keyestudio/KS0523-4WD-Mechanical-Robot-Arm-Smart-Car/index.rst

.. toctree::
   :maxdepth: 5
   :caption: KS0523 4WD Mechanical Robot Arm Smart Car

   KS0523.md
