keyestudio/KS0523-4WD-Mechanical-Robot-Arm-Smart-Car/KS0523.md

# **KS0523 4WD Mechanical Robot Arm Smart Car**

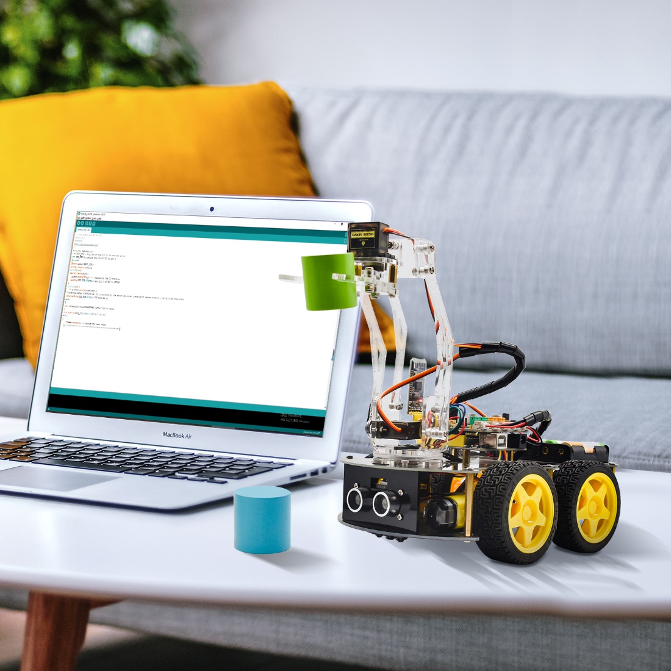
[picture p1: media/93024eaf6fdfefaf04d334aa68db944c.jpeg]


## Description

As science and technology develops by leaps and bounces, human society moves
towards an era of intelligence and automation as well.

Our hands are weak and unresistant to ultra-cold and high temperature
environment. In this regard, mechanical arms can totally supplant our hands and
work for people.

At present, KEYES group has designed this kind of smart mechanical arm car to
tackle the shortcomings of most robot arms, clumsy and fixed. This mechanical
smart car reacts and performs its functions by following commands sent by the
cellphone connected.

## Features

Multi-purpose Function: Anti-fall, obstacle avoidance, following, IR remote
control, line tracking, automatically convey and so on.

Easy to Build: soldering circuit is not required.

High Tenacity: high performance car baseplate and metal mechanical arm

High Extension: expand other sensors and modules through motor driver shield.

Multiple Controls: IR remote control, fully automatic and App control(iOS and
Android system)

Basic Programming：C language code learning.

## Specification

-   Working voltage: 5v

-   Input voltage: 7-12V

-   Maximum output current: 3A

-   Maximum power dissipation: 25W (T=75℃)

-   Motor speed: 5V 63 rpm / min

-   Motor drive form: TB6612 drive

-   Ultrasonic sensing angle: \<15 degrees

-   Ultrasonic detection distance: 2cm-400cm

-   Bluetooth remote control distance: 20-50 meters (measured)

-   Bluetooth APP control: support Android and iOS system

## Product Kit

| \##| Name | QTY | Picture |
|----|---|-----|---|
| 1  | Car Wheels 68\*26mm | 4 |  |
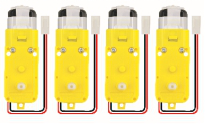
[picture p2: media/48959ebc4cbb2bbcdde2ef744a59845e.png]
| 2  | 4.5V 200rpm Motor | 4 |  |
| 3  | KEYESTUDIO PCB Baseplate for 4WD Smart Car V2.0 | 1 |  |
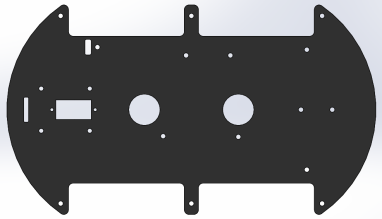
[picture p3: media/f55527de360c626bddf1b96a414f4ddc.png]
| 4  | KEYESTUDIO 4WD Top Board | 1 |  |
| 5  | Fixing Parts | 4 |  |
| 6  | KEYESTUDIO Quick Connectors Line Tracking Sensor | 1 |  |
| 7  | KEYESTUDIO Quick Connectors Ultrasonic Sensor | 1 |  |
| | | | |
| | | | |
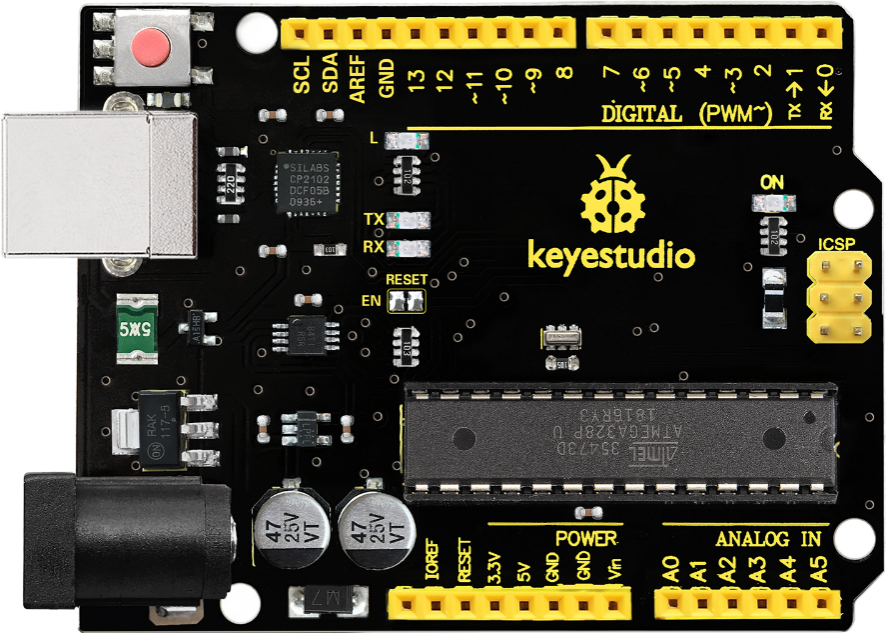
[picture p4: media/bd09f33acf28418b442de2a6e6a12eee.png]
| 8  | KEYESTUDIO V4.0 Development Board (Compatible Arduino Uno) | 1 |  |
| | | | |
| | | | |
| | | | |
| | | | |
| 9  | KEYESTUDIO TB6612 Motor Driver Shield | 1 |  |
| | | | |
| | | | |
| | | | |
| | | | |
| 10 | KEYESTUDIOHM-10 Bluetooth-4.0 V3 Module | 1 |  |
| | | | |
| 11 | KEYESTUDIO Quick Connectors IR Receiver | 1 |  |
| | | | |
| | | | |
| | | | |
| | | | |
| | | | |
| | | | |
| 12 | M2+M3 Wrench | 1 |  |
| 13 | KEYESTUDIO IR Remote Control | 1 |  |
| | | | |
| 14 | 18650 Battery Holder | 1 |  |
| | | | |
| | | | |
| | | | |
| | | | |
| 15 | 6-Slot AA Battery Holder | 1 |  |
| | | | |
| | | | |
| | | | |
| | | | |
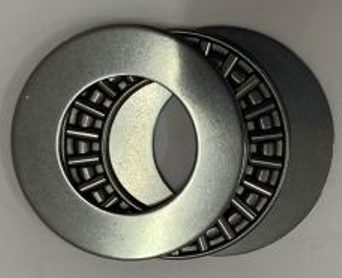
[picture p5: media/988bae05b3f6d02676c532adedece7c2.png]
| 16 | AXK Plain Bearing | 1 |  |
| | | | |
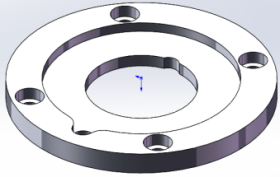
[picture p6: media/f3dc2b51d3d1f087ee034fb55b9fb7df.png]
| 17 | Bearing Cap （attached a yellow protective film） | 1 |  |
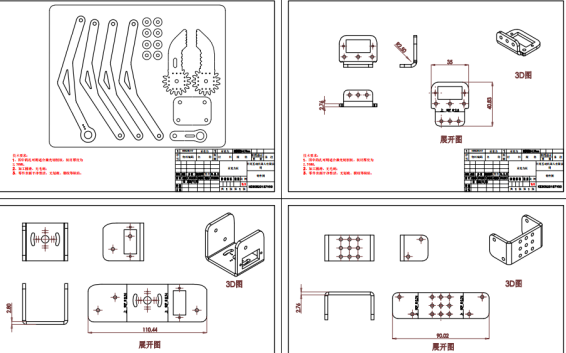
[picture p7: media/892303c46b050c0fb7cb775305685271.png]
| 18 | 19Pcs Acrylic Robot Arm Parts T=3mm | 1 |  |
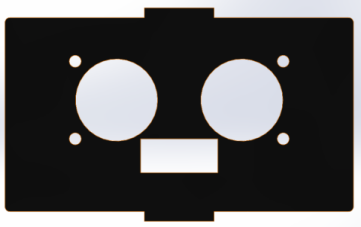
[picture p8: media/012500cac601bc526e0f18ce12cb2f6d.png]
| 19 | 73\*44MM Black Acrylic Board | 1 |  |
| 20 | Dual-head JST-PH2.0MM-5P 24AWG Dupont Wire 15CM Lead | 1 |  |
| | | | |
| | | | |
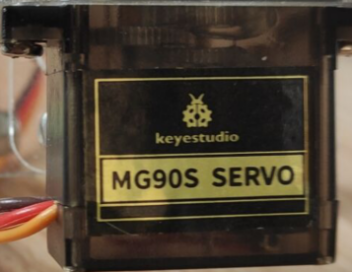
[picture p9: media/1dd13302041098798ba6626e98272e12.png]
| 21 | KEYESTUDIO MG90S 14G Servo | 3 |  |
| | | | |
| | | | |
| | | | |
| 22 | Dual-head JST-PH2.0MM-3P 24AWG 8CM Dupont Wire | 1 |  |
| 23 | 2.0\*40MM Purple and Black Screwdriver | 1 |  |
| 24 | 8MM Winding Pipe | 1 |  |
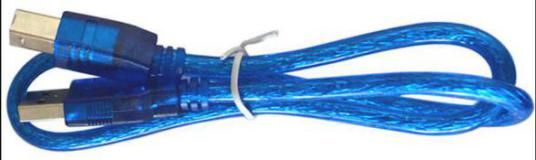
[picture p10: media/900d9583a767f7ddc92cc1082caa03f5.jpeg]
| 25 | USB Cable AM/BM OD:5.0 L=50cm | 1 |  |
| 26 | M3 Nickel Plated Nuts | 21  |  |
| 27 | M3\*30MM Round Head Screws | 8 | |
| 28 | M3\*6MM Round Head Screws | 38  |  |
| 29 | Dual-pass M3\*40MM Hex Copper Bush | 6 | |
| 30 | M3\*8MM Round Head Screws | 6 |  |
| 31 | Dual-pass M3\*10MM Hex Copper Bush | 4 | |
| 32 | M3\*10MM Flat Screws | 4 | |
| 33 | M1.4X6 Self-tapping Round Head Screws | 6 | |
| 34 | M2\*10MM Round Head Screws | 8 | |
| 35 | M2 Nickel Plated Nuts | 6 |  |
| 36 | M3\*10MM Round Head Screws | 8 | |
| 37 | M3\*12MM Round Head Screws | 6 | |
| 38 | M3\*16MM Round Head Screws | 2 | |
| 39 | M3 Nickel Plated Self-locking Nuts | 14  | |
| 40 | Dual-pass M3\*15MM Hex Copper Bush | 2 | |
| 41 | M2\*5MM Self-tapping Round Head Screws | 4 | |
| 42 | M1.2\*5MM Self-tapping Round Head Screws | 4 | |
| 43 | 20cm 3pin F-F Dupont Wire | 2 |  |
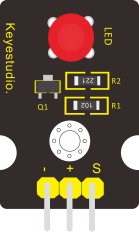
[picture p11: media/c302ce2fda045f9b0e2fbf05f4a6e7ee.png]
| 44 | KEYESTUDIO Red LED Module | 1 |  |
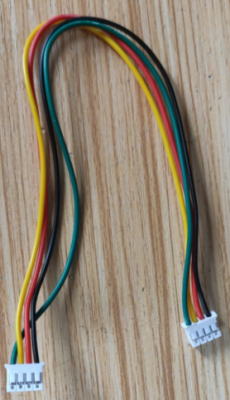
[picture p12: media/9d31ddba2c6df11d32870b55de5ce249.png]
| 45 | PH2.0mm-4P 24AWG 200MM Dupont Wire Eco-friendly | 1 |  |
| 46 | 3\*40MM Red and Black Screwdriver | 1 |  |
| 47 | Black Ties 3\*100MM | 6 | |
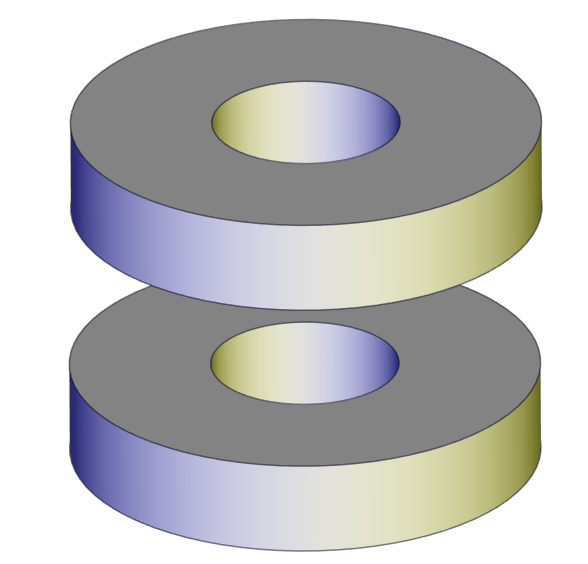
[picture p13: media/9f09c826368dc2cf7fc0449516f61399.png]
| 48 | Insulation Gasket | 4 |  |
| 49 | M2.5\*12MM Round Head Screws | 6 | |
| 50 | M2.5 Nickel Plated Nuts | 6 | |

## Getting Started with Arduino

1.  **Installing Arduino IDE**

When we get control board, we need to download Arduino IDE and driver in the
first place.

You can download Arduino IDE from the official website:

<https://www.arduino.cc/>, and click the **SOFTWARE \> DOWNLOADS**, as shown
below:

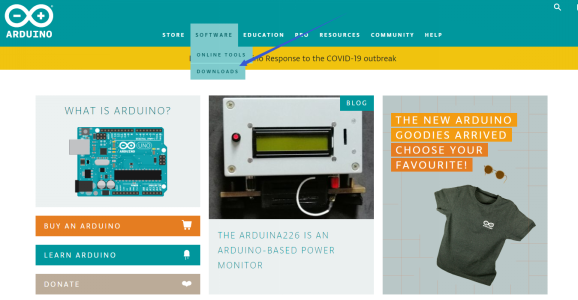
[picture p14: media/4636aac9aca9b3aa9d86580caac51b81.png]


There are many versions for Arduino software, and you only need to download the
version suitable for system. Here, we will take WINDOWS system as an example to
introduce how to download and install Arduino IDE.

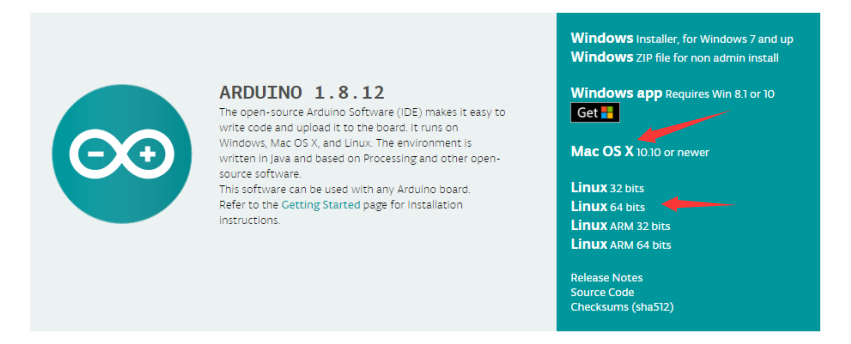
[picture p15: media/a964bfdcfb4a1ae25e5698623c5fc6bf.png]


There are two versions you can choose from, one is an installer which can be
directly downloaded in computer; the other is a zip file which requires you to
unzip and install it.

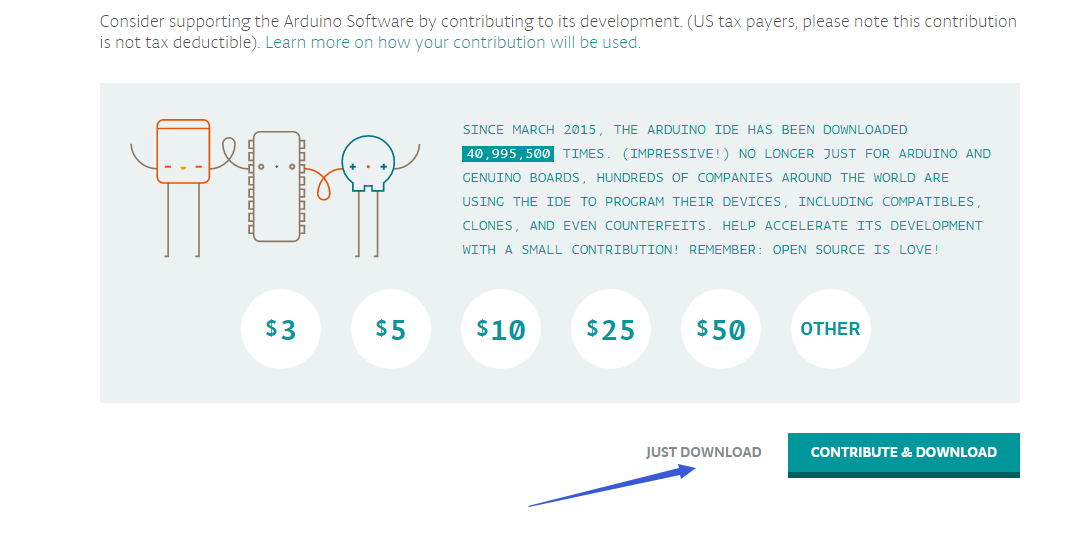
[picture p16: media/745910f7138b08d5cbcb557f194b0679.png]


Just click“JUST DOWNLOAD”.

1.  **KEYESTUDIO V4.0 Development Board**

You need to know that Keyestudio V4.0 development board is the core of this
smart car.



Keyestudio V4.0 development board is an Arduino uno -compatible board, which is
based on ATmega328P MCU, and with a cp2102 Chip as a UART-to-USB converter.

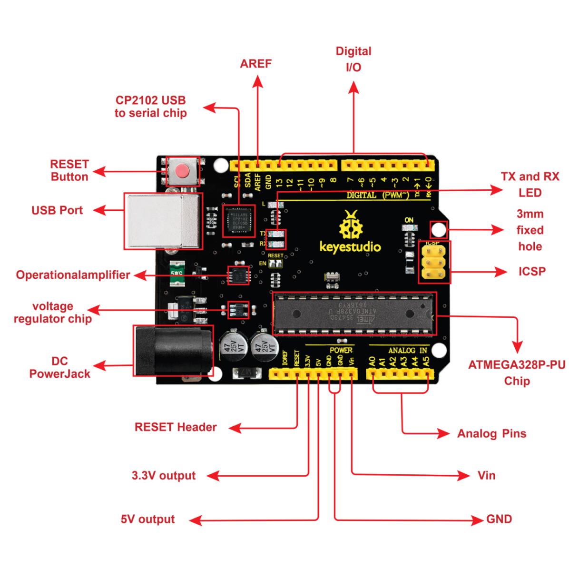
[picture p17: media/90e3efbcae2f75e4c40a6bb9c616365e.jpeg]
  
It has 14 digital input/output pins (of which 6 can be used as PWM outputs), 6
analog inputs, a 16 MHz quartz crystal, a USB connection, a power jack, 2 ICSP
headers and a reset button.

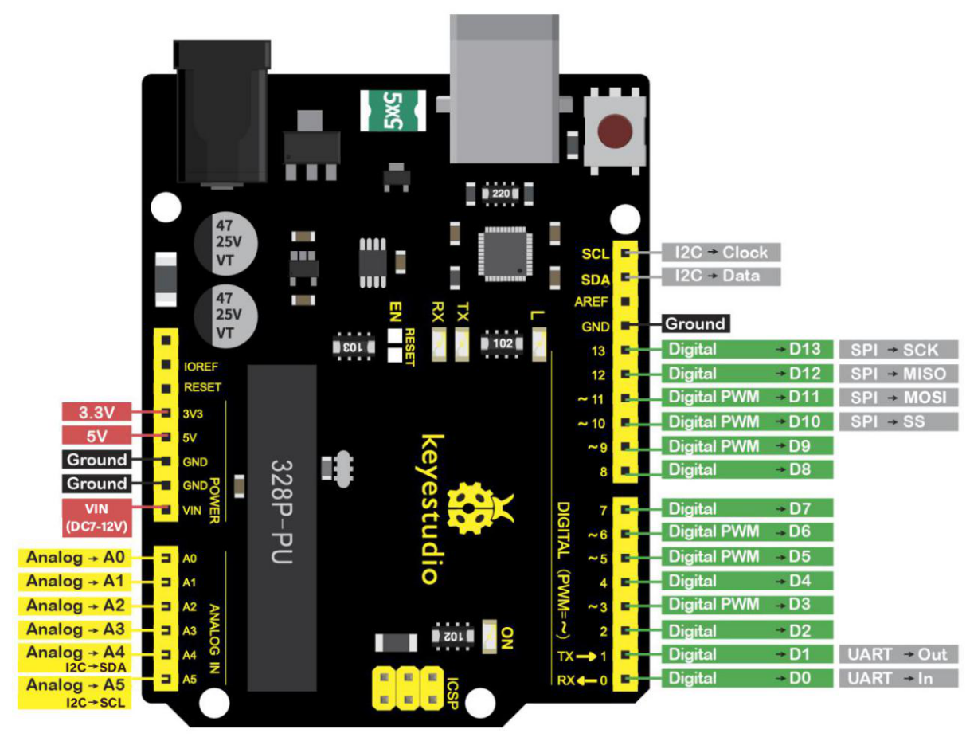
[picture p18: media/2321b7892f3e38262c2f32e324108b2f.png]


It contains everything needed to support the microcontroller. Simply connect it
to a computer with a USB cable or power it via an external DC power jack (DC
7-12V) or via female headers Vin/ GND(DC 7-12V) to get started.

| Microcontroller | ATmega328P-PU |
|---|---|
| Operating Voltage | 5V |
| Input Voltage (recommended) | DC7-12V |
| Digital I/O Pins | 14 (D0-D13) (of which 6 provide PWM output) |
| PWM Digital I/O Pins | 6 (D3, D5, D6, D9, D10, D11) |
| Analog Input Pins | 6 (A0-A5) |
| DC Current per I/O Pin | 20 mA |
| DC Current for 3.3V Pin | 50 mA |
| Flash Memory | 32 KB (ATmega328P-PU) of which 0.5 KB used by bootloader |
| SRAM | 2 KB (ATmega328P-PU) |
| EEPROM | 1 KB (ATmega328P-PU) |
| Clock Speed | 16 MHz |
| LED_BUILTIN | D13 |

1.  **Installing Driver of V4.0 Board**

Let’s install the driver of V4.0 board. The USB-TTL chip on PLUS board adopts
CP2102 serial chip. The driver program of this chip is included in Arduino 1.8
version and above, which is convenient.

if the version is not above 1.8, you need to download driver of CP2102 in the
link:

<https://www.silabs.com/products/development-tools/software/usb-to-uart-bridge-vcp-drivers>)

When you attach USB port to computer, the driver of CP2102 can be installed.

If you install unsuccessfully, or intend to install manually, please open the
device manager of computer. Right click Computer----- Properties----- Device
Manager.

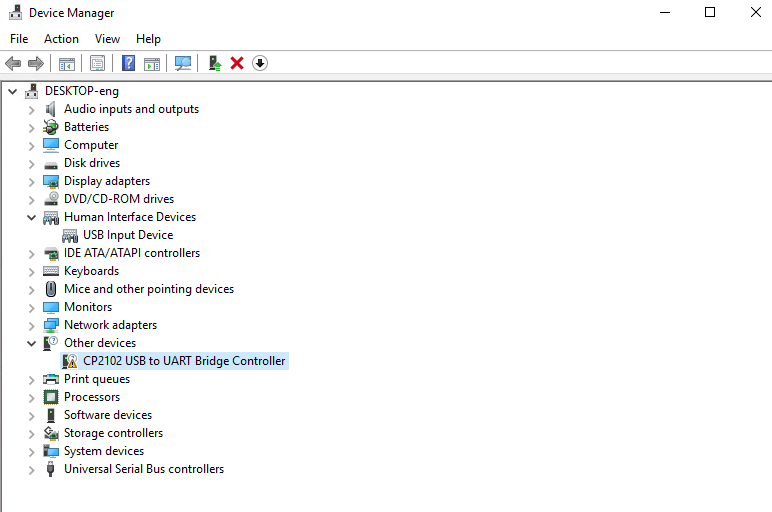
[picture p19: media/afa5b0dde9342bd7ad9f385333cb6f55.png]


There is a yellow exclamation mark on the page, which implies the failure
installation of the driver of CP2102.

Operate as follows；

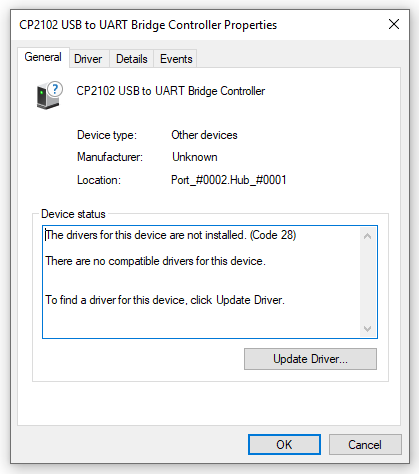
[picture p20: media/c26ca0ef1bf1506c815b6e3e239cf525.png]


Click “OK” to enter the following page and click “browse my computer for updated
driver software”.

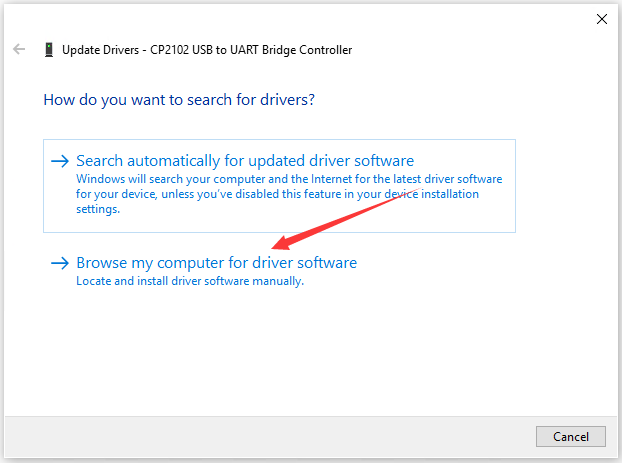
[picture p21: media/4ec7a5ea3c8a1fd9663eef4768b687c5.png]


Click “Browse”, then search the driver of CP2102 and click “Next”,

There is a DRIVERS folder in Arduino software installed
package（）, open driver folder
and check the driver of CP210X series chips.

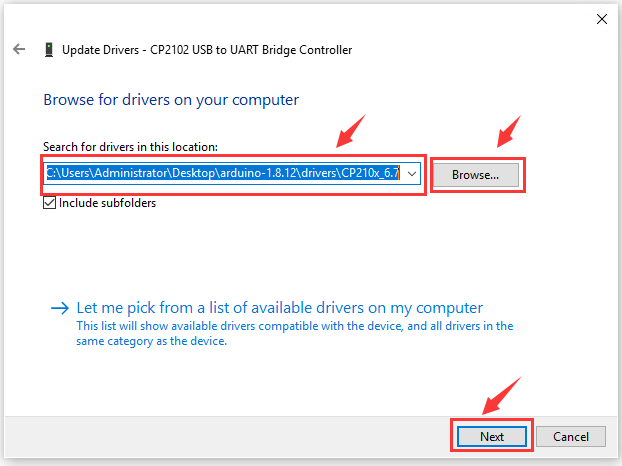
[picture p22: media/417de936fa9720c7a7427c4d07718292.png]


When opening the device manager, we will find the yellow exclamation mark
disappear. The driver of CP2102 is installed successfully.

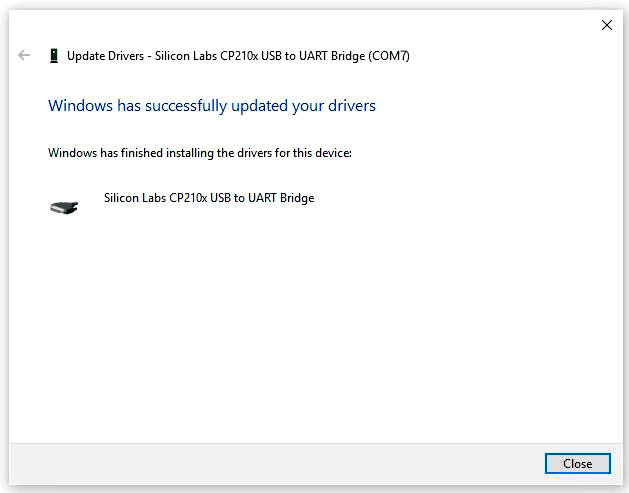
[picture p23: media/efce0ba96c48d853f302730b4d481ee9.jpeg]


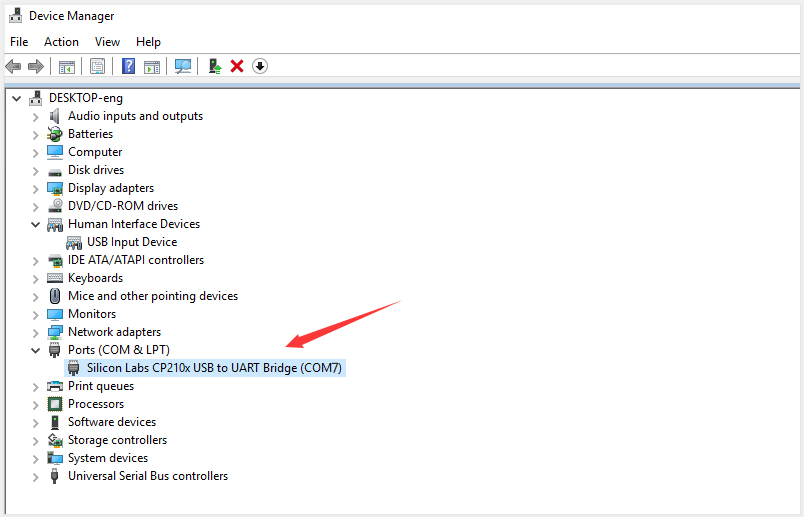
[picture p24: media/2f751d5f4e4c0c18fa862c589eaaf0da.jpeg]


1.  **Arduino IDE Setting**

Clickicon, and open Arduino IDE.

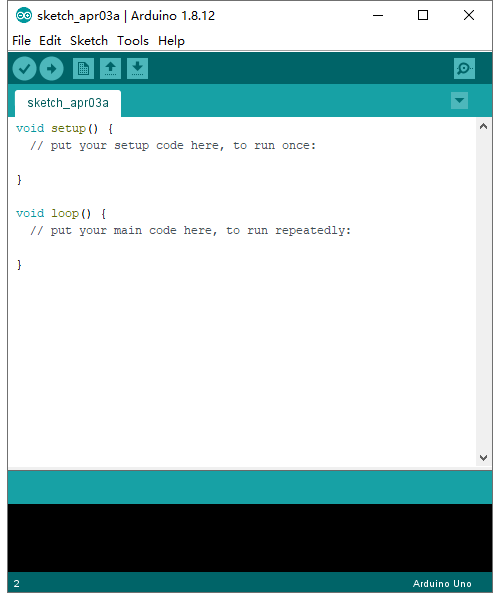
[picture p25: media/e9a2d59afcff8121d18d8767326baa42.png]


When downloading the sketch to the board, you must select the correct name of
Arduino board that matches the board connected to your computer. As shown below;

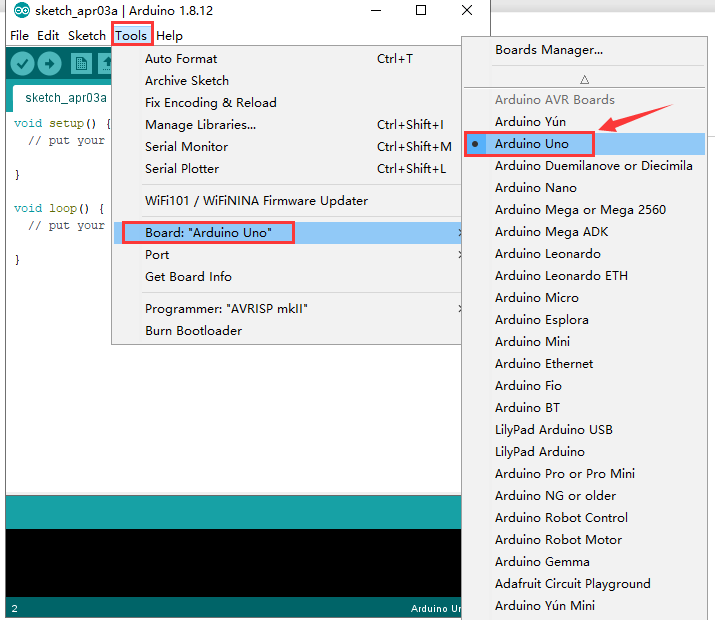
[picture p26: media/84317a7babddff172520b99756dc1f85.png]


Then select the correct COM port (you can see the corresponding COM port after
the driver is successfully installed)

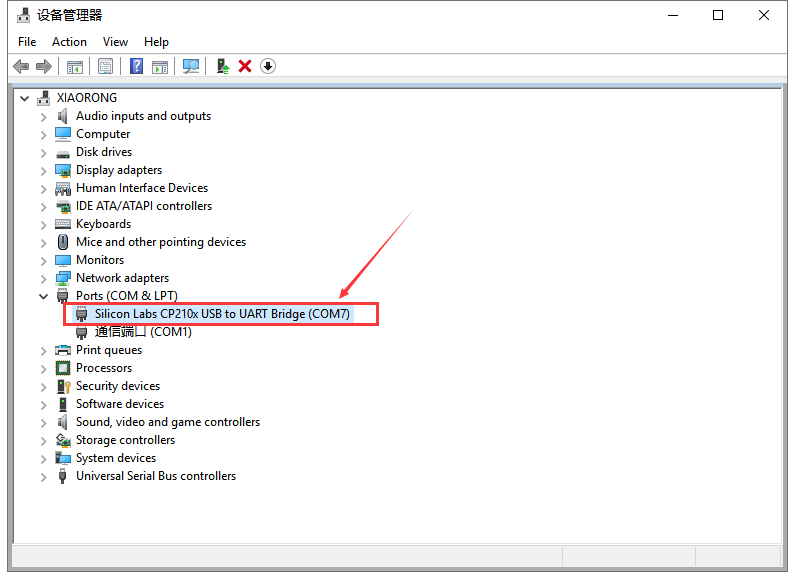
[picture p27: media/6ec68bee80c913c6ad392c6e7898ed36.png]


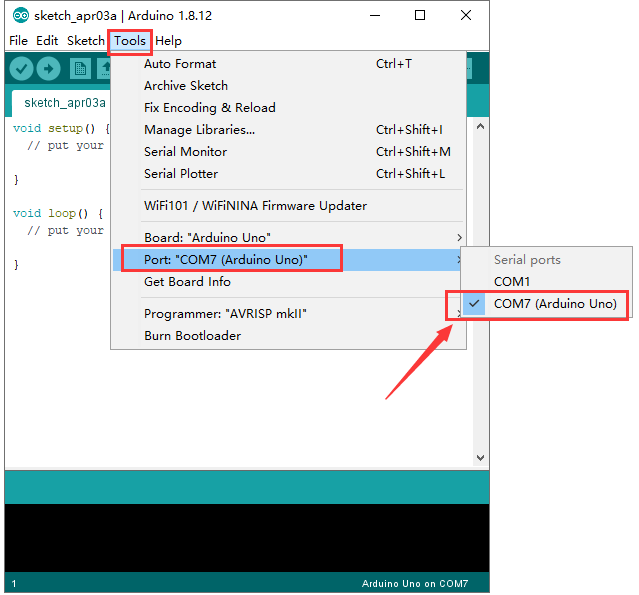
[picture p28: media/bcd36a3d3e1209c16866e554089832d5.png]


Before uploading the program to the board, let’s demonstrate the function of
each symbol in the Arduino IDE toolbar.

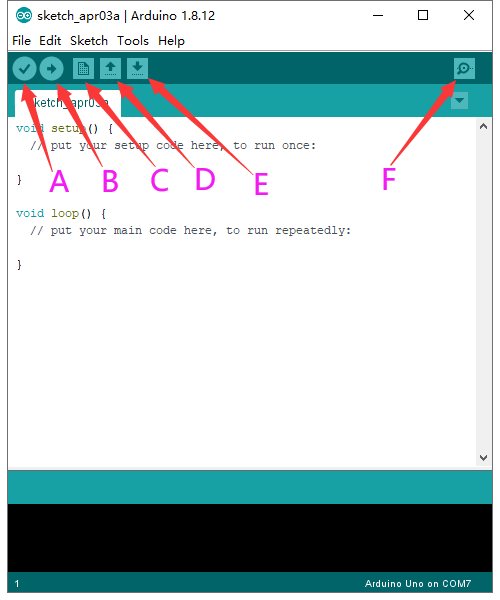
[picture p29: media/2598b31529ac4bff88630522b97b6c41.png]


A- Used to verify whether there is any compiling mistakes or not.  
B- Used to upload the sketch to your Arduino board.  
C- Used to create shortcut window of a new sketch.  
D- Used to directly open an example sketch.  
E- Used to save the sketch.  
F- Used to send the serial data received from board to the serial monitor.

**(5) Start Your First Program**

Open the file to select **Example**, and click **BASIC**\>**BLINK**, as shown
below:

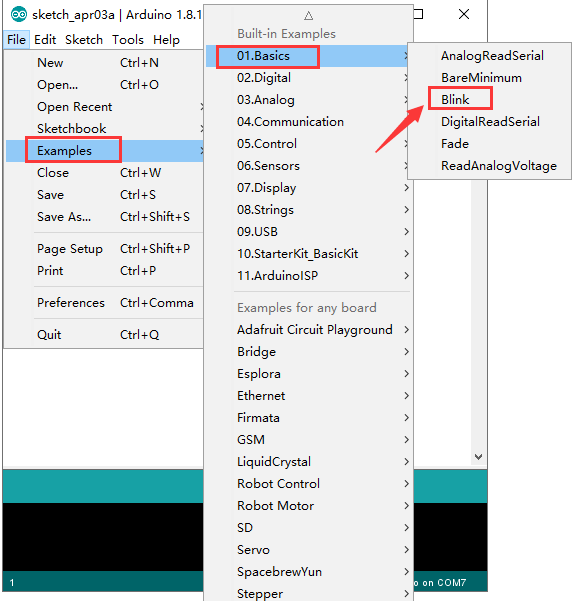
[picture p30: media/2a6a0b8b8e2585776e01873caf10a1b0.png]


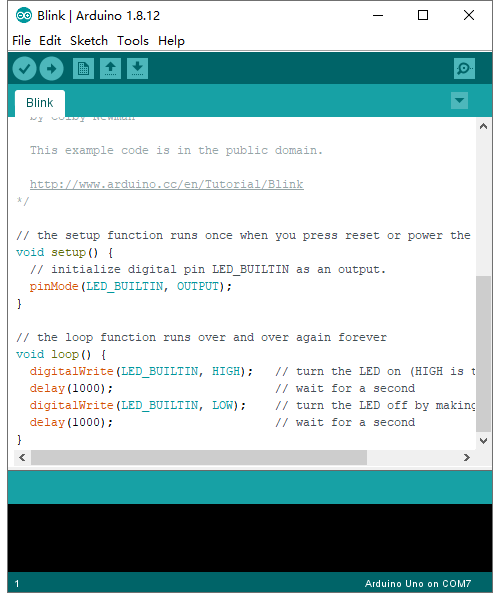
[picture p31: media/6030cde1341c3432f0f4b1fb6c92e49e.png]


Set board and COM port, the corresponding board and COM port are shown on the
lower right of IDE.

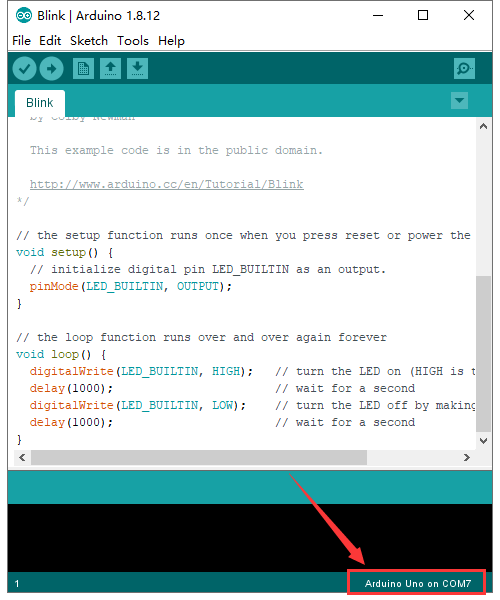
[picture p32: media/5c4521f3fa5c4f4c0a5c9d1581ab1580.png]


Clickto start compiling the
program, and check errors.

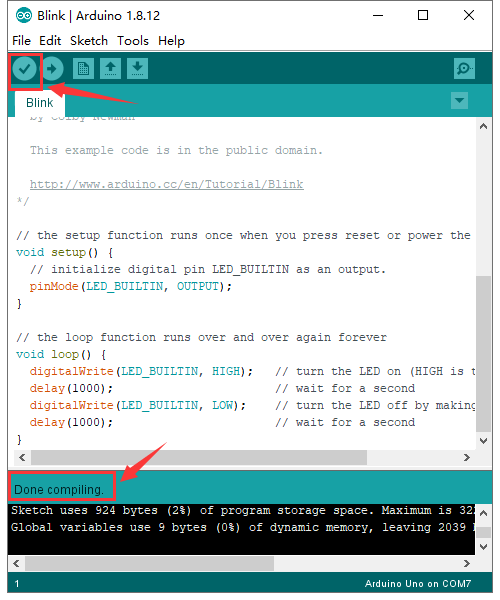
[picture p33: media/9948cd36a3b39cb57fd2bea79540c4b7.png]


Clickto upload the program,
upload successfully.

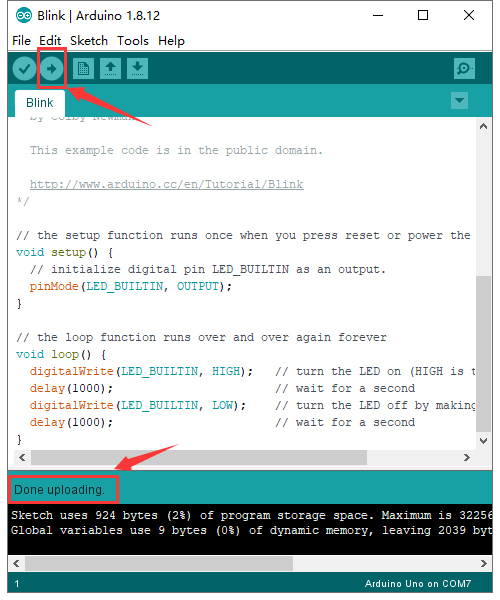
[picture p34: media/60e002aacf662c1ecf88ad3ecd85e6ca.png]


After the program is uploaded successfully, the onboard LED blinks.
Congratulation, you finish the first program.

**6.Add project Libraries**

**(1) What are Libraries ?**

[Libraries](https://www.arduino.cc/en/Reference/Libraries) are a collection of
code that makes it easy for you to connect to a sensor,display, module, etc.

For example, the built-in LiquidCrystal library helps talk to LCD displays.
There are hundreds of additional libraries available on the Internet for
downloading.

The built-in libraries and some of these additional libraries are listed in the
reference.

**(2) How to Install a Library ?**

Here we will introduce the most simple way for you to add libraries.  
\*\*Step 1：\*\*After downloading well the Arduino IDE, you can right-click the
icon of Arduino IDE.  
Find the option "Open file location" shown as below:

[

**Step 2:** Enter it to find out libraries folder, this folder is the library
file of Arduino.

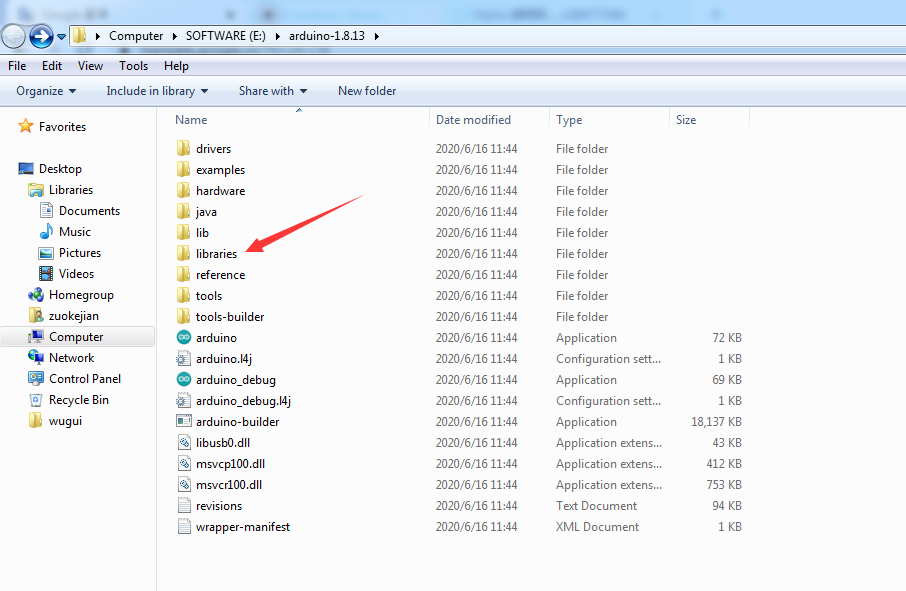
[picture p35: media/a67a5b5921be4dbc1b0ce92627111d15.png]


**Step 3：** Next to find out the“libraries”folder of robot arm car(seen in the
link:https://fs.keyestudio.com/KS0523), you just need to replicate and paste it
into the libraries folder of Arduino IDE.

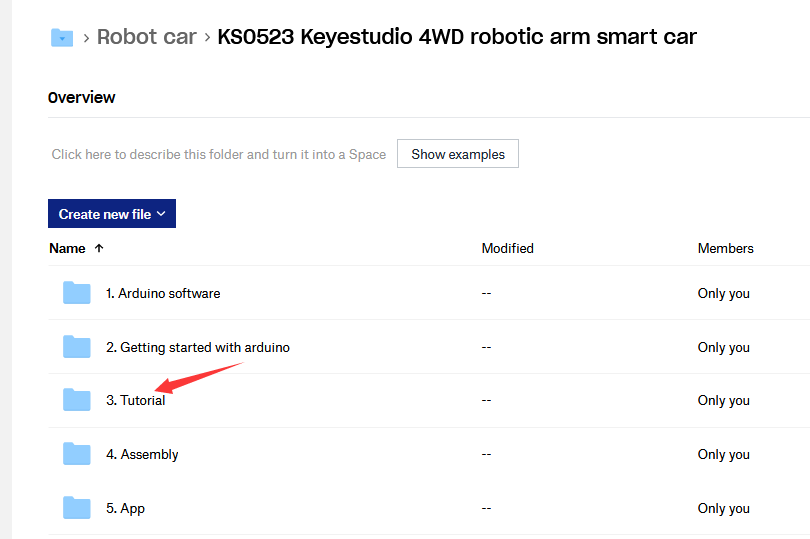
[picture p36: media/60a4210e42d3dc65af1157d37223203d.png]


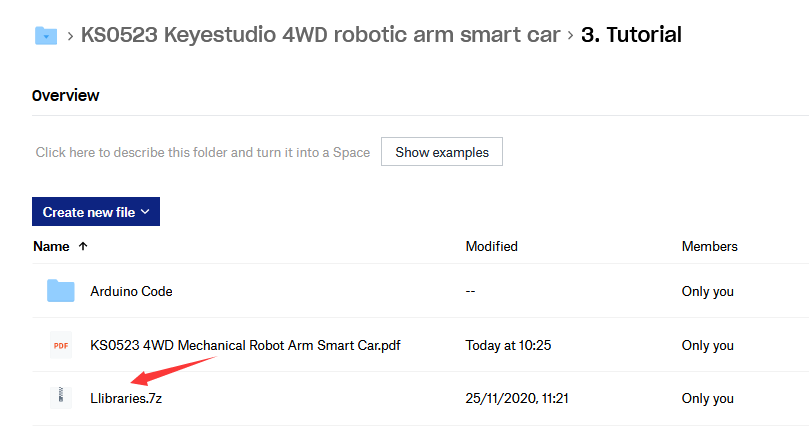
[picture p37: media/8630eea9defbecaf64c5fe32a0f0a2a5.png]


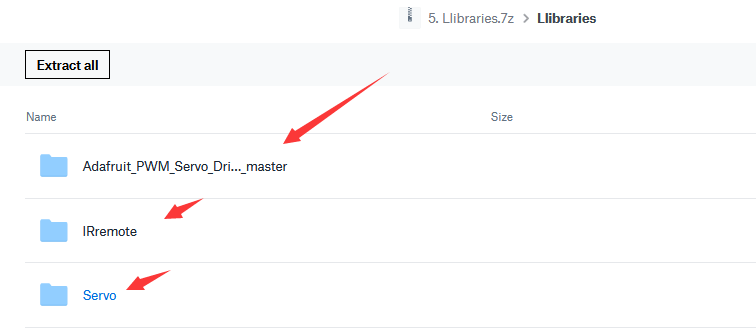
[picture p38: media/b96a3a692e4cc6014b4928c64a189ade.png]


Download the above libraries and copy them in the libraries of Arduino.

Then the libraries of robot arm car are installed successfully, as shown below:

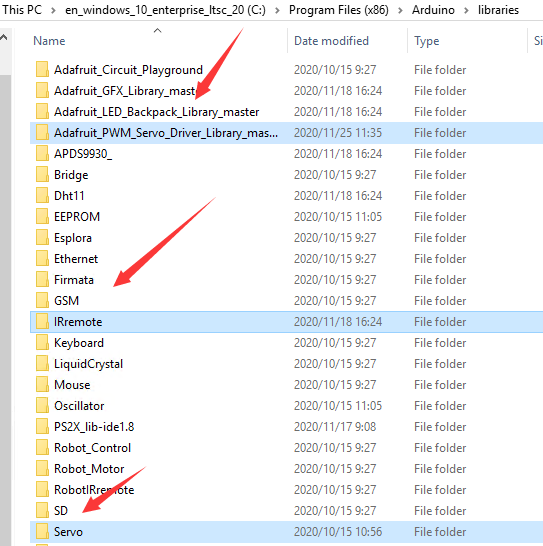
[picture p39: media/6900d5cd6168f00a89a282485eea1879.png]


## Install Robot Arm Smart Car

Note: Peel the plastic film off the board first when installing the smart car.

| | |
|---|---|
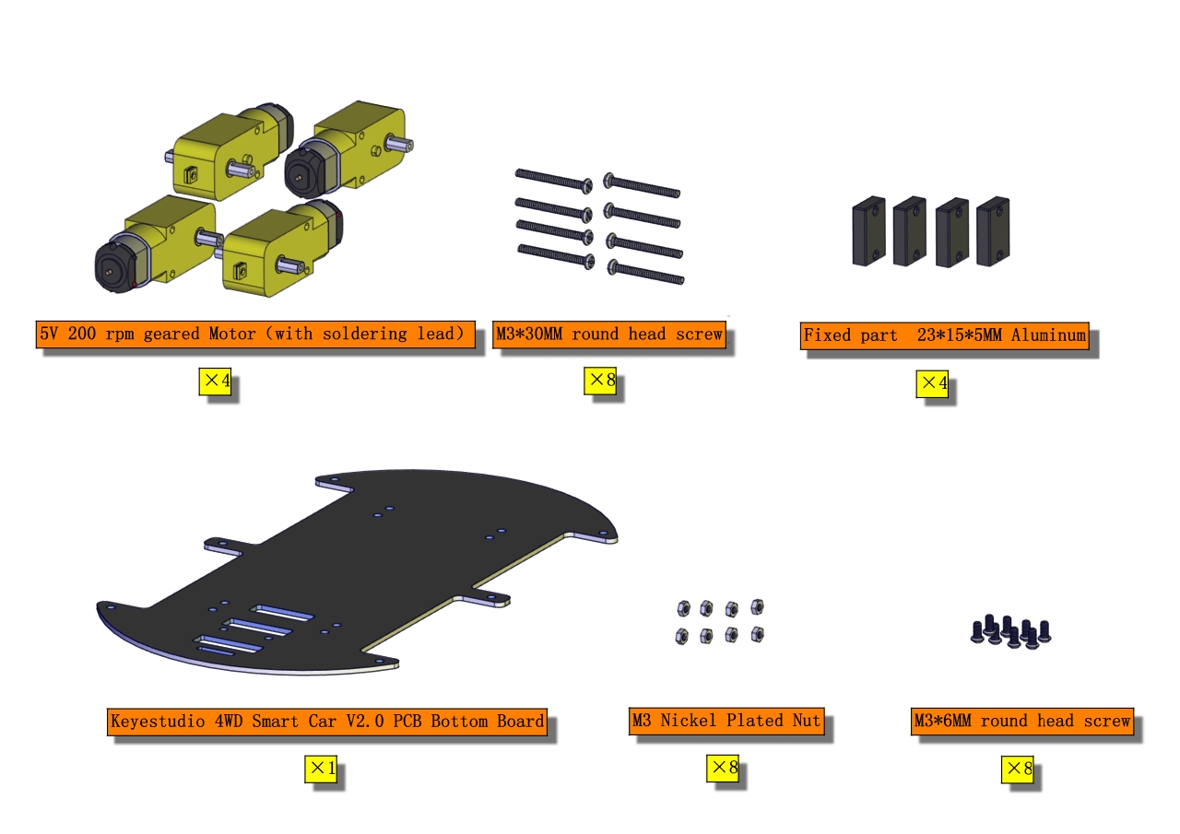
[picture p40: media/04228fa1b44016c5791f4582b0382988.jpeg]
|  | |
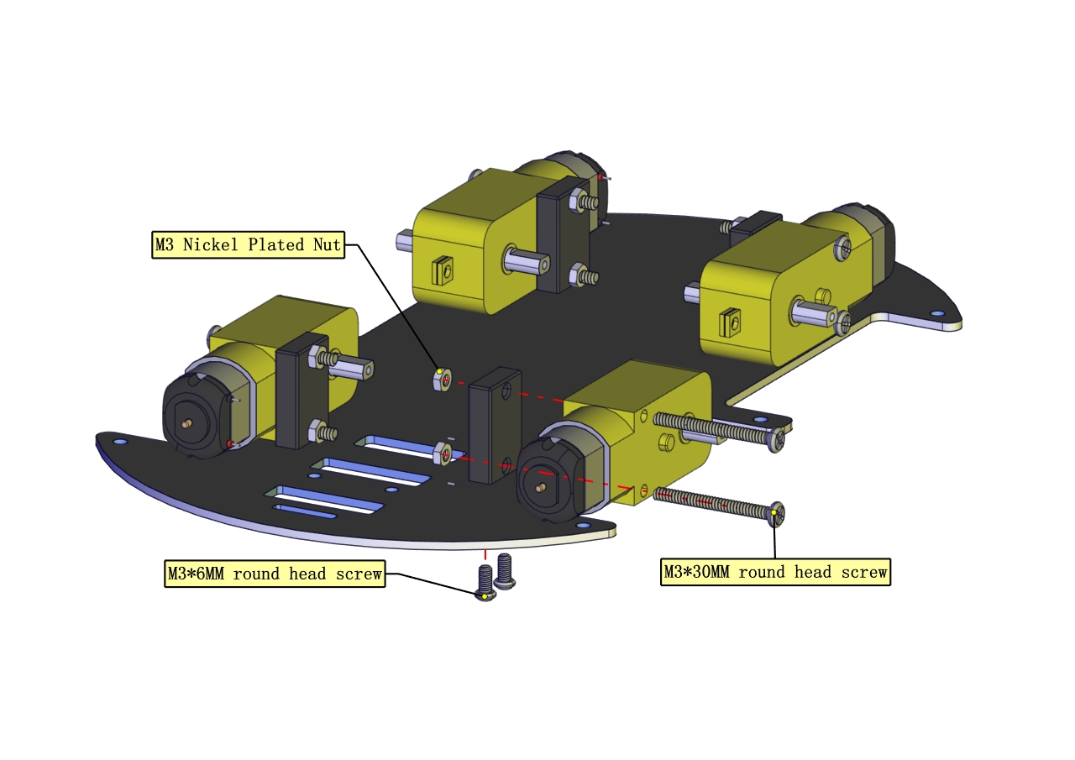
[picture p41: media/b1c4f0b202f8287268e8a97d3e3fb0a4.jpeg]
|  | |
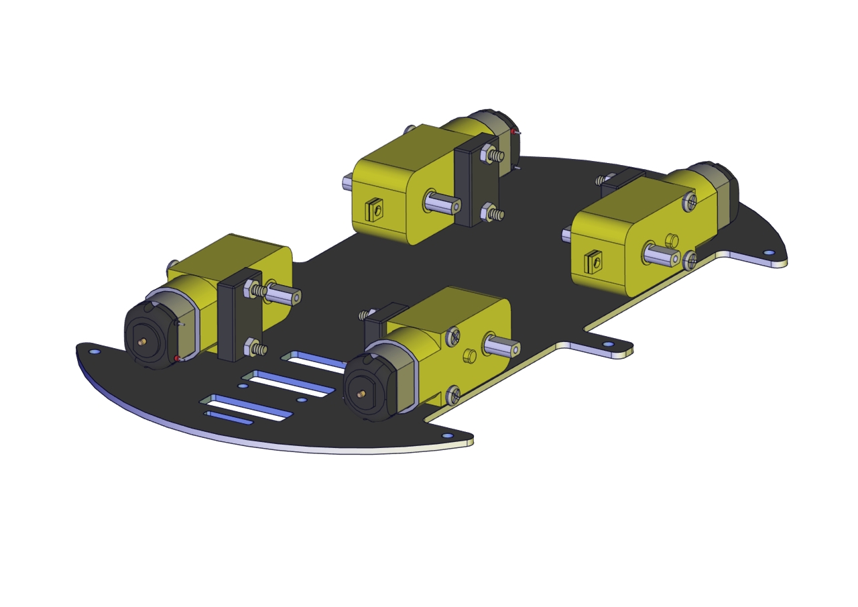
[picture p42: media/c263b9082c9447c8f7707f7199327132.jpeg]
|  | |
| | |
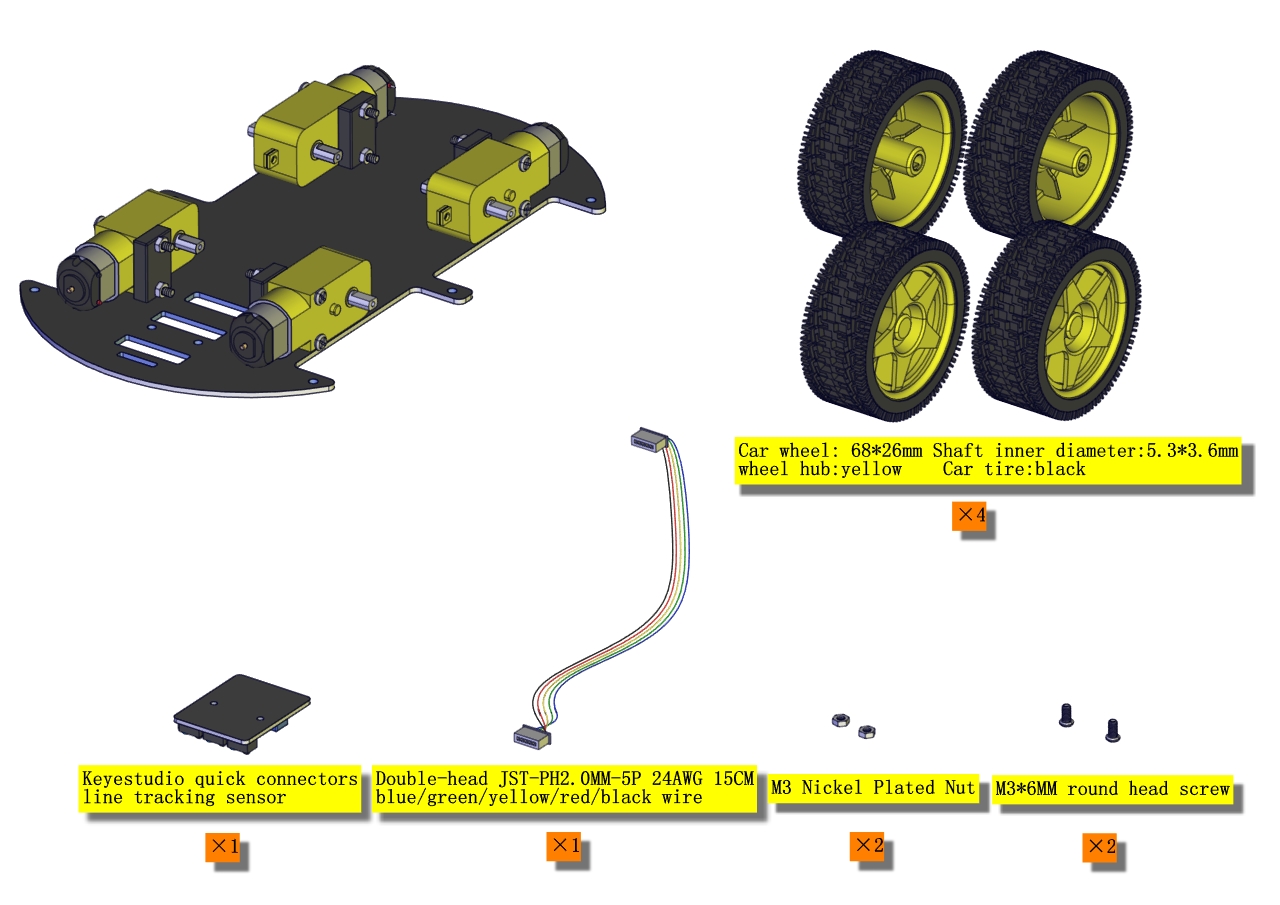
[picture p43: media/6cfe833aa78a7e776a8ab48183e1f633.jpeg]
|  | |
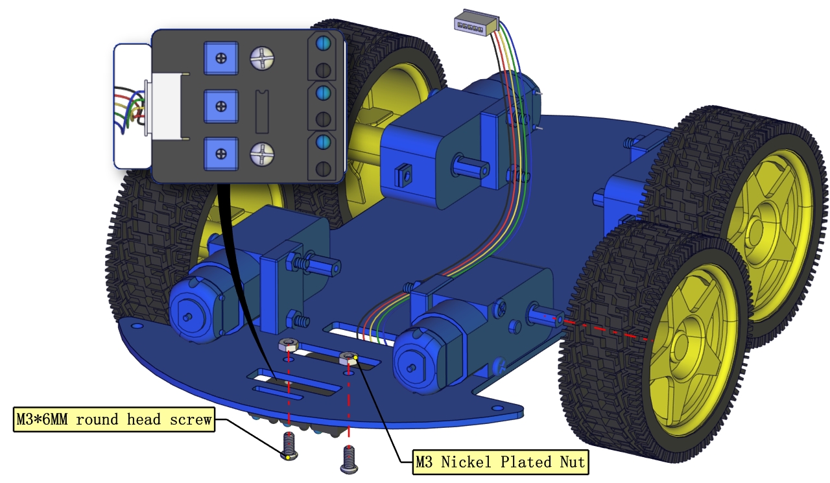
[picture p44: media/9959ae39832b42274bef49d9778197a6.jpeg]
|  | |
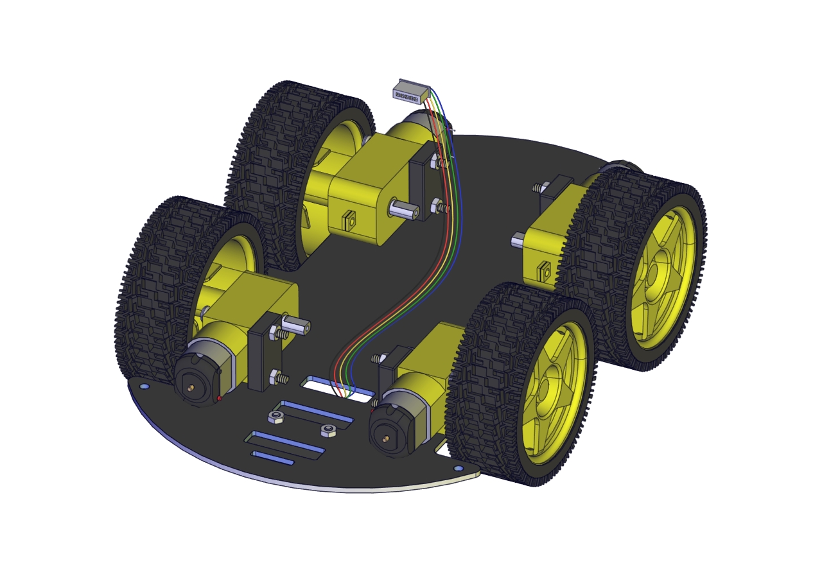
[picture p45: media/d6d31c652b8fafaf5c1c5ba9153d9075.jpeg]
|  | |
| | |
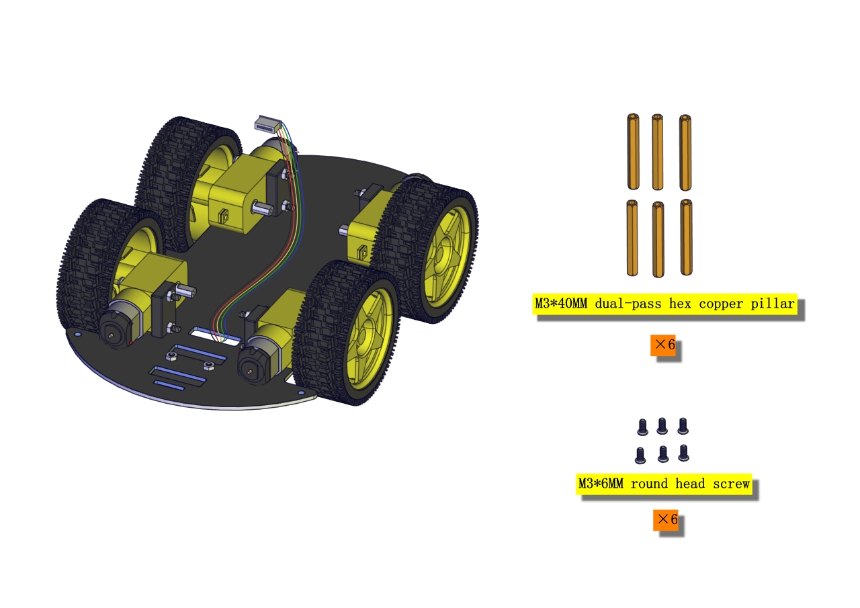
[picture p46: media/d432011907b2e322d57c9aebfbf8e48b.jpeg]
|  | |
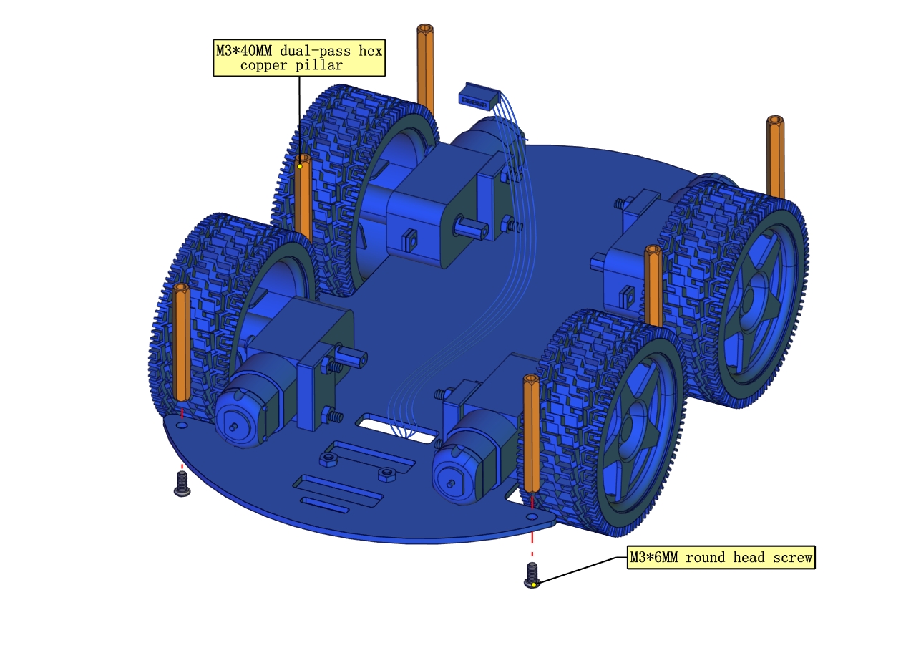
[picture p47: media/7c501be2c7d9e5129a4ddc23d70bad67.jpeg]
|  | |
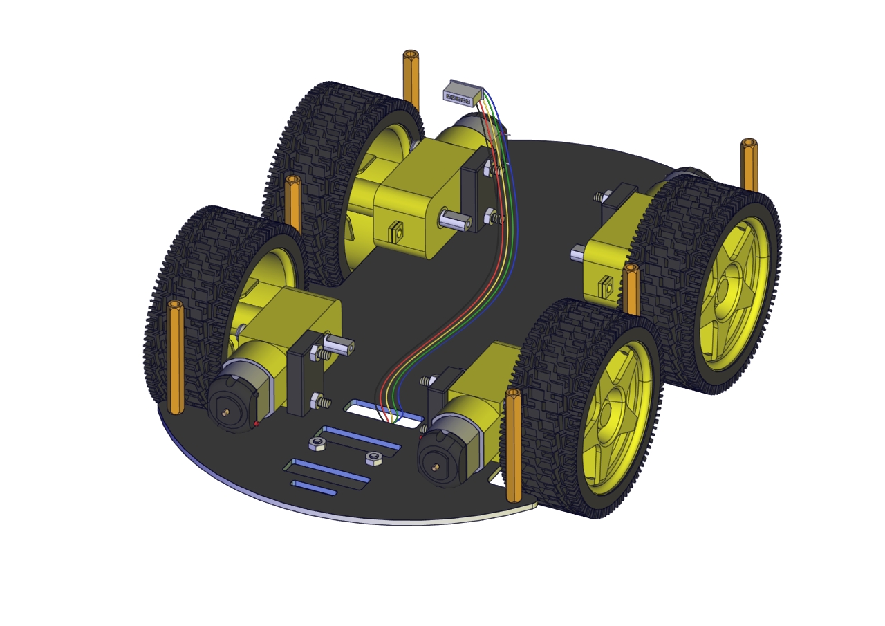
[picture p48: media/023af133ecb16c239d321f06770fbf5d.jpeg]
|  | |
| | |
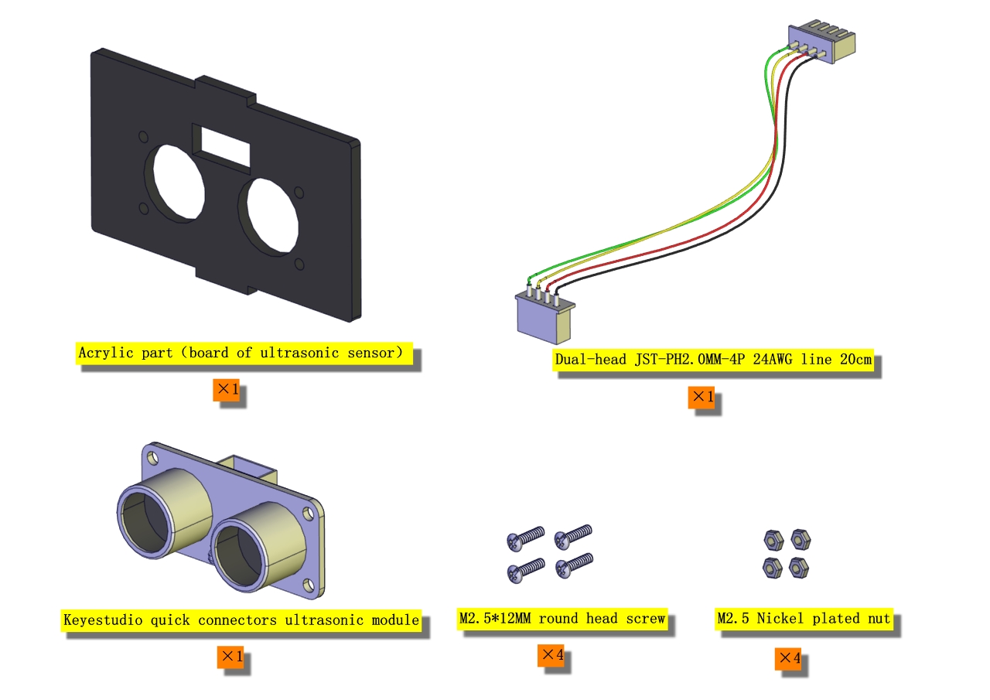
[picture p49: media/52c536ca6a4b2233f996e4939b09bfa5.jpeg]
|  | |
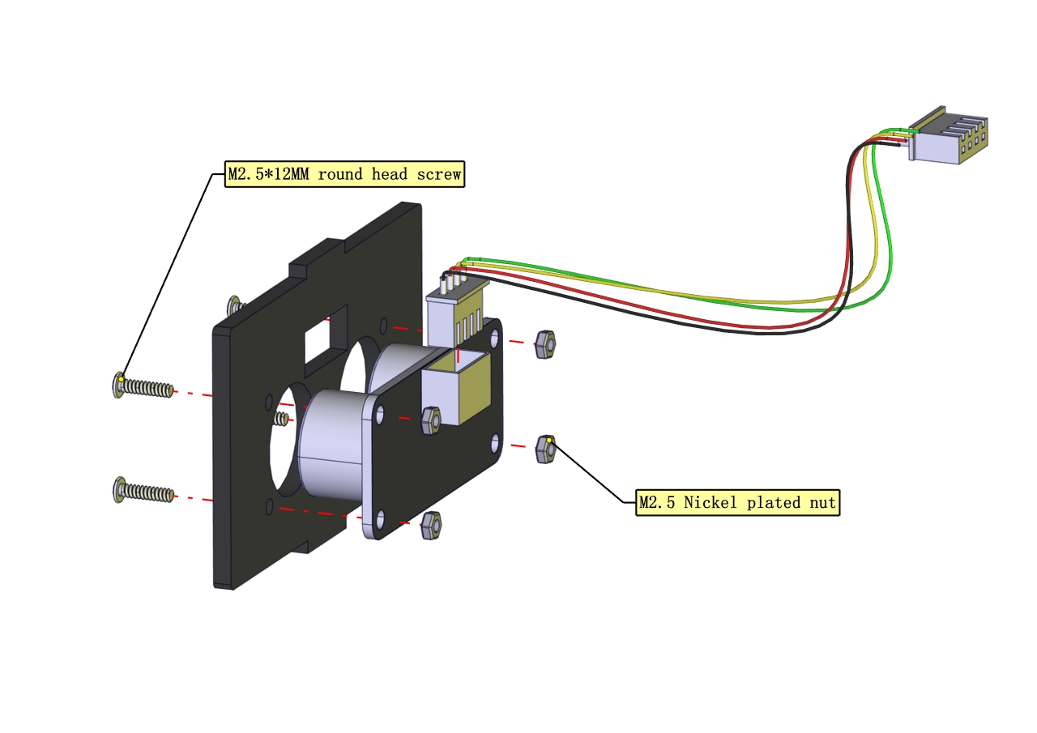
[picture p50: media/751083fb98bd906b638309970fe5cbe7.jpeg]
|  | |
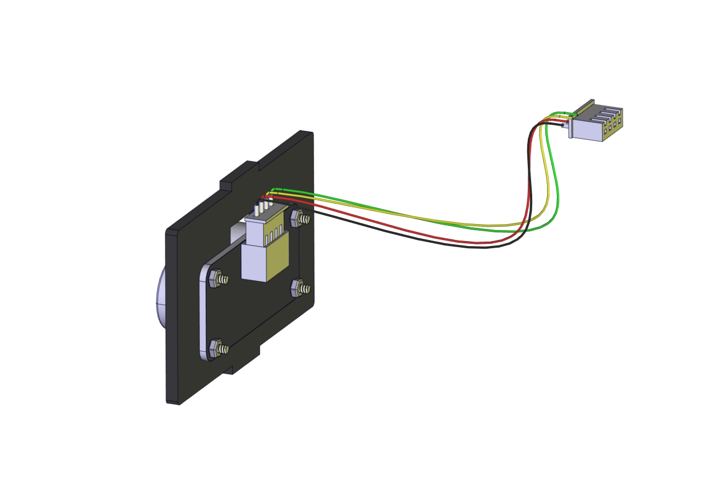
[picture p51: media/46d8e898e0c71cb305f5f08785a065ac.jpeg]
|  | |
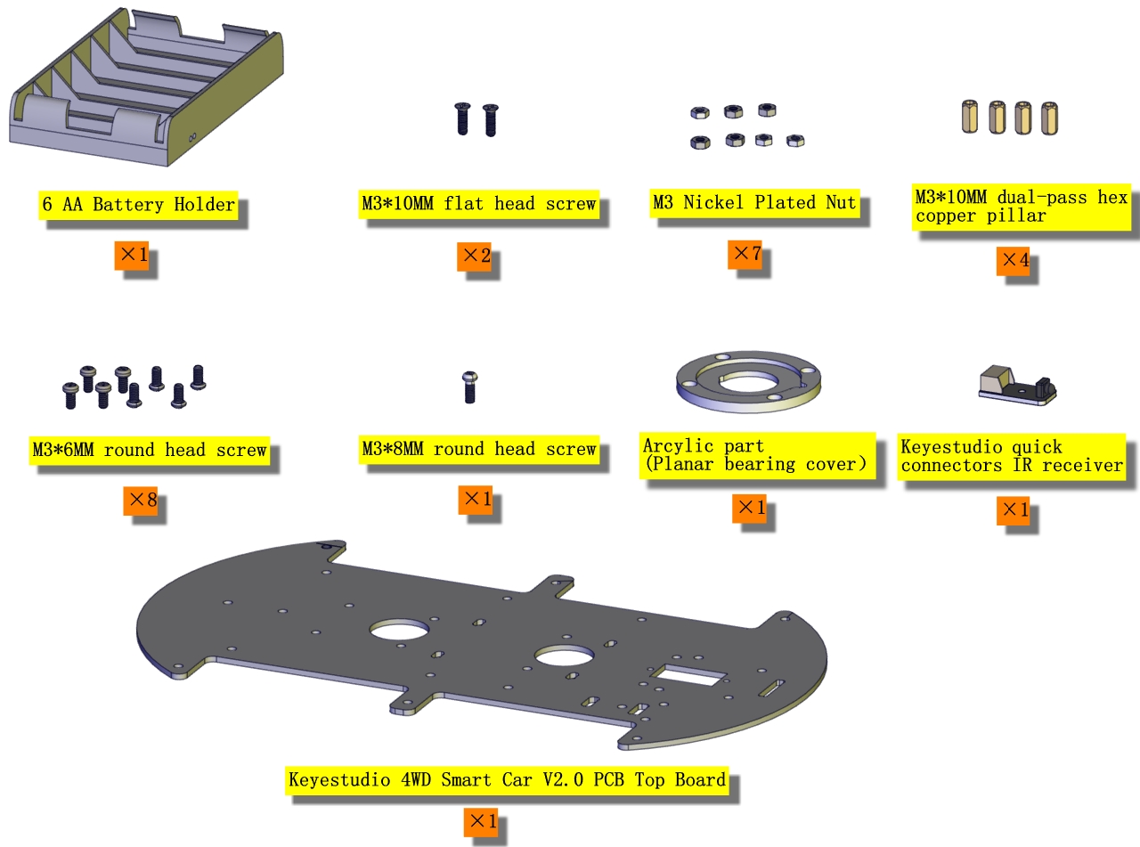
[picture p52: media/5774550fb0474c73d662ff3311caef68.jpeg]
|  | |
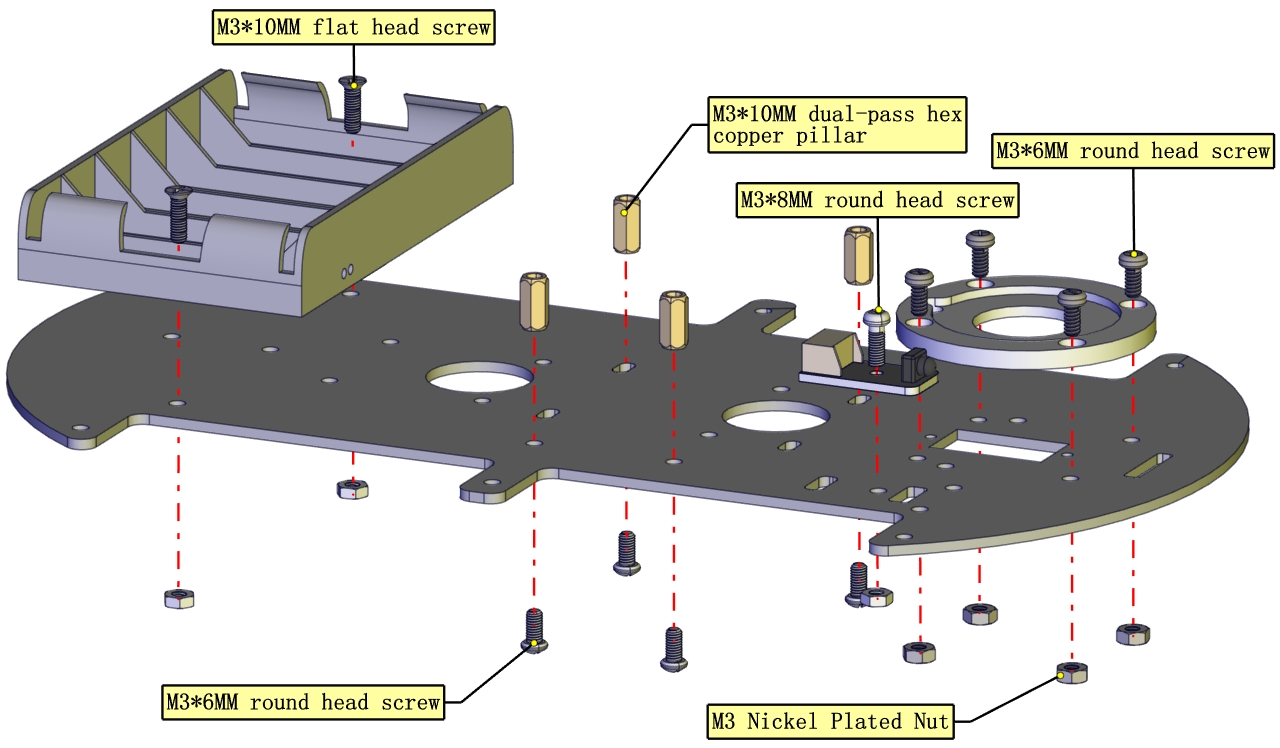
[picture p53: media/149b30c9b14e028660d1c12bf8a414fd.jpeg]
|  | |
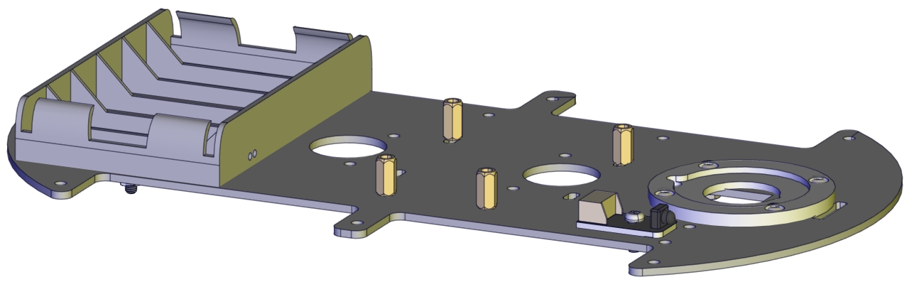
[picture p54: media/9bce3e52c87378e936a4dc1465d6dde8.jpeg]
| **** | |
| | |
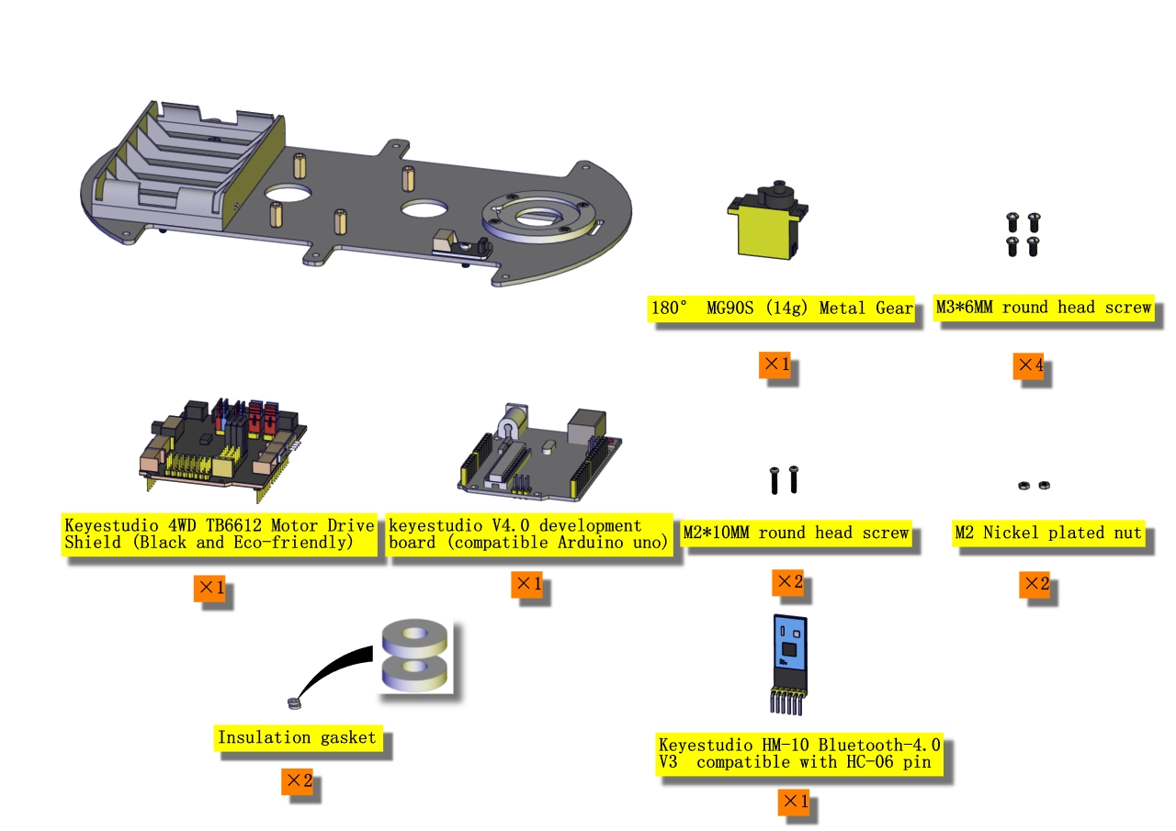
[picture p55: media/0489db19dcff7c7f85153fb3f756f1c6.jpeg]
| This is servo 3 |  |
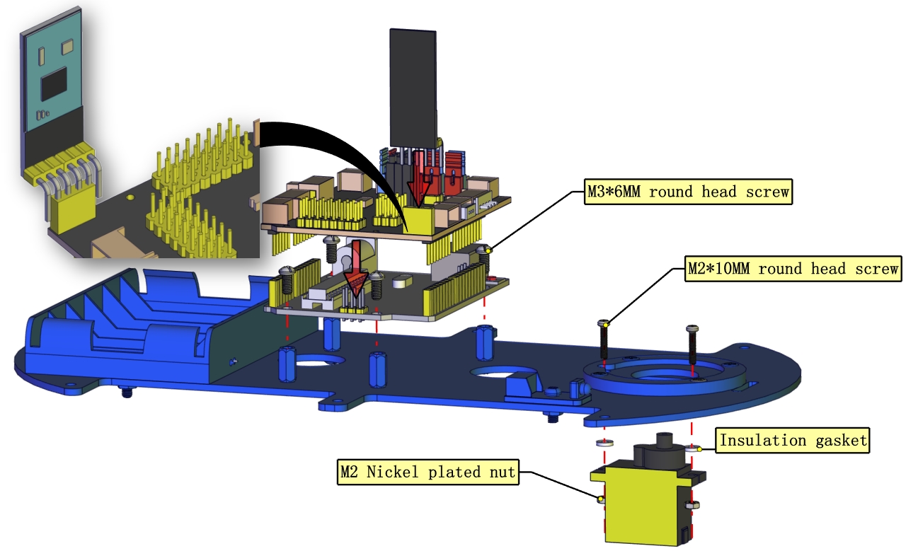
[picture p56: media/f373b4005527644e5661eb58f55892cf.jpeg]
|  | |
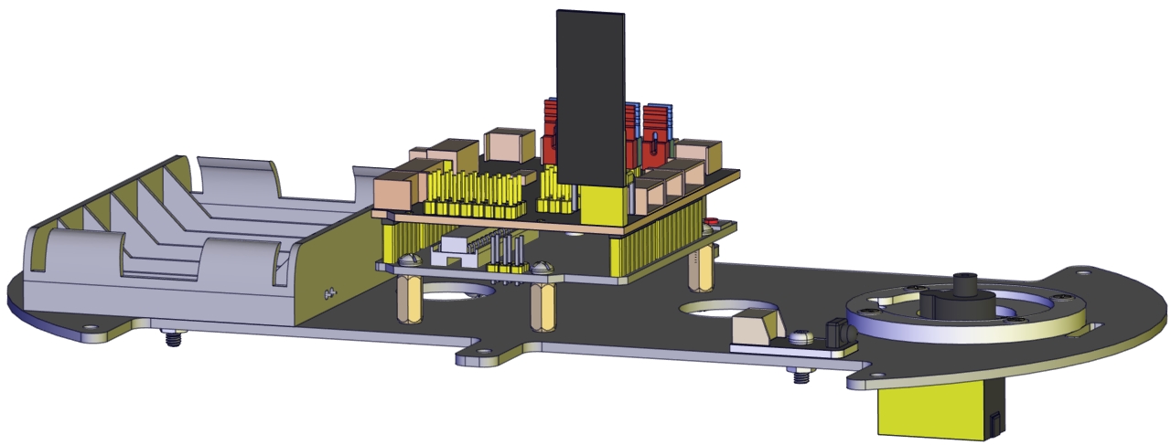
[picture p57: media/78f1c5447e3cfe0f460b25347b4fecf5.jpeg]
|  | |
| | |
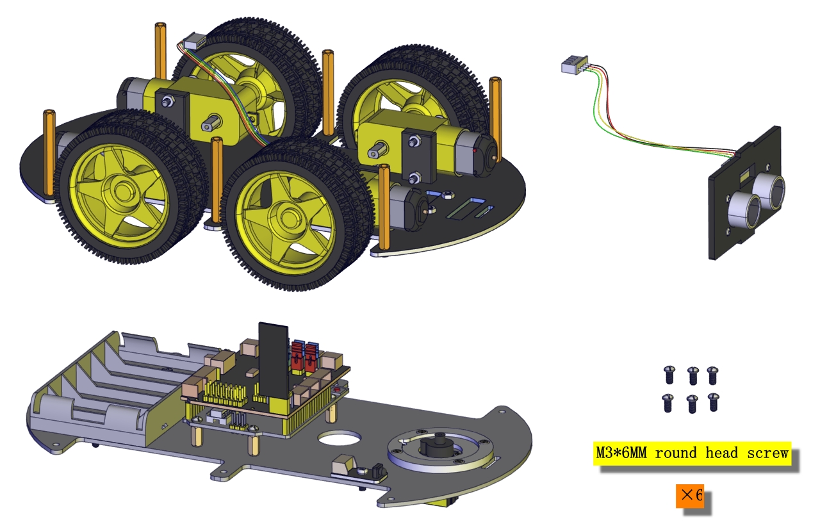
[picture p58: media/4b03a5a18212d6db70e1eb4f4b74a443.jpeg]
|  | |
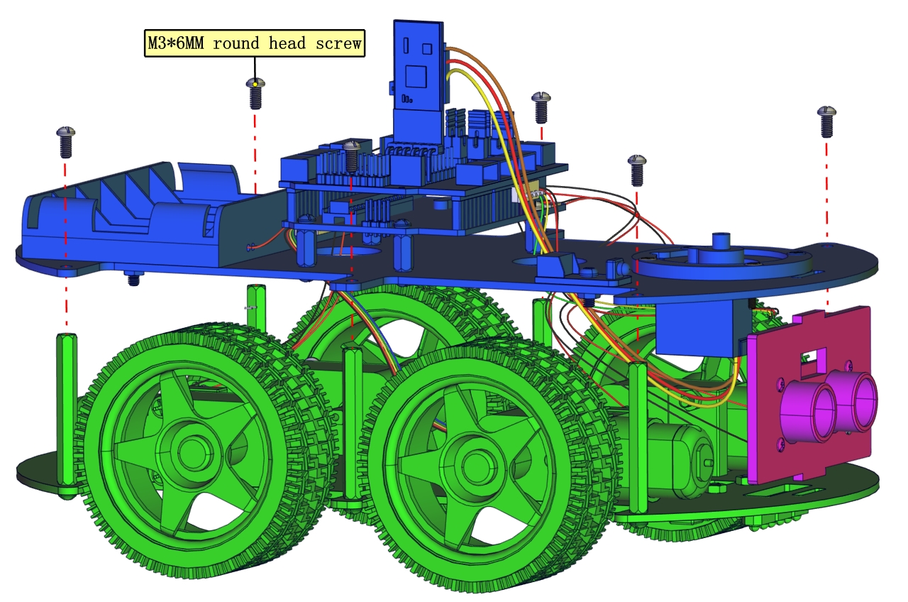
[picture p59: media/cd4479e95a3ba310b83e4972ed11106a.jpeg]
|  | |
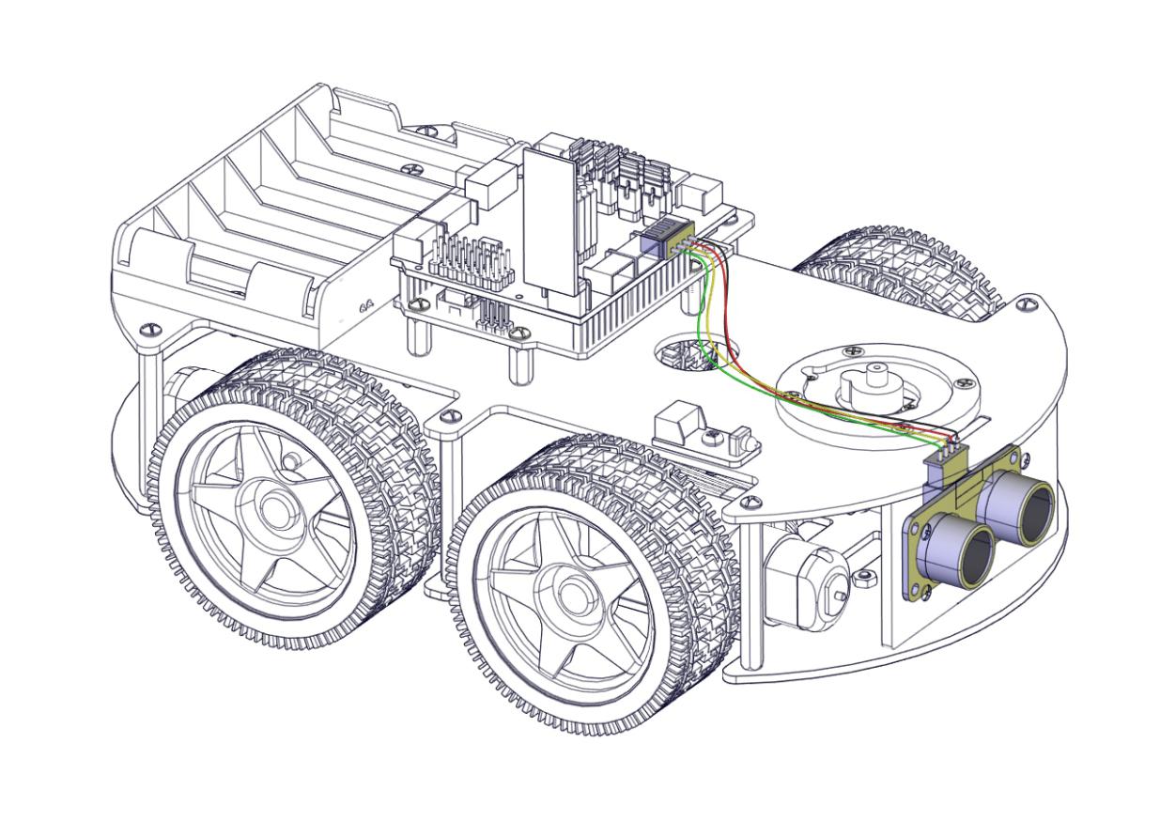
[picture p60: media/423a85741521940732403e18eb4ef388.jpeg]
| Connect Ultrasonic Sensor |  |
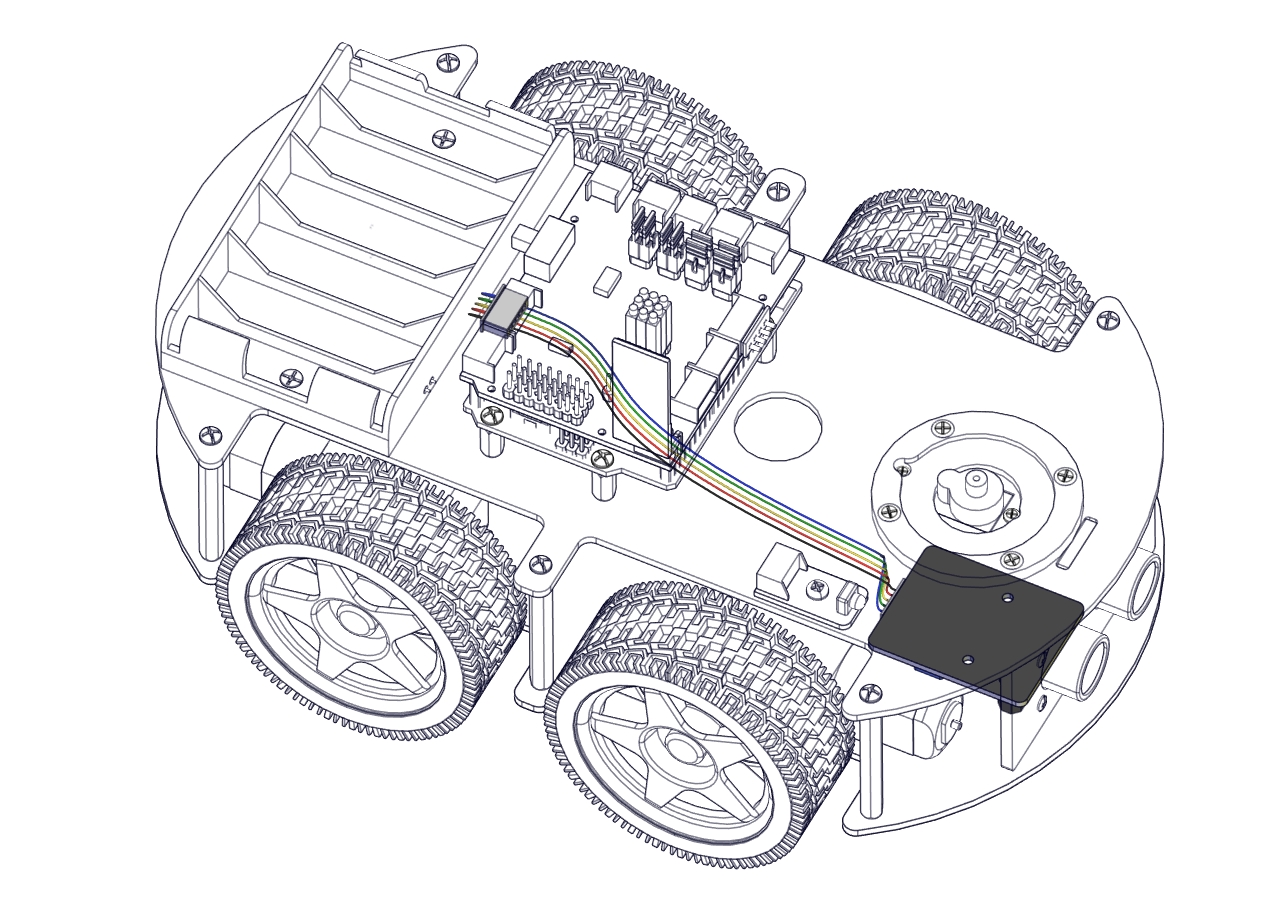
[picture p61: media/9b1bb75e2cd3553c20ff24e152096457.jpeg]
| Wire up Line Tracking Sensor |  |
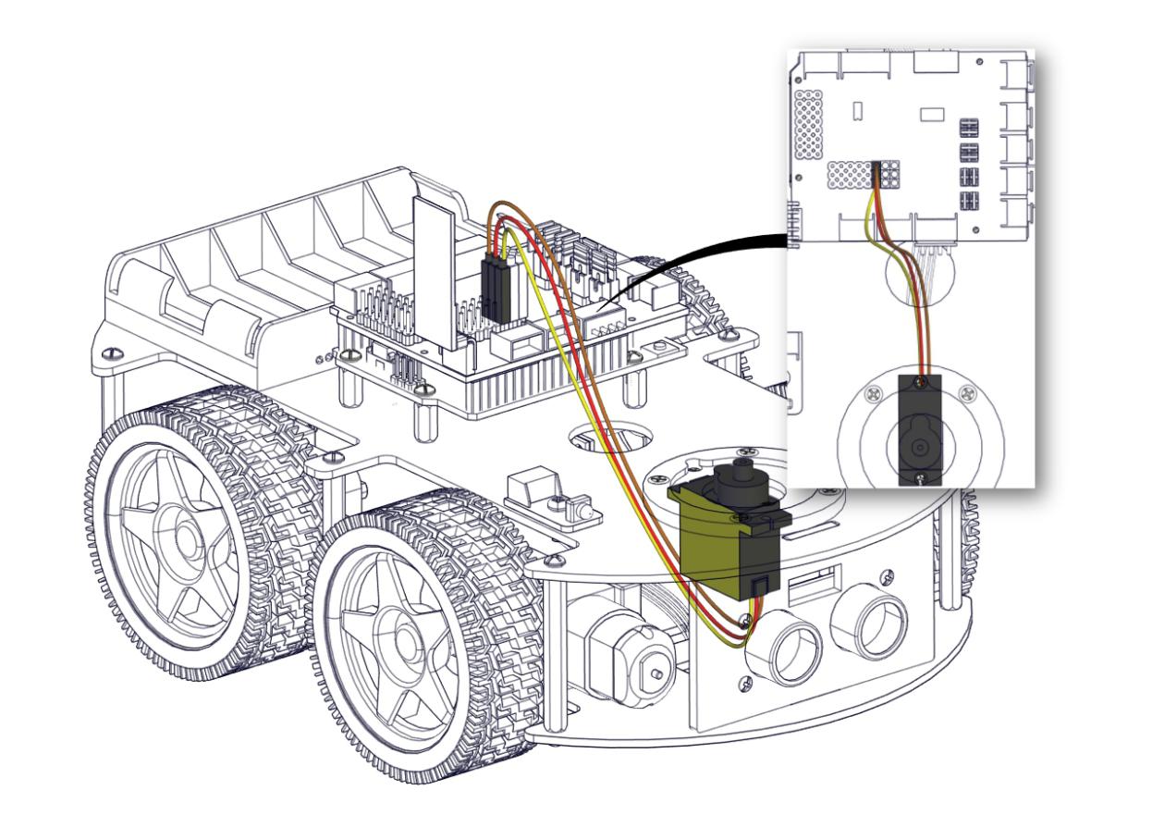
[picture p62: media/eedec7e676a8be536db9221979b22ab2.jpeg]
| Connect Servo |  |
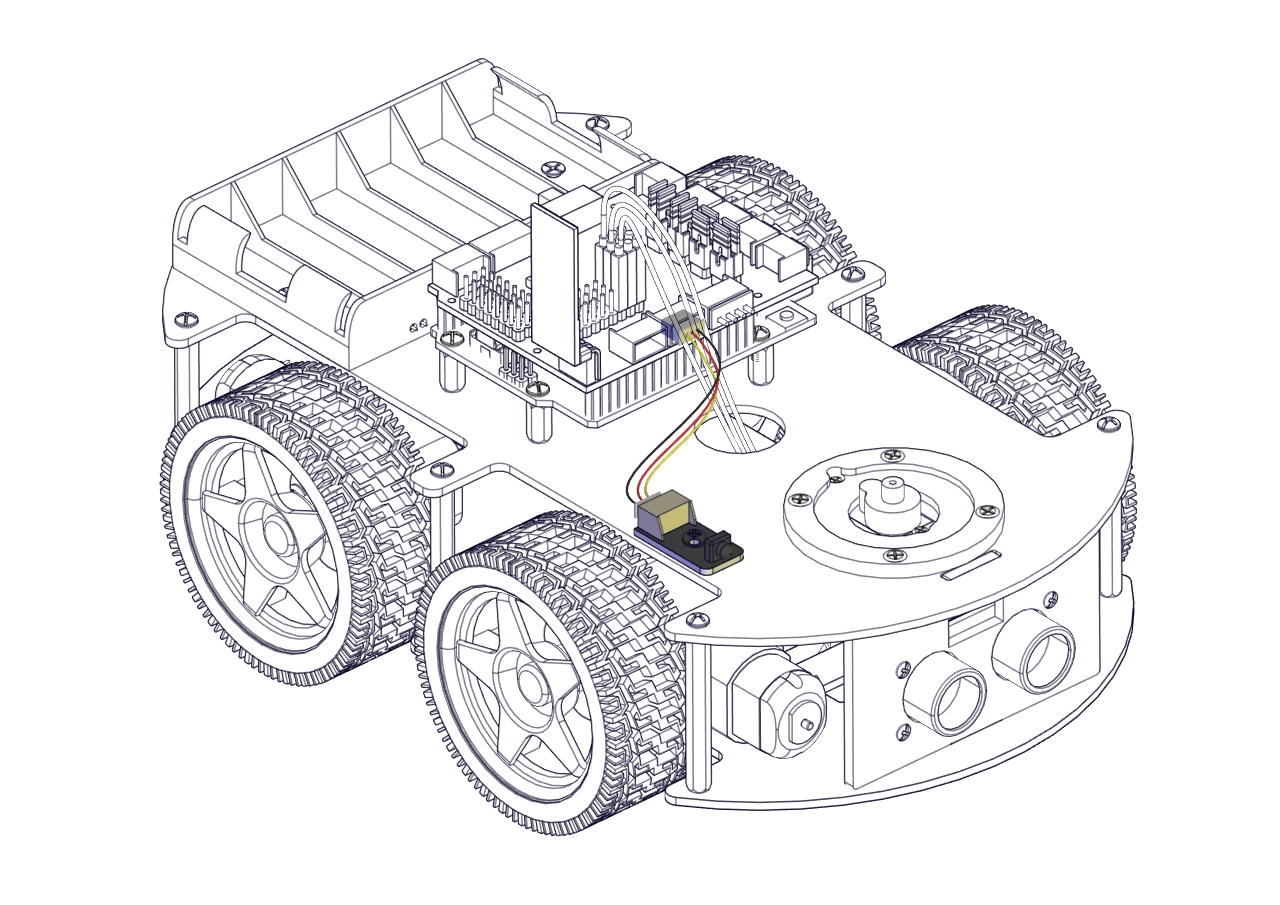
[picture p63: media/af007a0645f9e06557192068b1d1d09c.jpeg]
| Wire up IR Receiver |  |
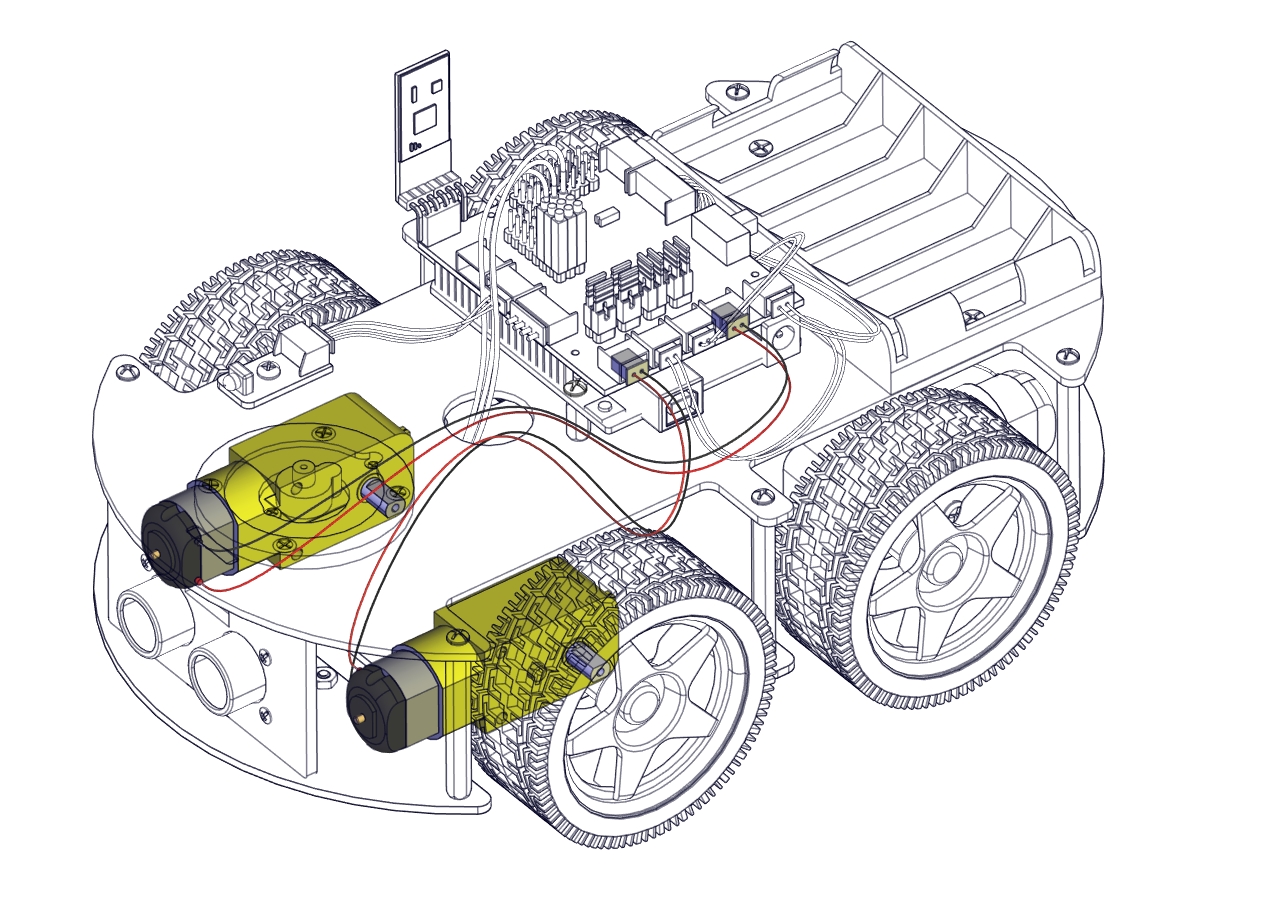
[picture p64: media/738fc724bfa895cbba13bbd12f5ffbe0.jpeg]
| Install Front Motors |  |
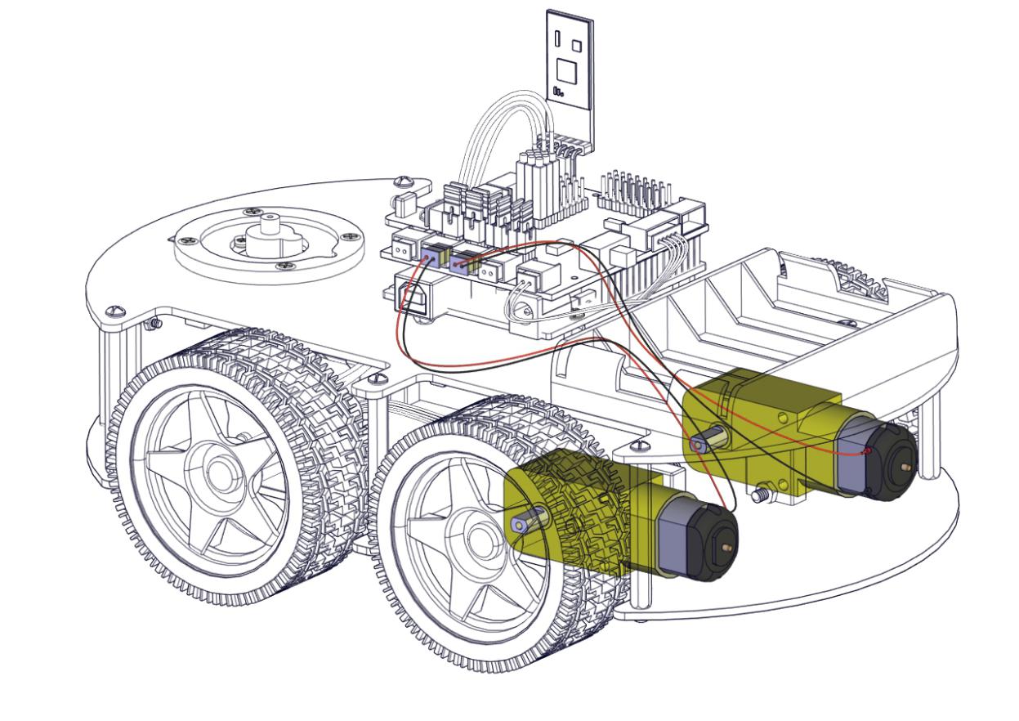
[picture p65: media/17061fd8b54562f1301fc41bcafcf3b7.jpeg]
| Install Rear Motors |  |
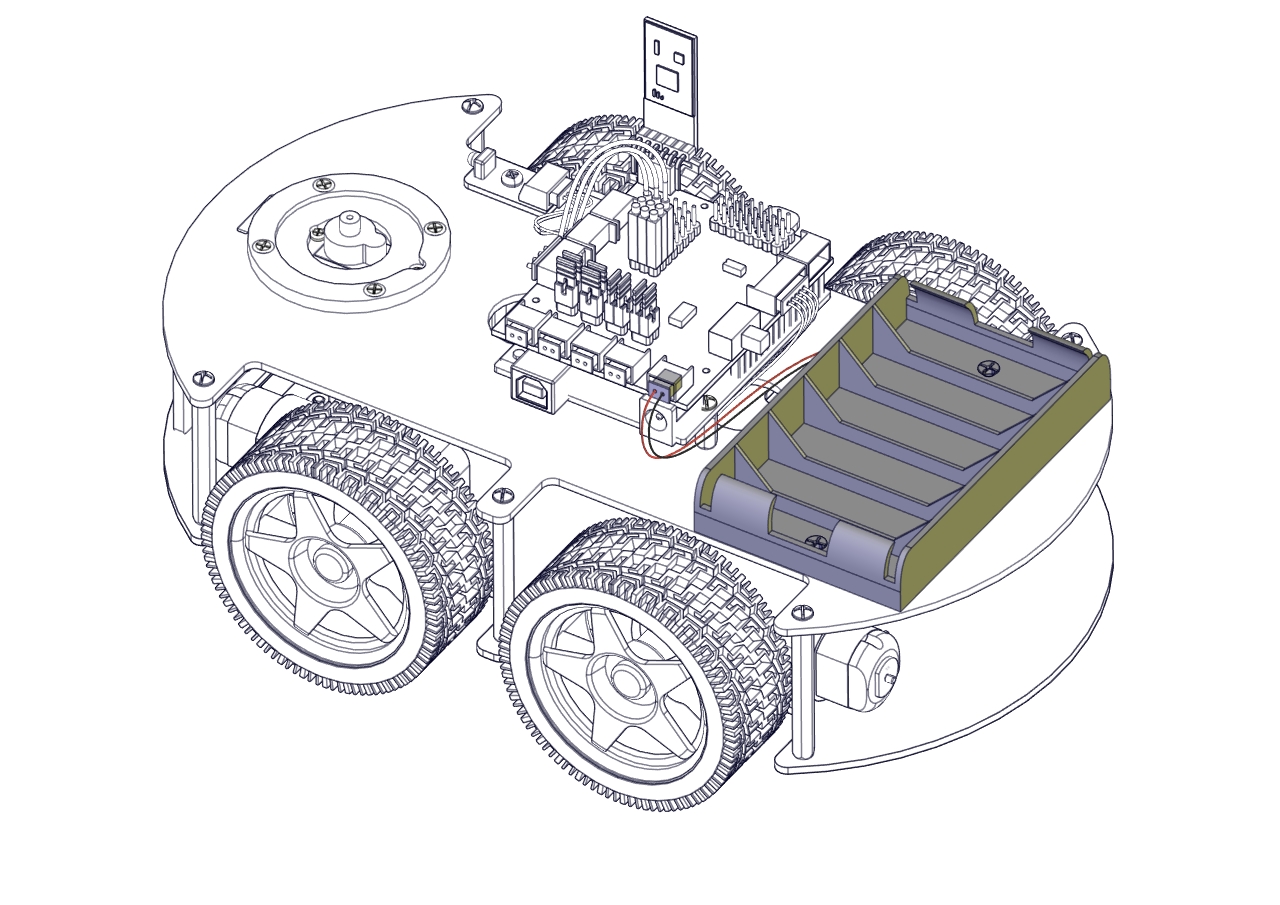
[picture p66: media/cb91da0169dbdf7aa6d2df93c12ef4fe.jpeg]
| Mount Battery Holder |  |
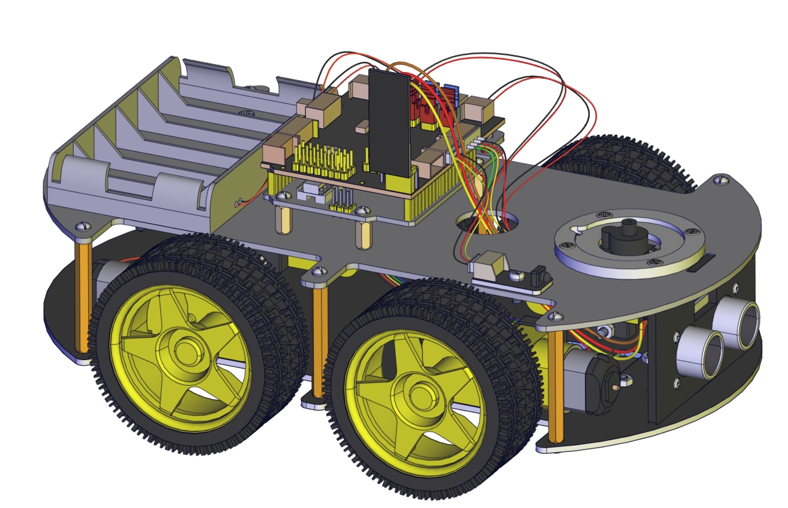
[picture p67: media/68571a1d1a0fa24195e2ff992dcaec94.jpeg]
|  | |
| Assemble Robot Arm | |
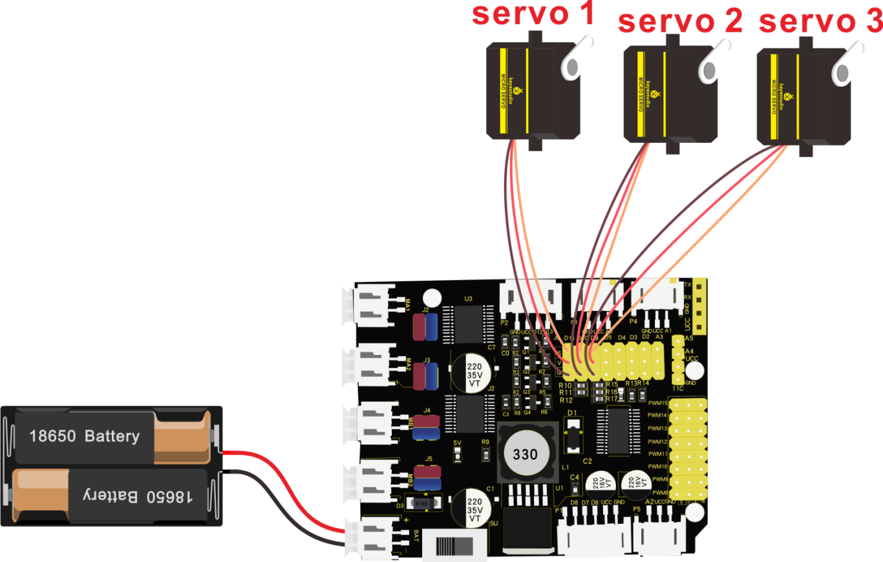
[picture p68: media/0dbfc8872e46d5966647069e128bcb80.png]
| The following code is used to initialize the angle value of servo. Copy the code in the Arduino IDE and plug in power, then three servos will rotate to an initial angle **Wiring Diagram：**  **Note: servo 3 sits on the base** **Test Code：** \##include \<Servo.h\> Servo myservo1; //servo of claw Servo myservo2; //servo of arm Servo myservo3; //servo of base int k1=90,k2=120,k3=90; // initialize the angle value of three servos void setup(){ Serial.begin(9600); //set baud rate to 9600 myservo1.attach(11);//Servo1 is connected to D11 myservo2.attach(10);//Servo2 is linked with D10 myservo3.attach(9);//Servo3 is linked with D9 myservo1.write(k1);//make servo 1 rotate to 90° delay(1000); myservo2.write(k2);//make servo 1 rotate to 1200° delay(1000); myservo3.write(k3);//make servo 3 rotate to 90° delay(1000); } void loop(){ } | |
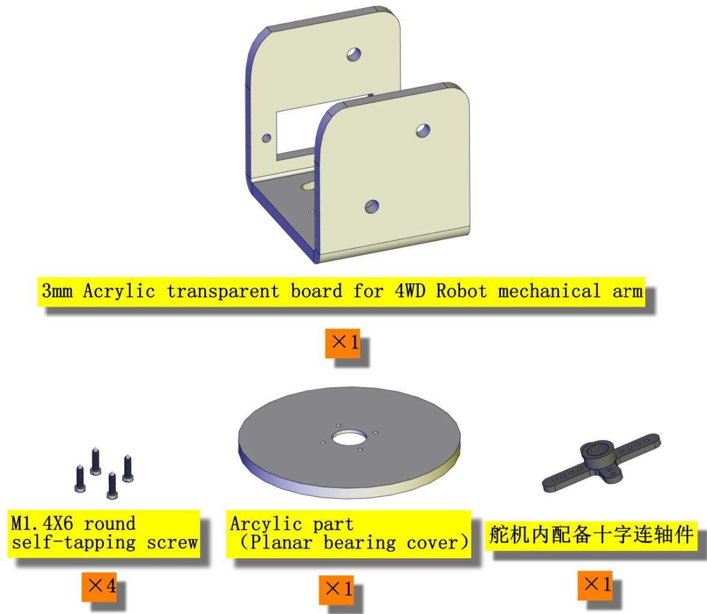
[picture p69: media/8d44f76270da140448317ec93df70b60.jpeg]
|  | |
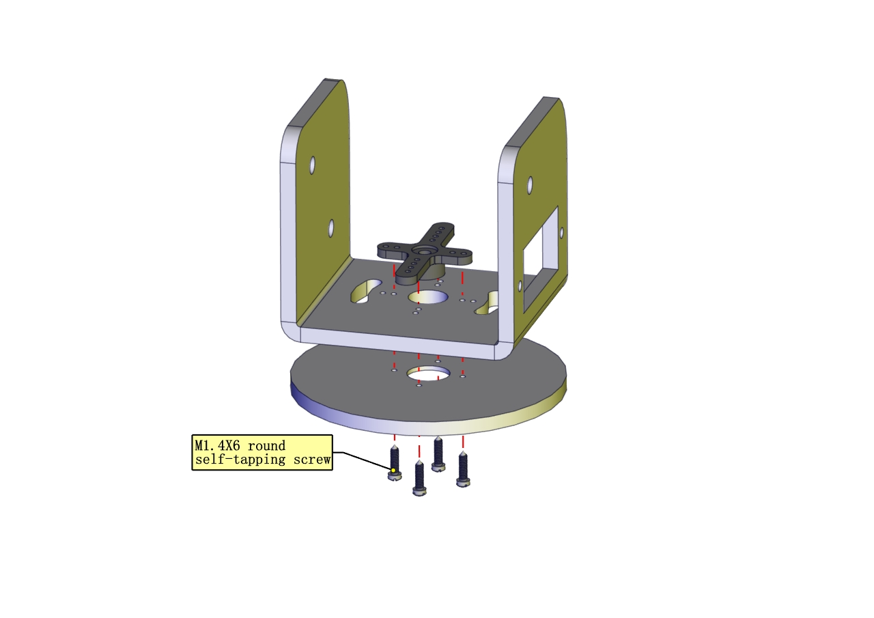
[picture p70: media/5a4cb27d0486551b2c4e5229d58a0f04.jpeg]
|  | |
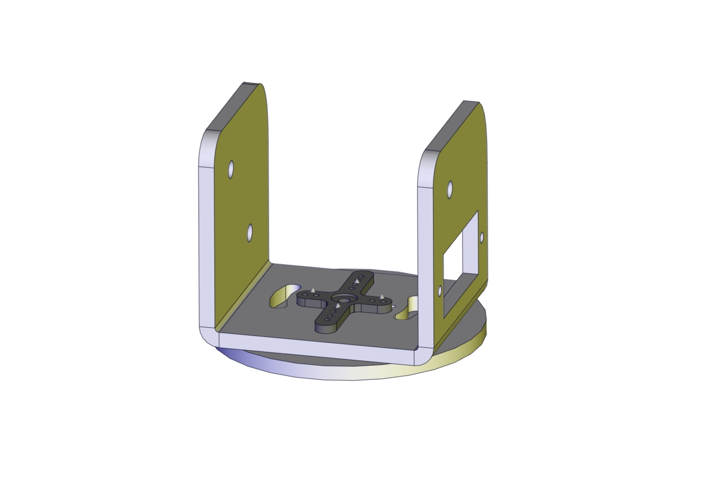
[picture p71: media/bbfb97b5156ac55d2a7f3724e099839b.jpeg]
|  | |
| | |
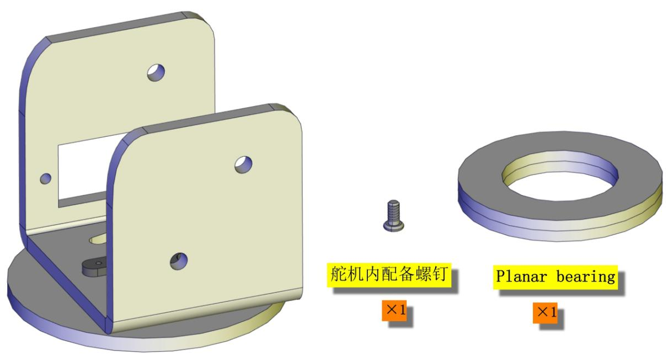
[picture p72: media/210fa4ea60b5bf7b565da987d25d7b9b.jpeg]
|  | |
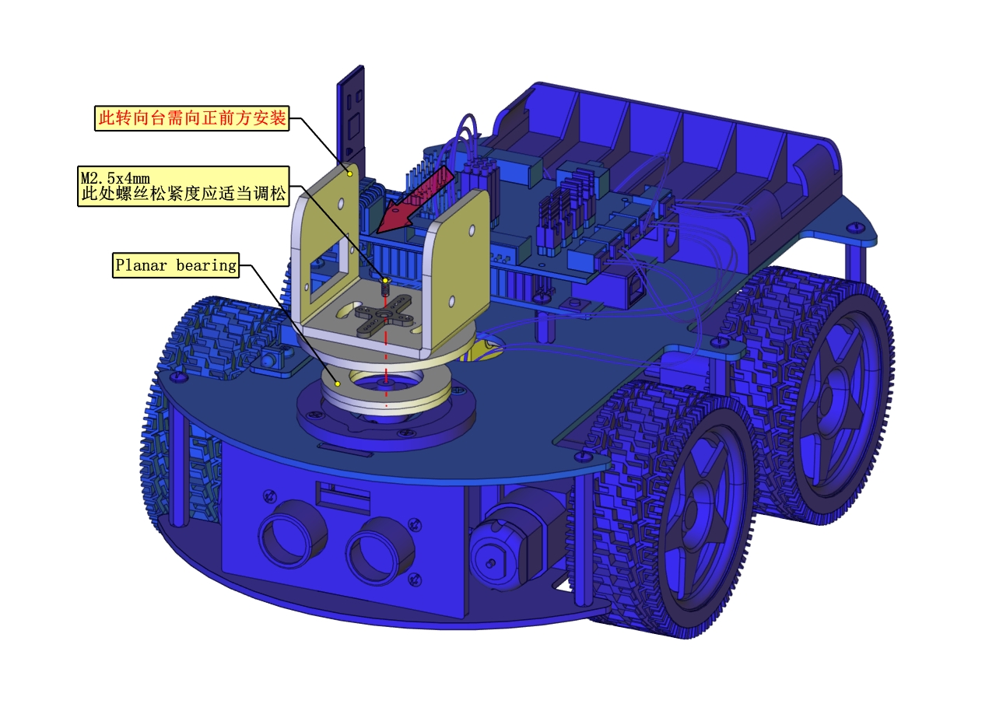
[picture p73: media/3baf6dd5a4e1115ce8843388da074cd1.jpeg]
| Installed on servo 3 |  |
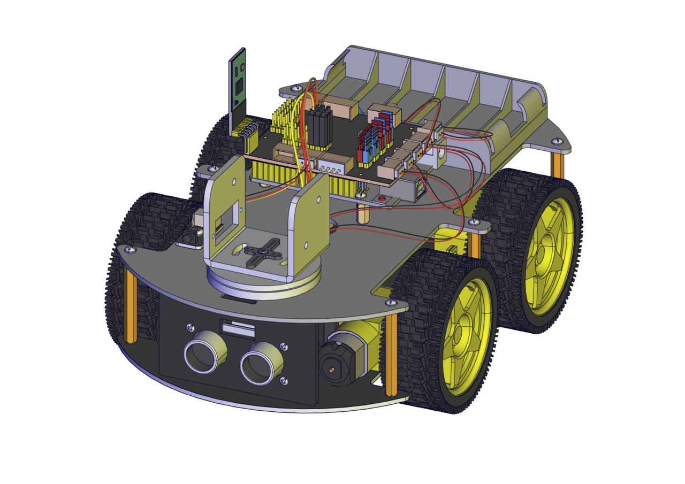
[picture p74: media/7e07d141e6ef59b597838ab982ae740d.jpeg]
|  | |
| | |
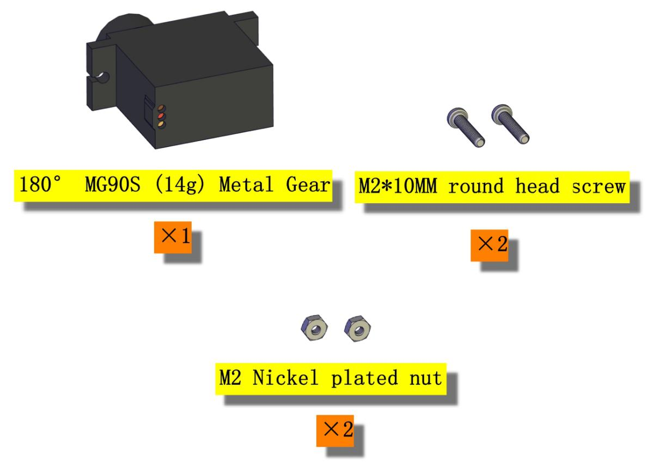
[picture p75: media/a6378df1c7689d3e3e985a74e5c68005.jpeg]
|  | |
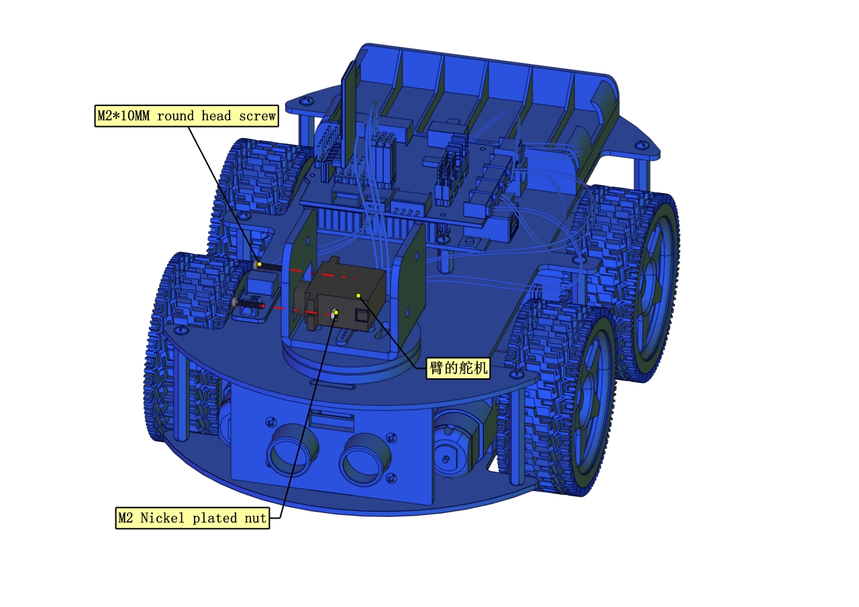
[picture p76: media/5de00df067d004edb51a614c84781630.jpeg]
| Mount with servo 2 |  |
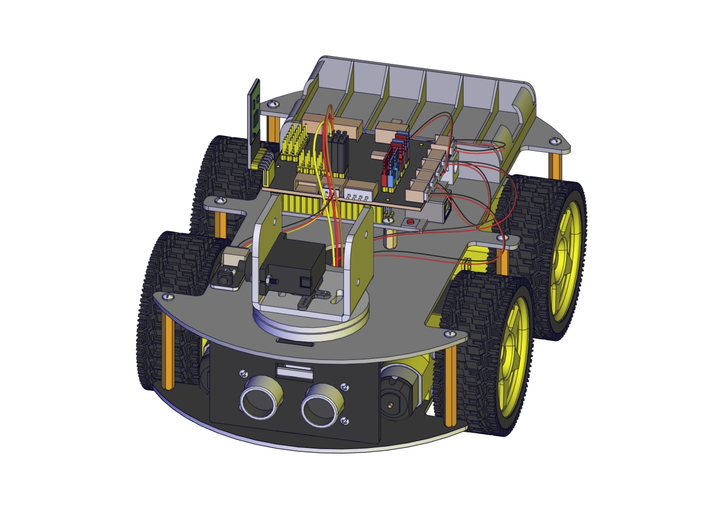
[picture p77: media/4a0e40d27a2a0c5add3eb8c1c14b5343.jpeg]
|  | |
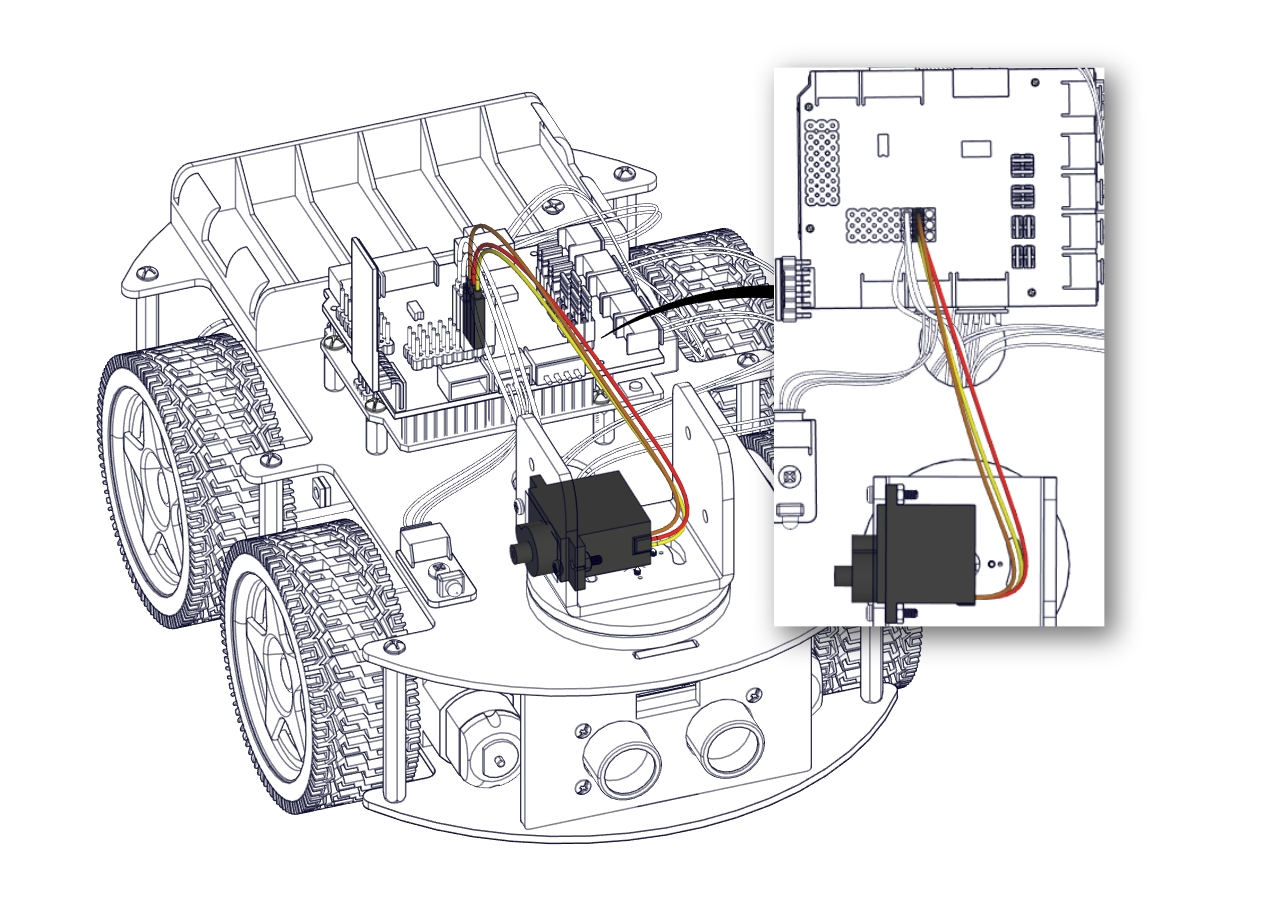
[picture p78: media/abf937c2f6122f8f658f61dead96e69a.jpeg]
|  | |
| | |
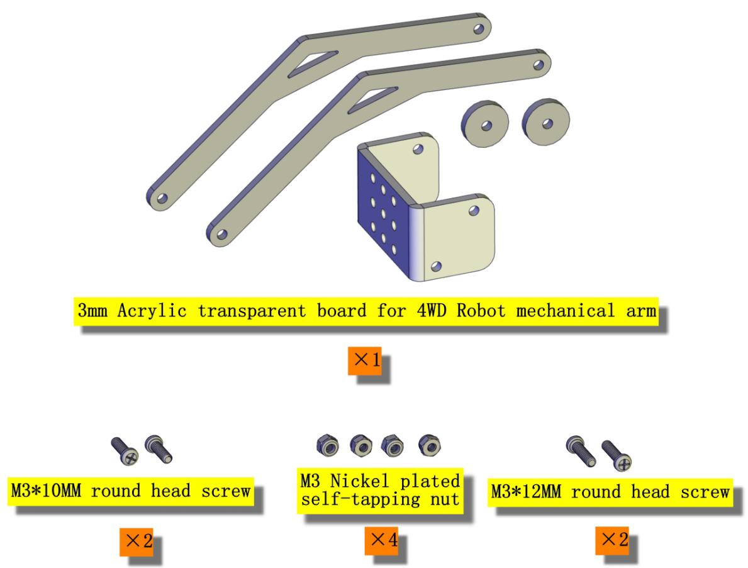
[picture p79: media/10e63beb6cb8ef375bf23752a8be9185.jpeg]
|  | |
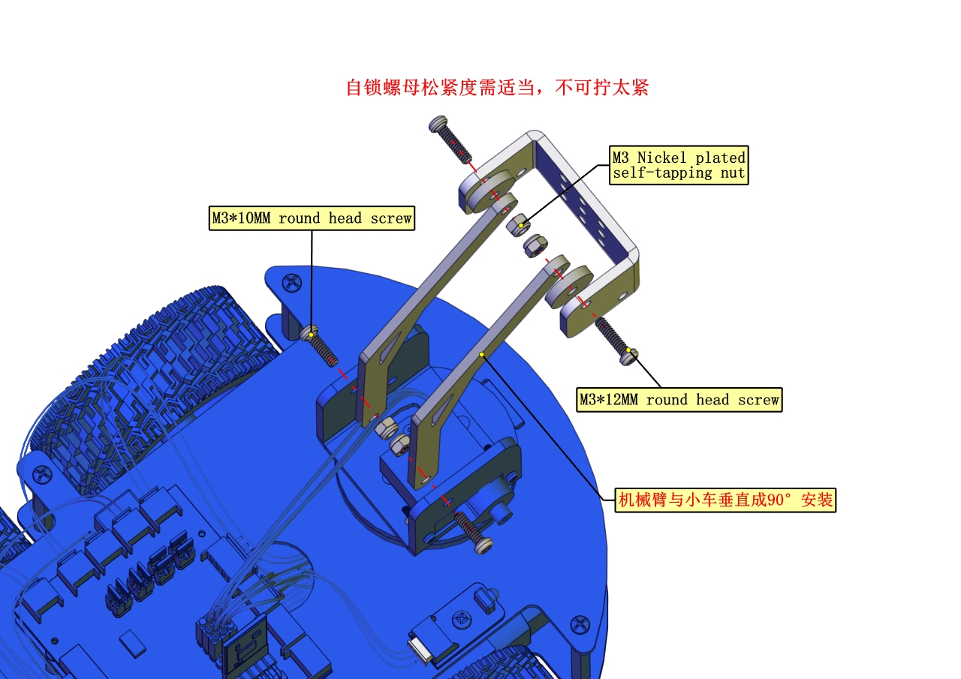
[picture p80: media/0409efdc9d27f104943a5f367f2354f8.jpeg]
|  | |
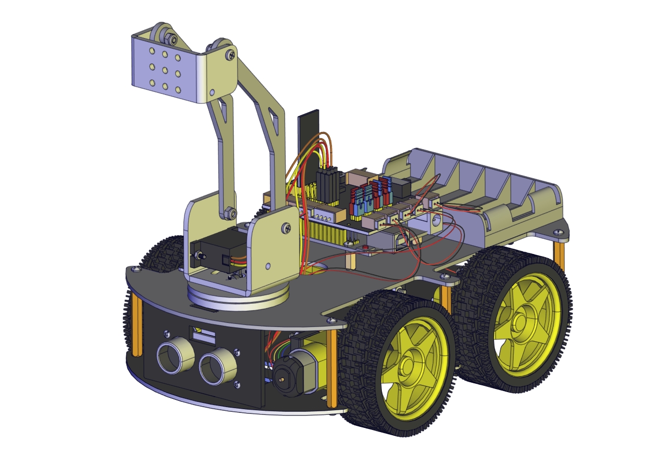
[picture p81: media/a551992991a5197a491a19529d1774c9.jpeg]
|  | |
| | |
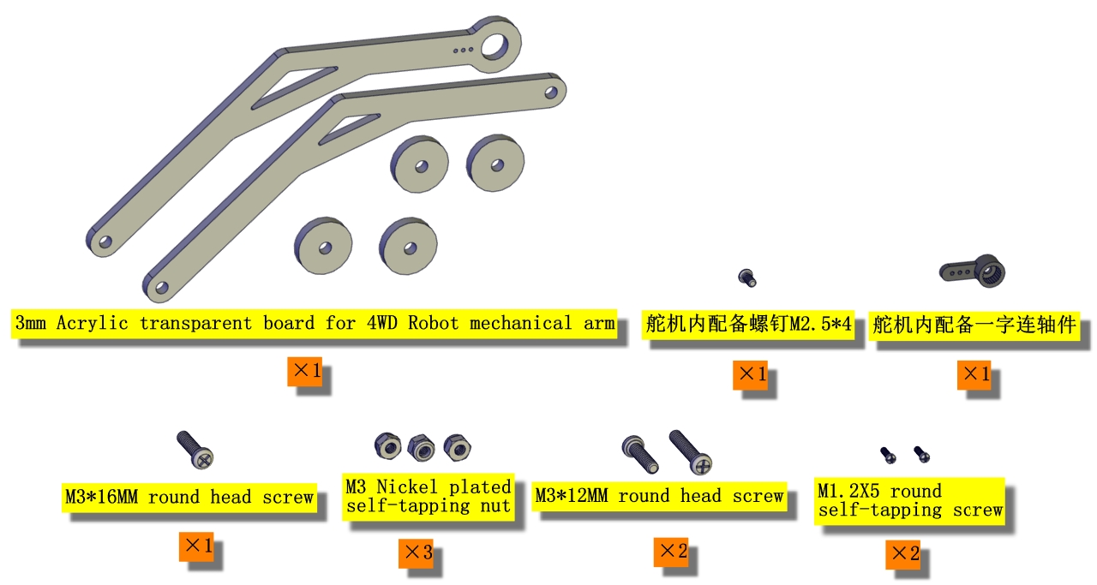
[picture p82: media/264e77c8c8932117e171a4e0e1c110b7.jpeg]
|  | |
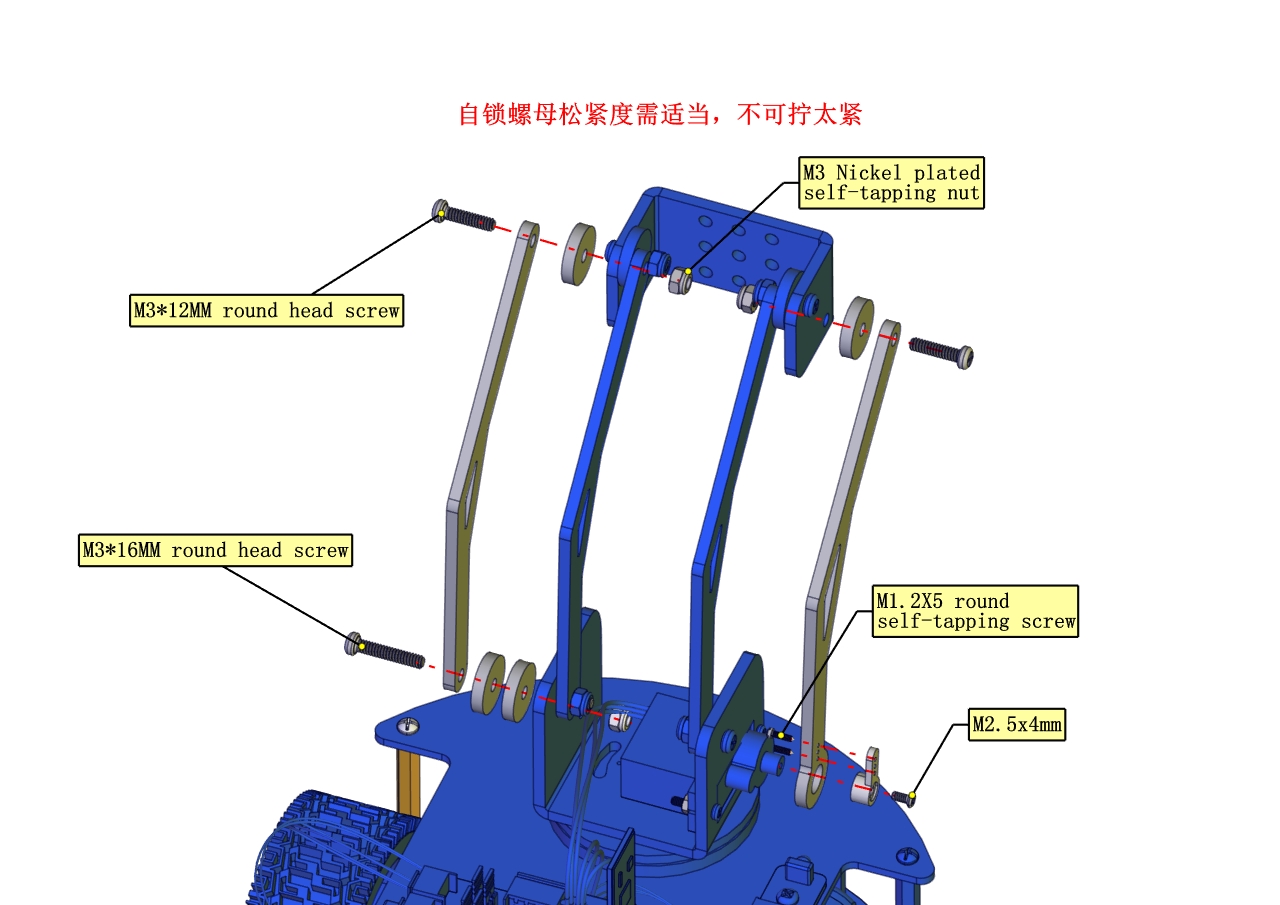
[picture p83: media/b7f4e3846ec757b9fd7dc991901c8052.jpeg]
|  | |
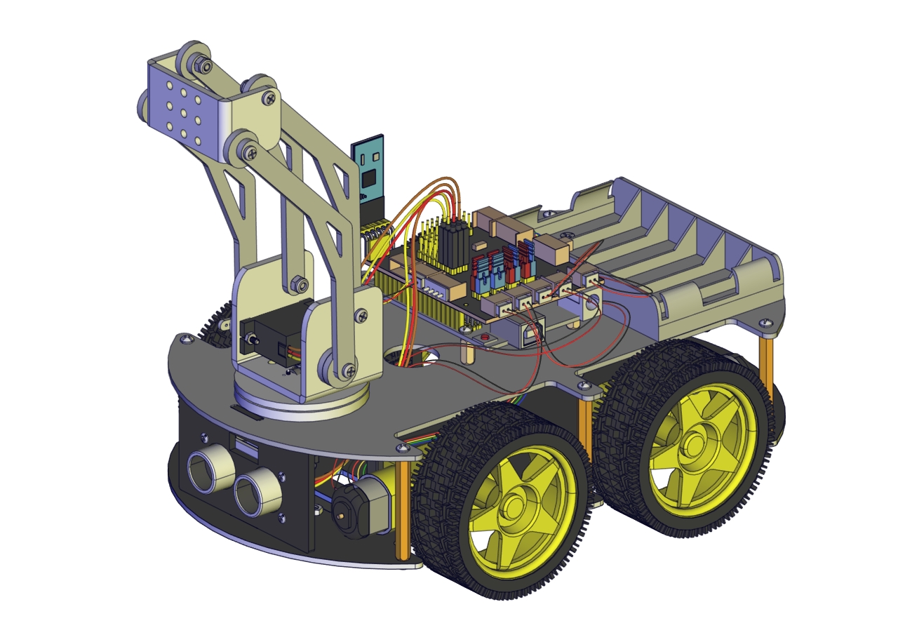
[picture p84: media/4c3121f3c7e3898058b95b9c02cc6487.jpeg]
|  | |
| | |
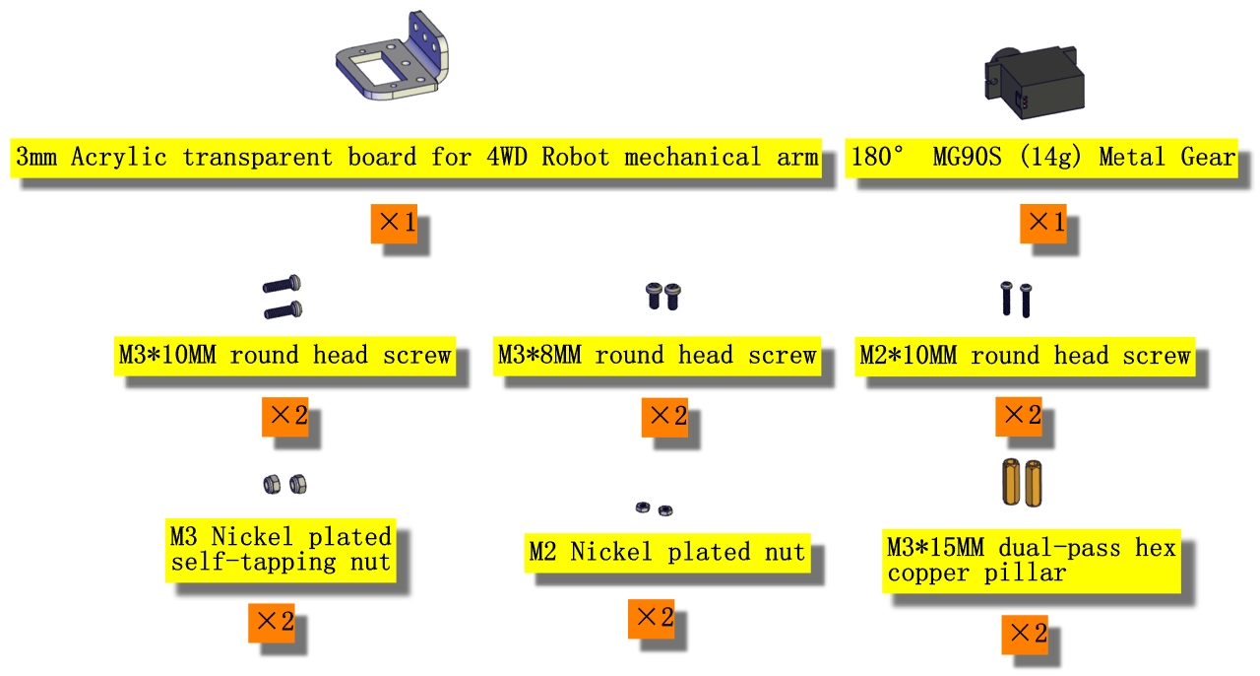
[picture p85: media/aed1a6f83ba3f9a4114037c9e255e09e.jpeg]
|  | |
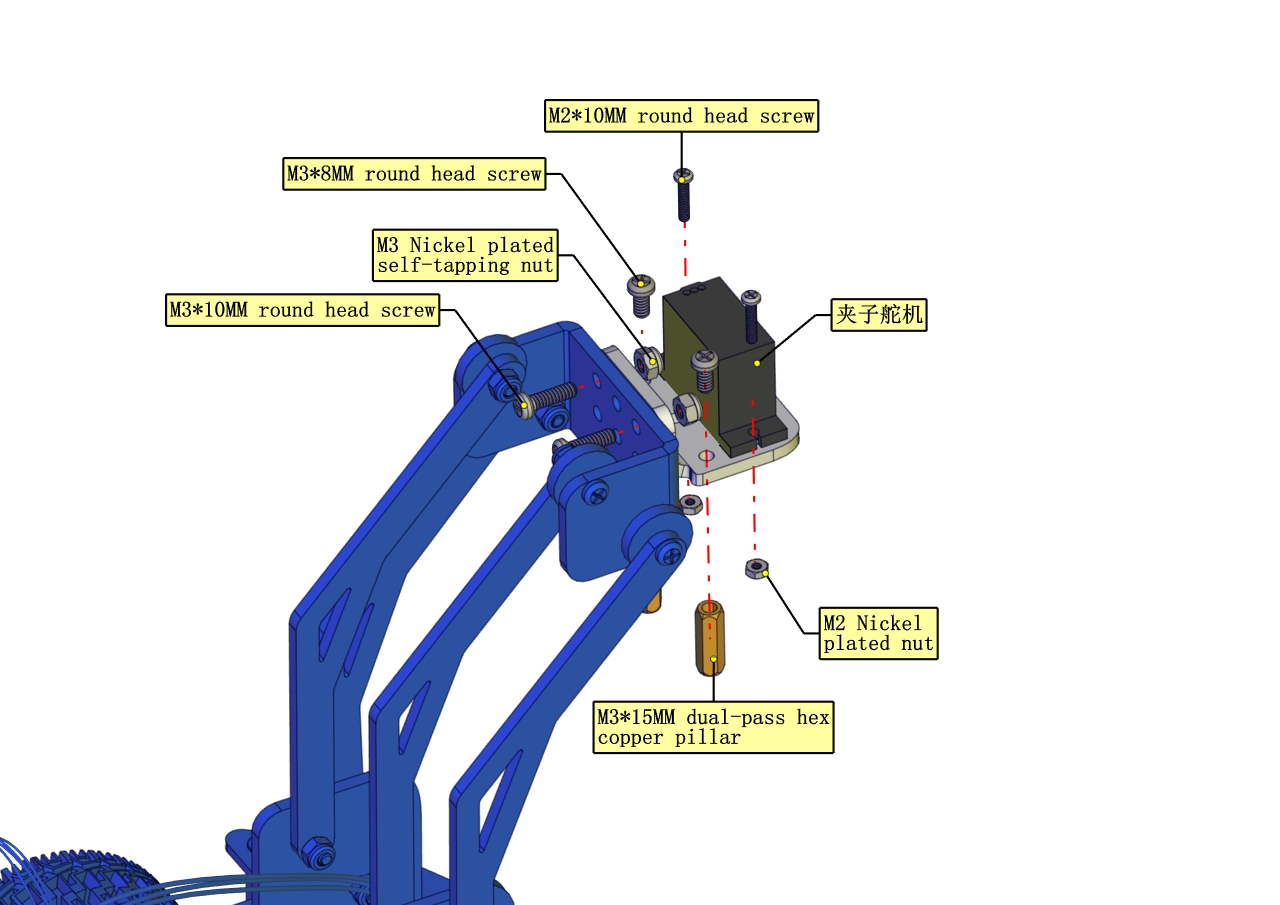
[picture p86: media/96c3674de4528b3f0829093cca4d17c7.jpeg]
| This is servo 1 |  |
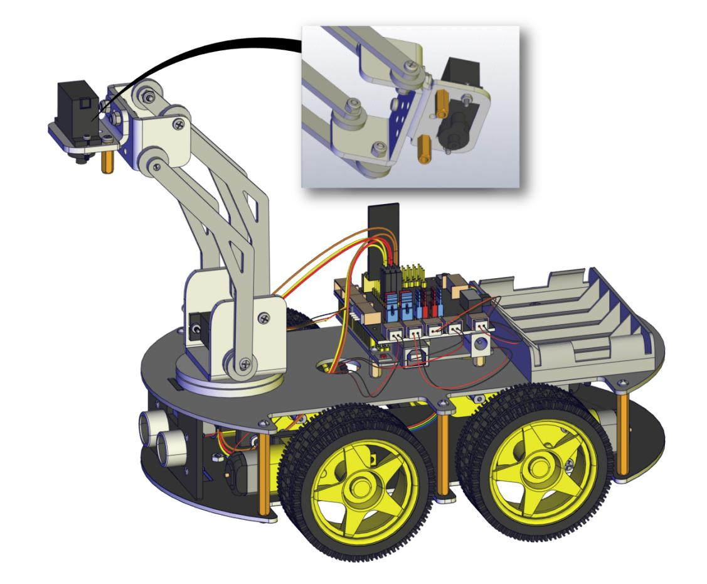
[picture p87: media/14bae0267b22f68cee2dec7ec34b71c4.jpeg]
|  | |
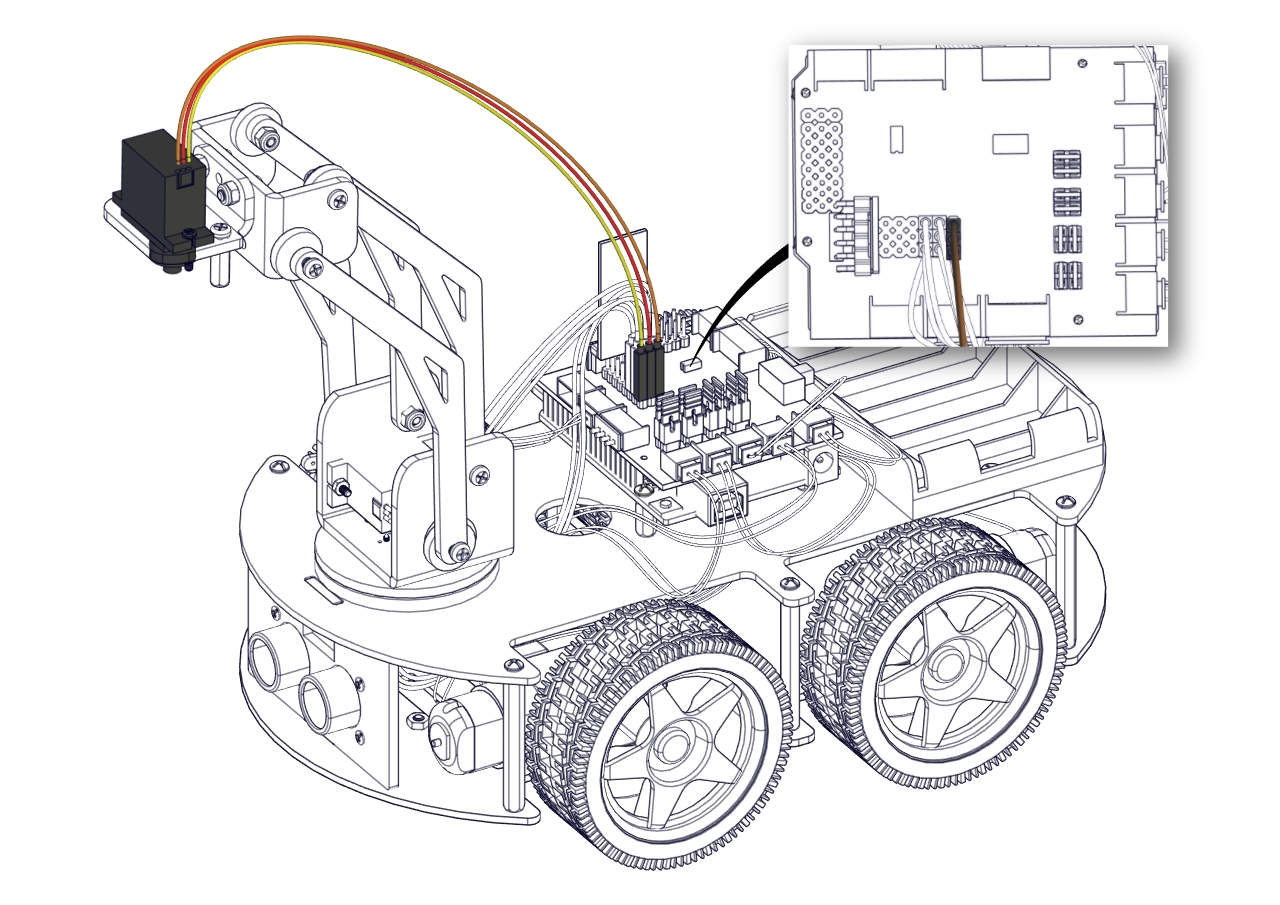
[picture p88: media/a29bf69f7cf3b1b703b6b8f772222339.jpeg]
|  | |
| | |
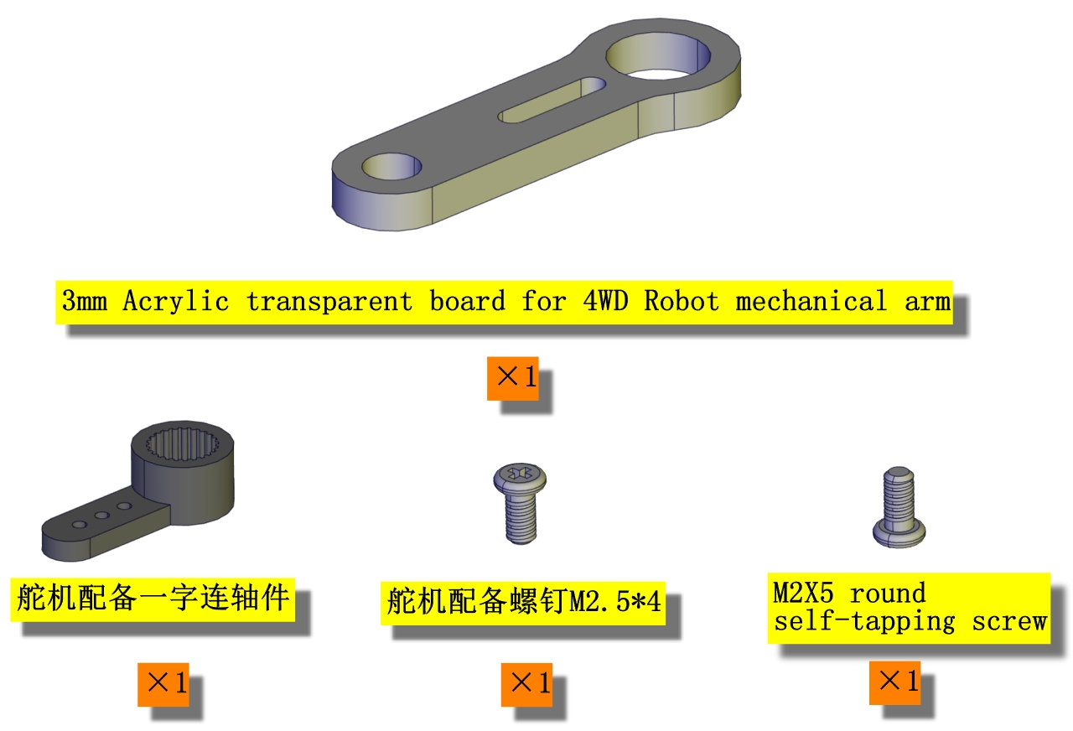
[picture p89: media/0c15d0766831ff485d01294a171fbbcc.jpeg]
|  | |
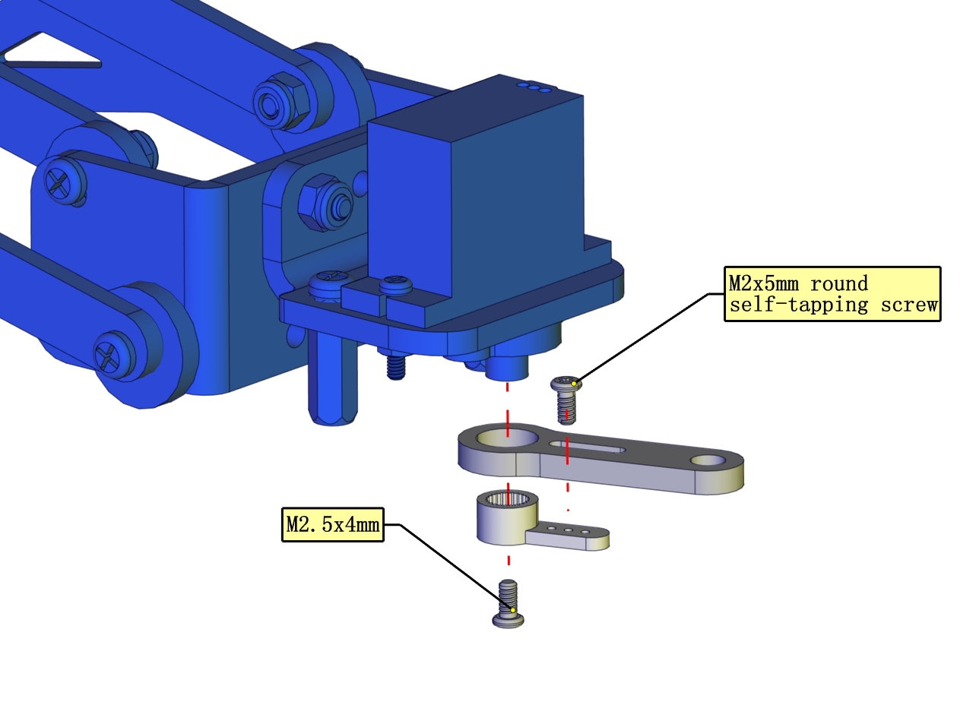
[picture p90: media/2842642f04b64448ebee7a5d2f95a4f8.jpeg]
|  | |
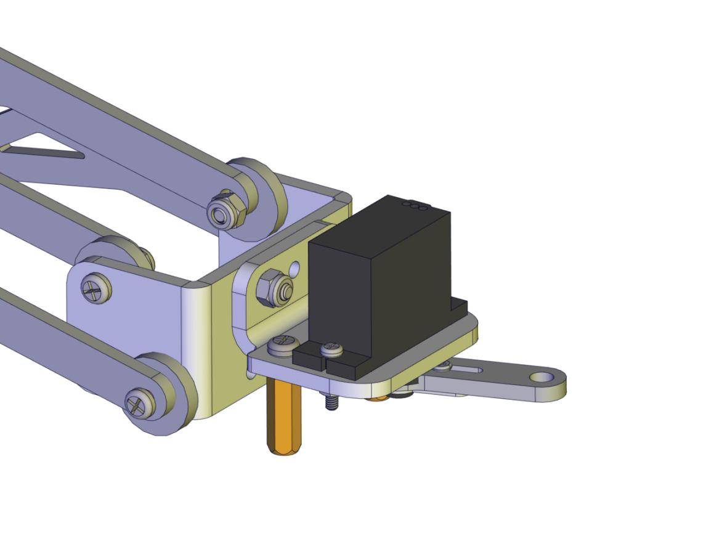
[picture p91: media/7162bb4451dd6cfc726db75bb71249a4.jpeg]
|  | |
| | |
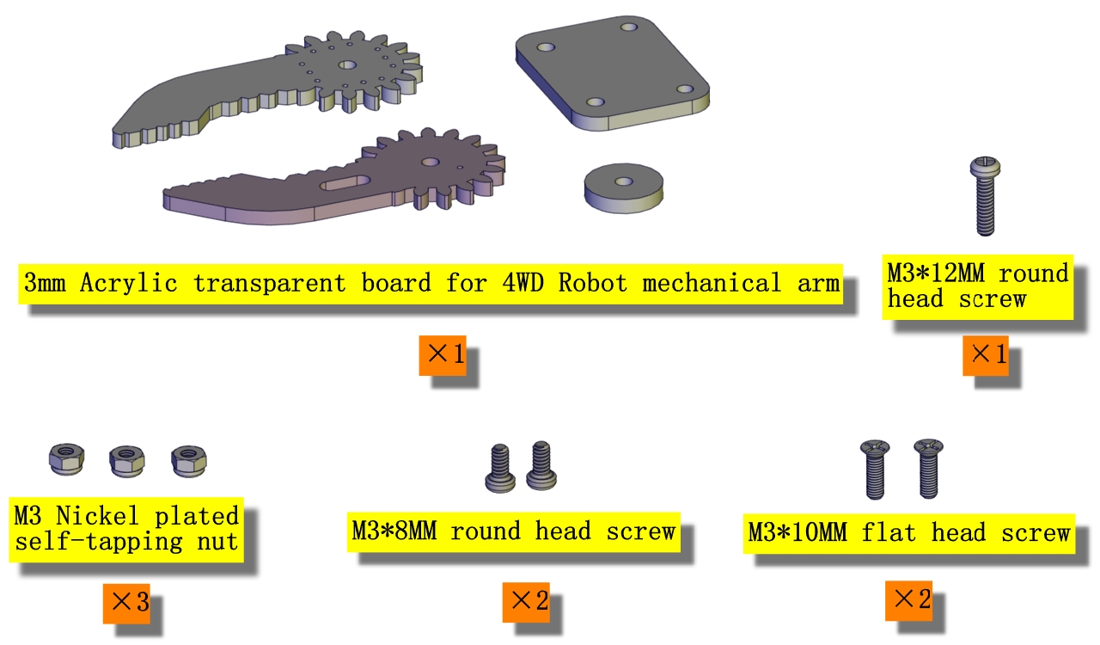
[picture p92: media/603d8d25edb8e8df5083796bc4fb0d53.jpeg]
|  | |
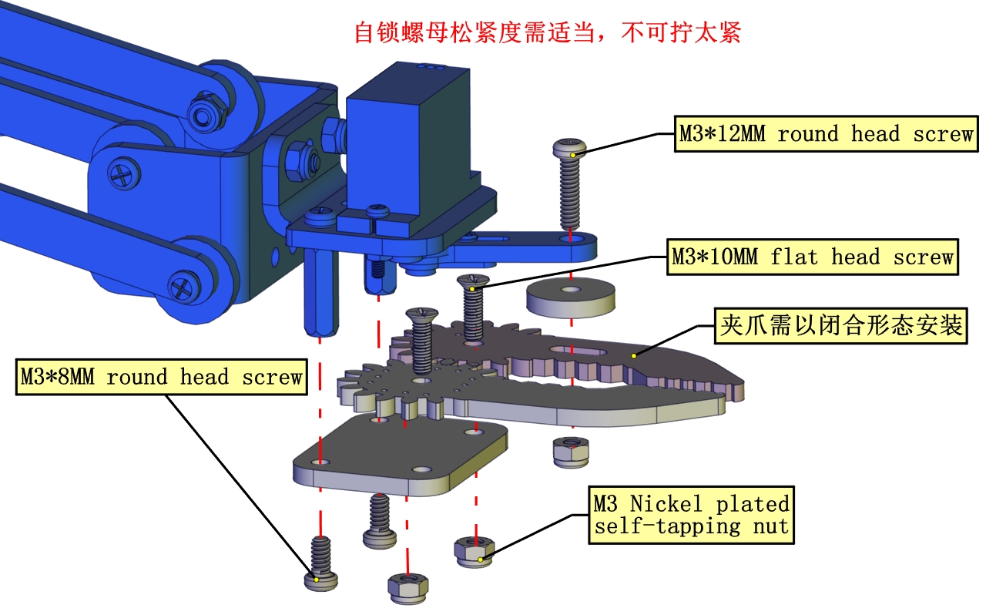
[picture p93: media/1b2a09e6821d0322205ee7fcb9deb71a.jpeg]
| |  |
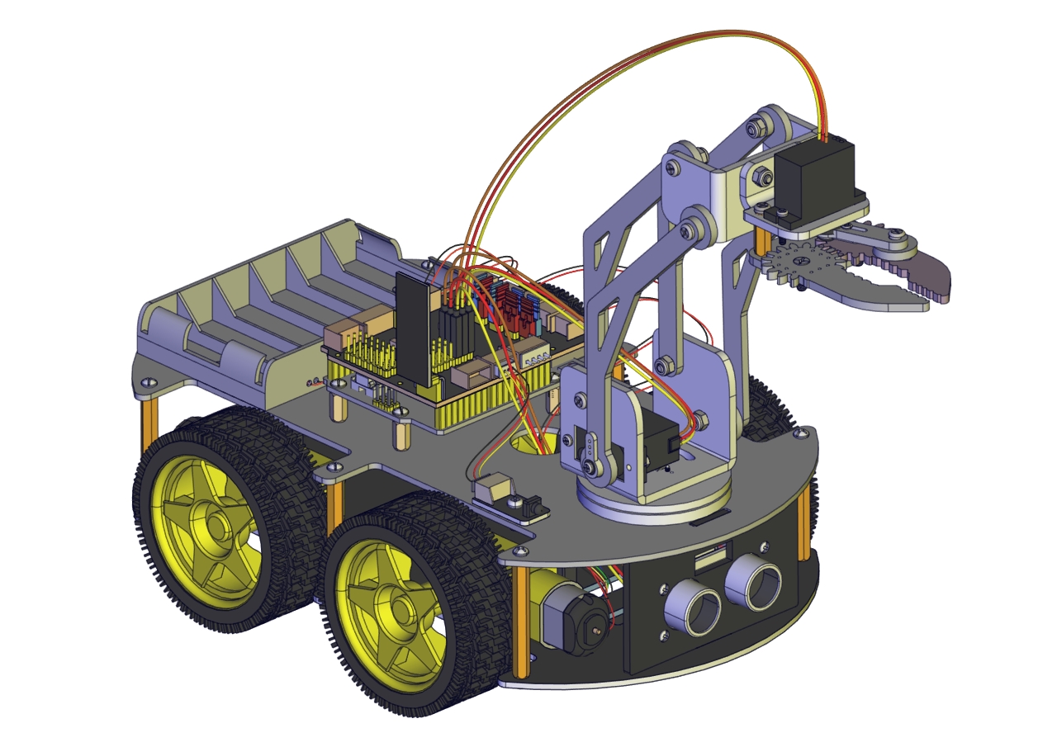
[picture p94: media/0d5a2871fa429588af9948fdb66ec005.jpeg]
|  | |

## Projects

### Project 1: LED Light

#### Description：

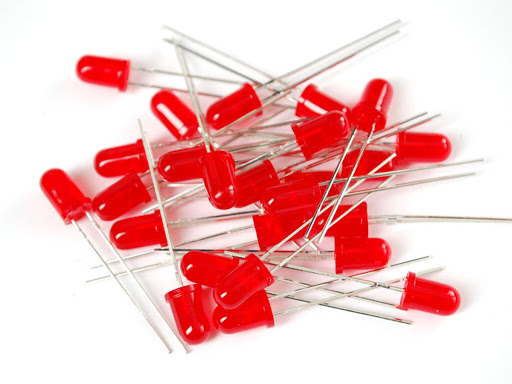
[picture p95: media/bbafde79f8909da728d42983e722b9e5.jpeg]


For starters and enthusiasts, LED Blink is a fundamental program. LED, the
abbreviation of light emitting diodes, consists of Ga, As, P, N chemical
compounds and so on. The LED can flash in diverse color by altering the delay
time in the test code. When in control, power on GND and VCC, the LED will be on
if S end is in high level; nevertheless, it will go off.

1.  **Specification：**

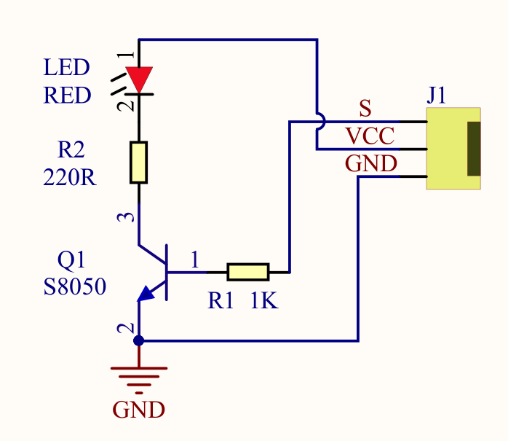
[picture p96: media/f36ae7e163e0381b0e4fc14af60d2cd2.png]


Control interface: digital port  
Working voltage: DC 3.3-5V  
Pin spacing: 2.54mm  
LED display color: red

1.  **What You Need：**

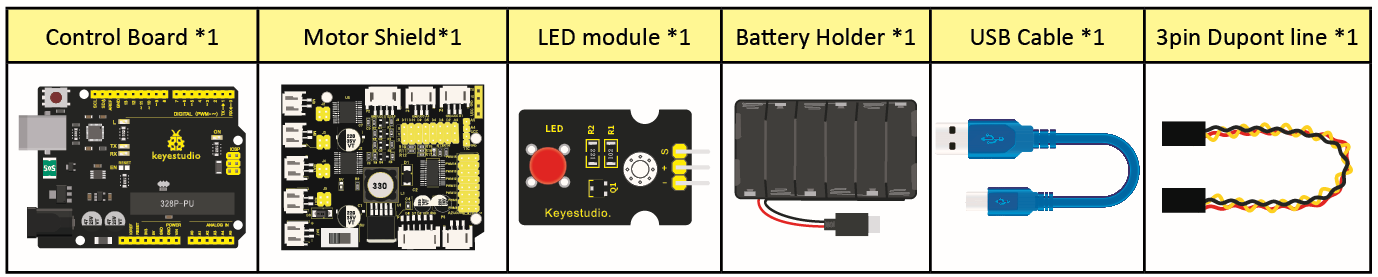
[picture p97: media/d4e893a92855c3470b1f459e7be3bb3f.png]


1.  **Wiring Diagram：**

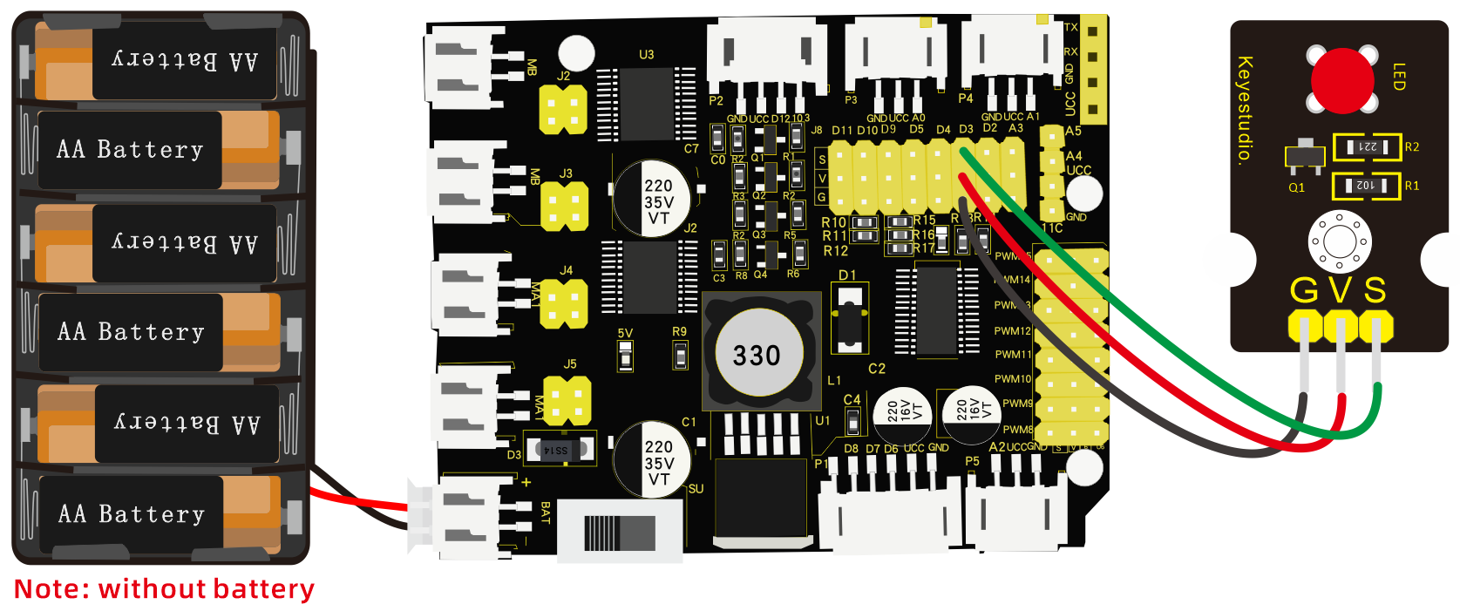
[picture p98: media/bbb30f0531fb61518bd418d016a7dad3.png]


The pin -, + and S of LED module are connected to G, V and D3 of shield.

1.  **Test Code：**

/\*

keyestudio 4wd Robot Arm Smart Car

lesson 1.1

Blink

http://www.keyestudio.com

\*/

void setup()

{

pinMode(3, OUTPUT);// initialize digital pin 3 as an output.

}

void loop() // the loop function runs over and over again forever

{

digitalWrite(3, HIGH); // turn the LED on (HIGH is the voltage level)

delay(1000); // wait for a second

digitalWrite(3, LOW); // turn the LED off by making the voltage LOW

delay(1000); // wait for a second

}

1.  **Test Result：**

Upload the program, LED flashes with an interval of 1s.

**(7) Code Explanation:**

**pinMode(ledPin，OUTPUT)** - This function denotes that the pin is INPUT or
OUTPUT.

**digitalWrite(ledPin，HIGH)** - When pin is OUTPUT, we can set it to
HIGH(output 5V) or LOW(output 0V)

#### (8) Extension Practice：

We succeed in blinking the LED. Next, let’s observe what LED will change if we
modify the delaying time.

/\*

keyestudio 4WD Robot Arm Smart Car

lesson 1.2

delay

http://www.keyestudio.com

\*/

void setup() { // initialize digital pin 11 as an output.

pinMode(3, OUTPUT);

}

// the loop function runs over and over again forever

void loop()

{ digitalWrite(3, HIGH); // turn the LED on (HIGH is the voltage level)

delay(100); // wait for 0.1 second

digitalWrite(3, LOW); // turn the LED off by making the voltage LOW

delay(100); // wait for 0.1 second

}//\*\*\*\*\*\*\*\*\*\*\*\*\*\*\*\*\*\*\*\*\*\*\*\*\*\*\*\*\*\*\*\*\*\*\*\*\*\*\*\*\*\*\*\*\*\*\*\*\*\*\*\*\*\*\*\*\*\*\*\*\*\*\*\*

The test result shows that the LED flashes faster. Therefore, we can draw a
conclusion that pins and time delaying affect flash frequency.

**Project 2: Adjust LED Brightness**

#### Description：

In previous lesson, we control LED on and off and make it blink.

In this project, we will control the brightness of LED through PWM to simulate
breathing effects. Similarly, you can change the step length and delay time in
the code so as to demonstrate different breathing effects.

PWM is a means of controlling the analog output via digital means. Digital
control is used to generate square waves with different duty cycles (a signal
that constantly switches between high and low levels) to control the analog
output. In general, the input voltages of ports are 0V and 5V. What if the 3V is
required? Or a switch among 1V, 3V and 3.5V? We cannot change resistors
constantly. For this reason, we resort to PWM.

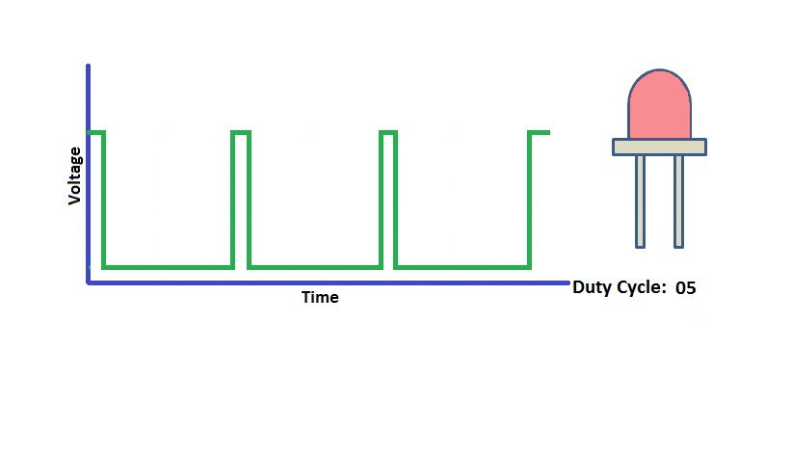
[picture p99: media/bbcfcb9ae56abb7e80ee587246fc4be9.GIF]


For the Arduino digital port voltage output, there are only LOW and HIGH, which
correspond to the voltage output of 0V and 5V. You can define LOW as 0 and HIGH
as 1, and let the Arduino output five hundred 0 or 1 signals within 1 second.

If output five hundred 1, that is 5V; if all of which is 1, that is 0V. If
output 010101010101 in this way then the output port is 2.5V, which is like
showing movie. The movie we watch are not completely continuous. It actually
outputs 25 pictures per second. In this case, the human can’t tell it, neither
does PWM. If want different voltage, need to control the ratio of 0 and 1. The
more 0,1 signals output per unit time, the more accurately control.

#### What You Need：



#### Wiring Diagram：



#### Test Code：

/\*

keyestudio 4wdRobot Arm Smart Car

lesson 2.1

pwm

http://www.keyestudio.com

\*/

int ledPin = 3; // Define the LED pin at D3

int value;

void setup () {

pinMode (ledPin, OUTPUT); // initialize ledpin as an output.

}

void loop () {

for (value = 0; value \<255; value = value + 1) {

analogWrite (ledPin, value); // LED lights gradually light up

delay (5); // delay 5MS

}

for (value = 255; value\> 0; value = value-1) {

analogWrite (ledPin, value); // LED gradually goes out

delay (5); // delay 5MS

}

}

#### Test Result：

After the program is uploaded successfully, the onboard LED blinks.
Congratulation, you finish the first program.

#### Code Explanation:

When we need to repeat some statements, we could use FOR statement.

FOR statement format is shown below:



FOR cyclic sequence:

Round 1：1 → 2 → 3 → 4

Round 2：2 → 3 → 4

…

Until number 2 is not established, “for”loop is over,

After knowing this order, go back to code:

**for (int value = 0; value \< 255; value=value+1){**

**...}**

**for (int value = 255; value \>0; value=value-1){**

**...}**

The two“for”statements make value increase from 0 to 255, then reduce from 255
to 0, then increase to 255,....infinitely loop

There is a new function in the following ----- analogWrite()

We know that digital port only has two state of 0 and 1. So how to send an
analog value to a digital value? Here,this function is needed. Let’s observe the
Arduino board and find 6 pins marked“\~”which can output PWM signals.

Function format as follows:

**analogWrite(pin,value)**

analogWrite() is used to write an analog value from 0\~255 for PWM port, so the
value is in the range of 0\~255. Attention that you only write the digital pins
with PWM function, such as pin 3, 5, 6, 9, 10, 11.

PWM is a technology to obtain analog quantity through digital method. Digital
control forms a square wave, and the square wave signal only has two states of
turning on and off (that is, high or low levels). By controlling the ratio of
the duration of turning on and off, a voltage varying from 0 to 5V can be
simulated. The time turning on(academically referred to as high level) is called
pulse width, so PWM is also called pulse width modulation.  
Through the following five square waves, let’s gain an insight to more about
PWM.

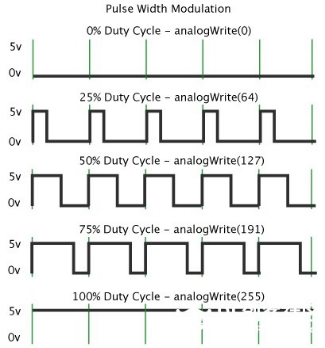
[picture p100: media/553f3d1b6ca04e1aa0479841dd075fa2.png]


In the above figure, the green line represents a period, and value of
analogWrite() corresponds to a percentage which is called Duty Cycle as well.
Duty cycle implies that high-level duration is divided by low-level duration in
a cycle. From top to bottom, the duty cycle of first square wave is 0% and its
corresponding value is 0. The LED brightness is lowest, that is, turn off. The
more time high level lasts, the brighter the LED. Therefore, the last duty cycle
is 100%, which correspond to 255, LED is brightest. And 25% means darker.

PWM mostly is used for adjusting the brightness of LED or rotation speed of
motor.

It plays a vital role in controlling smart robot car. I believe that you can’t
wait to enter the next project.

#### Extension Practice：

Let’s modify the value of the delaying time and remain the pin unchanged, then
observe how LED changes.

/\*

keyestudio 4wd Robot Arm Smart Car

lesson 2.2

pwm

http://www.keyestudio.com

\*/

int ledPin = 3; // Define the LED pin at D3

void setup(){

pinMode (ledPin, OUTPUT); // initialize ledpin as an output.

}

void loop(){

for (int value = 0; value \<255; value = value + 1){

analogWrite (ledPin, value); // LED lights gradually light up

delay (30); // delay 30MS

}

for(int value=255; value\>0;value=value-1){

analogWrite (ledPin, value); // LED gradually goes out

delay (30); // delay 30MS

}

}//\*\*\*\*\*\*\*\*\*\*\*\*\*\*\*\*\*\*\*\*\*\*\*\*\*\*\*\*\*\*\*\*\*\*\*\*\*\*\*\*\*\*\*\*\*\*\*\*\*\*\*\*\*\*\*\*\*\*

Upload the code to development board, then LED blinks more slowly.

**Project 3: Servo Control**

#### Description：

Servo motor is a position control rotary actuator. It mainly consists of a
housing, circuit board, core-less motor, gear and position sensor. Its working
principle is that the servo receives the signal sent by MCUs or receivers and
produces a reference signal with a period of 20ms and width of 1.5ms, then
compares the acquired DC bias voltage to the voltage of the potentiometer and
obtain the voltage difference output.

When the motor speed is constant, the potentiometer is driven to rotate through
the cascade reduction gear, which leads that the voltage difference is 0, and
the motor stops rotating. Generally, the angle range of servo rotation is 0°
\--180 °.

The rotation angle of servo motor is controlled by regulating the duty cycle of
PWM (Pulse-Width Modulation) signal. The standard cycle of PWM signal is 20ms
(50Hz). Theoretically, the width is distributed between 1ms-2ms, but in fact,
it's between 0.5ms-2.5ms. The width corresponds the rotation angle from 0° to
180°. But note that for motors of different brands, the same signal may have
different rotation angle.

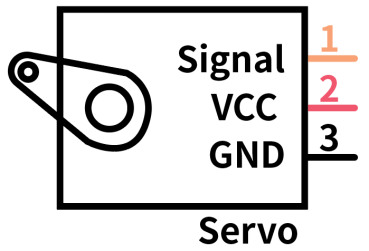
[picture p101: media/69be958142b773acdae33eeef12afed7.png]


In general, servo has three lines in brown, red and orange. The brown wire is
grounded, the red one is a positive pole line and the orange one is a signal
line.

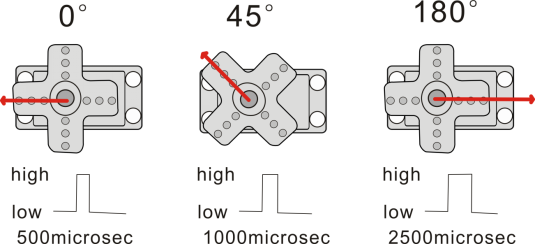
[picture p102: media/49467dfa70799401a5a5acc691014aee.png]


The corresponding servo angles are shown below:

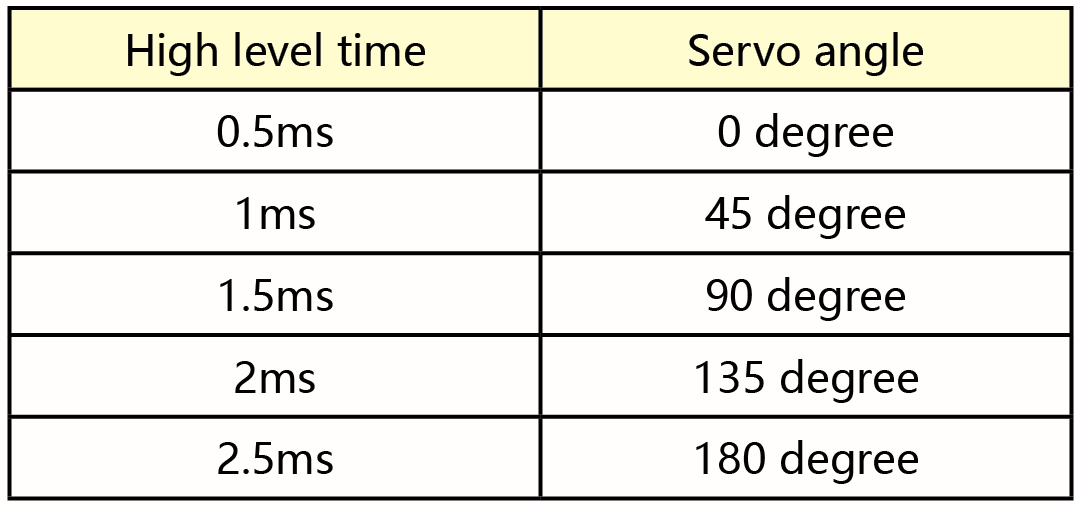
[picture p103: media/ddc74f62dc936c925d28d70a1a9c2214.png]


#### Specification：

Working voltage: DC 4.8V \~ 6V  
Operating angle range: about 180 ° (at 500 → 2500 μsec)  
Pulse width range: 500 → 2500 μsec  
No-load speed: 0.12 ± 0.01 sec / 60 (DC 4.8V) 0.1 ± 0.01 sec / 60 (DC 6V)  
No-load current: 200 ± 20mA (DC 4.8V) 220 ± 20mA (DC 6V)  
Stopping torque: 1.3 ± 0.01kg · cm (DC 4.8V) 1.5 ± 0.1kg · cm (DC 6V)  
Stop current: ≦ 850mA (DC 4.8V) ≦ 1000mA (DC 6V)

Standby current: 3 ± 1mA (DC 4.8V) 4 ± 1mA (DC 6V)

#### What You Need：

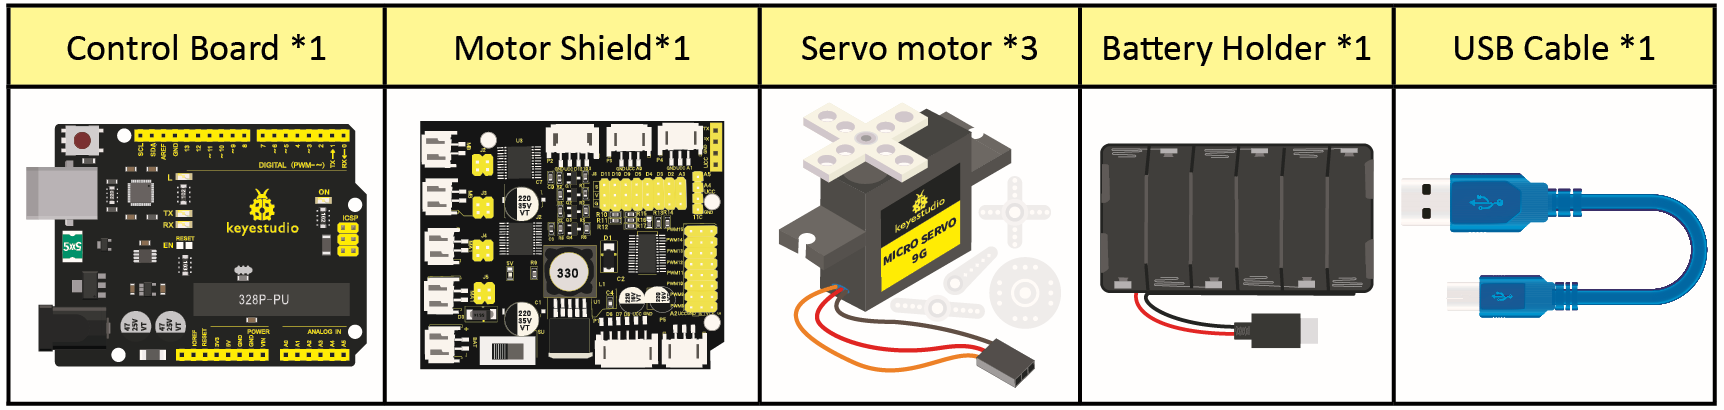
[picture p104: media/33f18c9ed298ff286ed539be3cee9586.png]


#### Wiring Diagram：

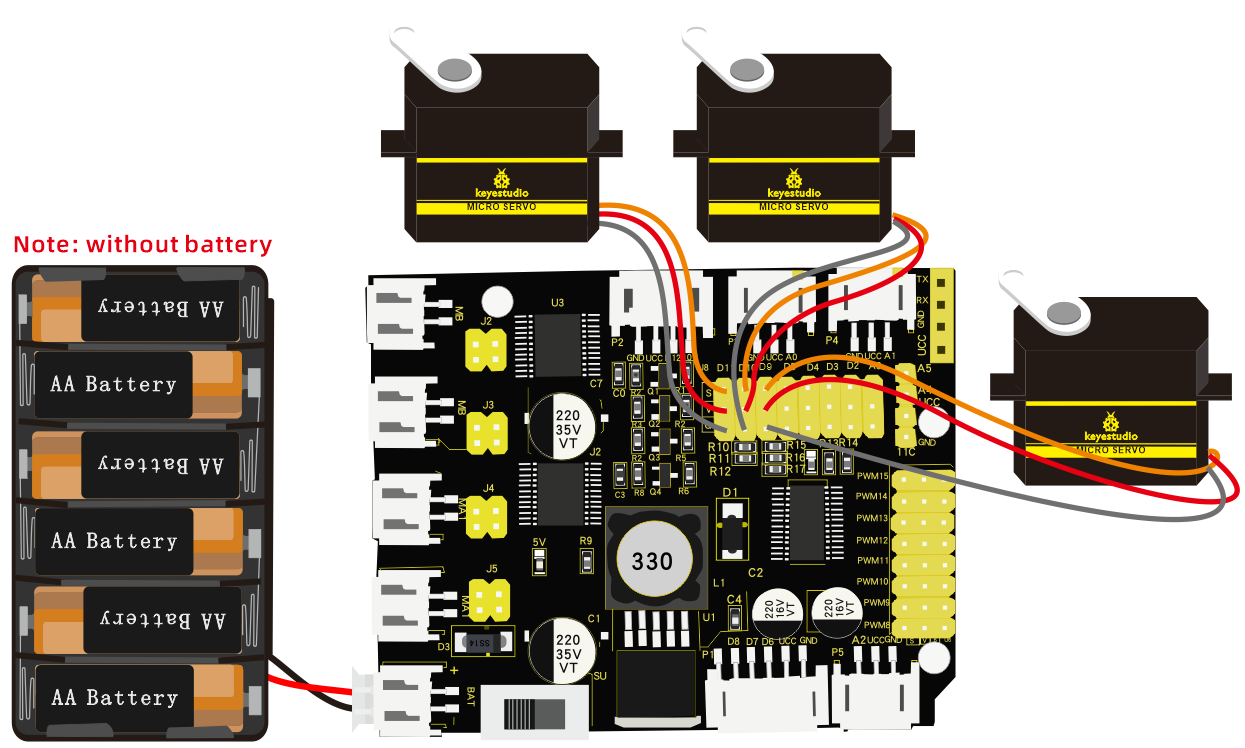
[picture p105: media/931420c1b4a1f2506fca9c9436a58eae.png]


Wiring note: the brown wire of servo is linked with Gnd(G), the red one is
connected to V and the orange one is attached to S.

The servo has to be connected to external power due to its high demand for
driving servo current. Generally, the current of development board is not big
enough. If without connected power, the development board could be burnt.

#### Test Code1：

/\*

keyestudio 4wdRobot Arm Smart Car

lesson 3.1

Servo

http://www.keyestudio.com

\*/

\##define servoPin 9 //servo Pin

int pos; //angle variable of servo

int pulsewidth; ///pulsewidth variable of servo

void setup() {

pinMode(servoPin, OUTPUT); //set pins of servo to output

procedure(0); //set angle of servo to 0°

}

void loop() {

for (pos = 0; pos \<= 180; pos += 1) { // goes from 0 degrees to 180 degrees

// in steps of 1 degree

procedure(pos); // tell servo to go to position in variable 'pos'

delay(15); //control the rotation speed of servo

}

for (pos = 180; pos \>= 0; pos -= 1) { // goes from 180 degrees to 0 degrees

procedure(pos); // tell servo to go to position in variable 'pos'

delay(15);

}}

//Function to control servo

void procedure(int myangle) {

pulsewidth = myangle \* 11 + 500; //Calculate pulsewidth value

digitalWrite(servoPin,HIGH);

delayMicroseconds(pulsewidth); //the duration of high levle is pulsewidth

digitalWrite(servoPin,LOW);

delay((20 - pulsewidth / 1000)); //the period is 20ms, so the low level last for
the rest of time

}//\*\*\*\*\*\*\*\*\*\*\*\*\*\*\*\*\*\*\*\*\*\*\*\*\*\*\*\*\*\*\*\*\*\*\*\*\*\*\*\*\*\*\*\*\*\*\*\*\*\*\*\*\*\*\*\*\*\*\*\*\*\*\*\*\*\*\*\*\*\*\*\*\*\*\*\*\*\*\*\*\*\*

Upload code successfully, servo swings forth and back in the range of 0° to 180°

There is another guide for restraining servo---- servo library file, the
following link of official website is as for your reference.

<https://www.arduino.cc/en/Reference/Servo>

1.  **Test Code2:**

/\*

keyestudio 4wd Robot Arm Smart Car

lesson 3.2

servo

http://www.keyestudio.com

\*/

\##include \<Servo.h\>

Servo myservo; // create servo object to control a servo

// twelve servo objects can be created on most boards

int pos = 0; // variable to store the servo position

void setup() {

myservo.attach(9); // attaches the servo on pin 9 to the servo object

}

void loop() {

for (pos = 0; pos \<= 180; pos += 1) { // goes from 0 degrees to 180 degrees

// in steps of 1 degree

myservo.write(pos); // tell servo to go to position in variable 'pos'

delay(15); // waits 15ms for the servo to reach the position

}

for (pos = 180; pos \>= 0; pos -= 1) { // goes from 180 degrees to 0 degrees

myservo.write(pos); // tell servo to go to position in variable 'pos'

delay(15); // waits 15ms for the servo to reach the position

}}//\*\*\*\*\*\*\*\*\*\*\*\*\*\*\*\*\*\*\*\*\*\*\*\*\*\*\*\*\*\*\*\*\*\*\*\*\*\*\*\*\*\*\*\*\*\*\*\*\*\*\*\*\*\*\*\*\*\*\*\*\*\*\*\*\*\*\*\*\*\*\*\*\*\*

1.  **Test Result：**

Upload code successfully and power on, then servo swings in the range of 0° to
180°. The result is the same. We usually control it by library file.

#### Code Explanation:

Arduino comes with **\##include \<Servo.h\>** (servo function and statement）

The following are some common statements of the servo function:  
1\. **attach（interface）**——Set servo interface, port 9 and 10 are available

2\. **write（angle）**——The statement to set rotation angle of servo, the angle
range is from 0° to 180°  
3\. **read（）**——used to read angle of servo, read the command value of“write()”

4\. **attached（）**——Judge if the parameter of servo is sent to its interface  
Note: The above written format is“servo variable name, specific statement（）”,
for instance: myservo.attach(9)

### Project 4: Ultrasonic Ranging

#### Description：

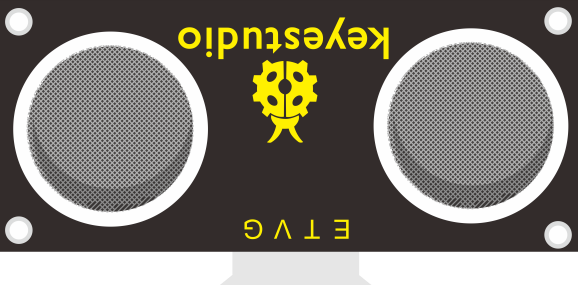
[picture p106: media/9ec82d5decff50a7a28326e4286c075d.png]


The HC-SR04 ultrasonic sensor uses sonars to determine distance away from an
object like bats do. It offers excellent non-contact range detection with high
accuracy and stable readings in an easy-to-use package. It comes with an
ultrasonic transmitter and a receiver module.

The HC-SR04 or the ultrasonic sensor is used in a wide range of electronics
projects for creating obstacle detection and distance measuring as well as
various other applications. Here we have brought the simple method to measure
the distance with Arduino and ultrasonic sensor and how to use ultrasonic sensor
with Arduino.

#### Specification：

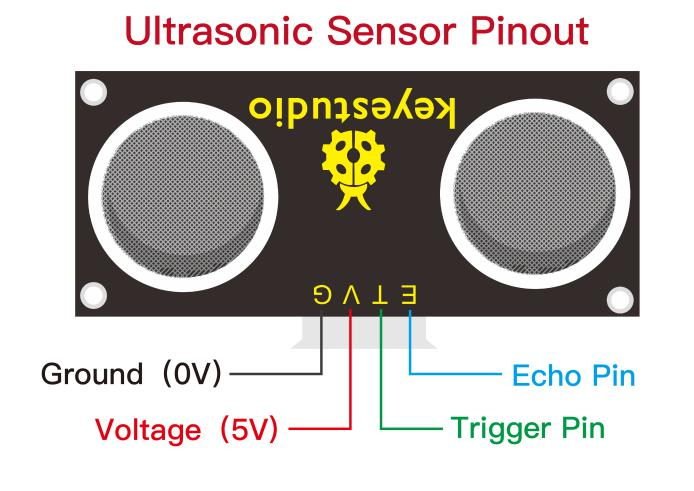
[picture p107: media/9d0b270c28f9587419b7c5de558ee11d.jpeg]


Power Supply :+5V DC

Quiescent Current : \<2mA

Working Current: 15mA

Effectual Angle: \<15°

Ranging Distance : 2cm – 400 cm

Resolution : 0.3 cm

Measuring Angle: 30 degree

Trigger Input Pulse width: 10uS

#### What You Need：

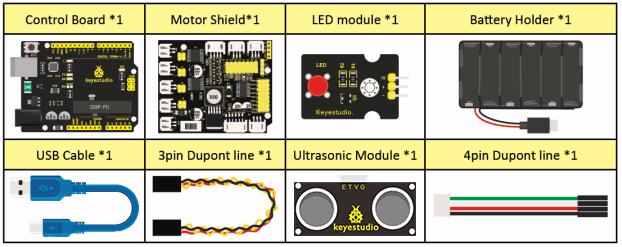
[picture p108: media/dad870ed5ccdd79146afba7e43e55408.jpeg]


1.  **The principle of ultrasonic sensor**

As the above picture shown, it is like two eyes. One is transmitting end, the
other is receiving end.

The ultrasonic module will emit the ultrasonic waves after triggering signals.
When the ultrasonic waves encounter the object and are reflected back, the
module outputs an echo signal, so it can determine the distance of object from
the time gap between triggering the signal and echoing the signal.  
The t is the time that the emitting signal meets the obstacle and returns. And
the propagation speed of sound in the air is about 343m/s, and distance = speed
\* time. However, the ultrasonic wave emits and comes back, which is 2 times of
distance. Therefore, it needs to be divided by 2, the distance measured by
ultrasonic wave = (speed \* time)/2.

1.  Use method and timing chart of ultrasonic module:  
    Setting the delaying time of Trig pin of SR04 to 10μs at least, which can
    trigger it to detect distance.  
    2\. After triggering, the module will automatically send eight 40KHz
    ultrasonic pulses and detect whether there is a signal return. This step
    will be completed automatically by the module.  
    3\. If the signal returns, the Echo pin will output a high level, and the
    duration of the high level is the time from the transmission of the
    ultrasonic wave to the return.

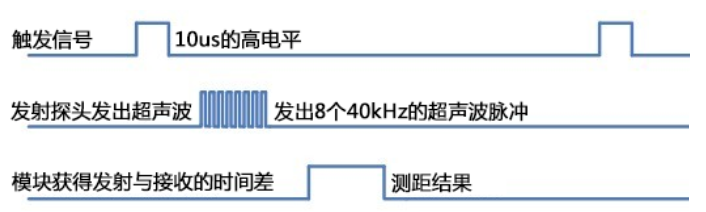
[picture p109: media/ba43be6007d9fe3aab0bb609868af640.png]


Circuit diagram of ultrasonic sensor:

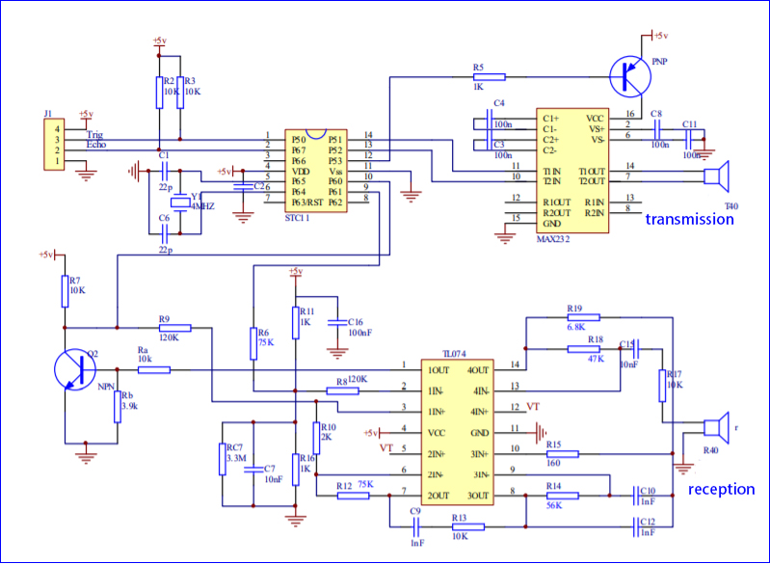
[picture p110: media/a25028af84d6c7c94382c2a907101241.jpeg]


#### Wiring Diagram：

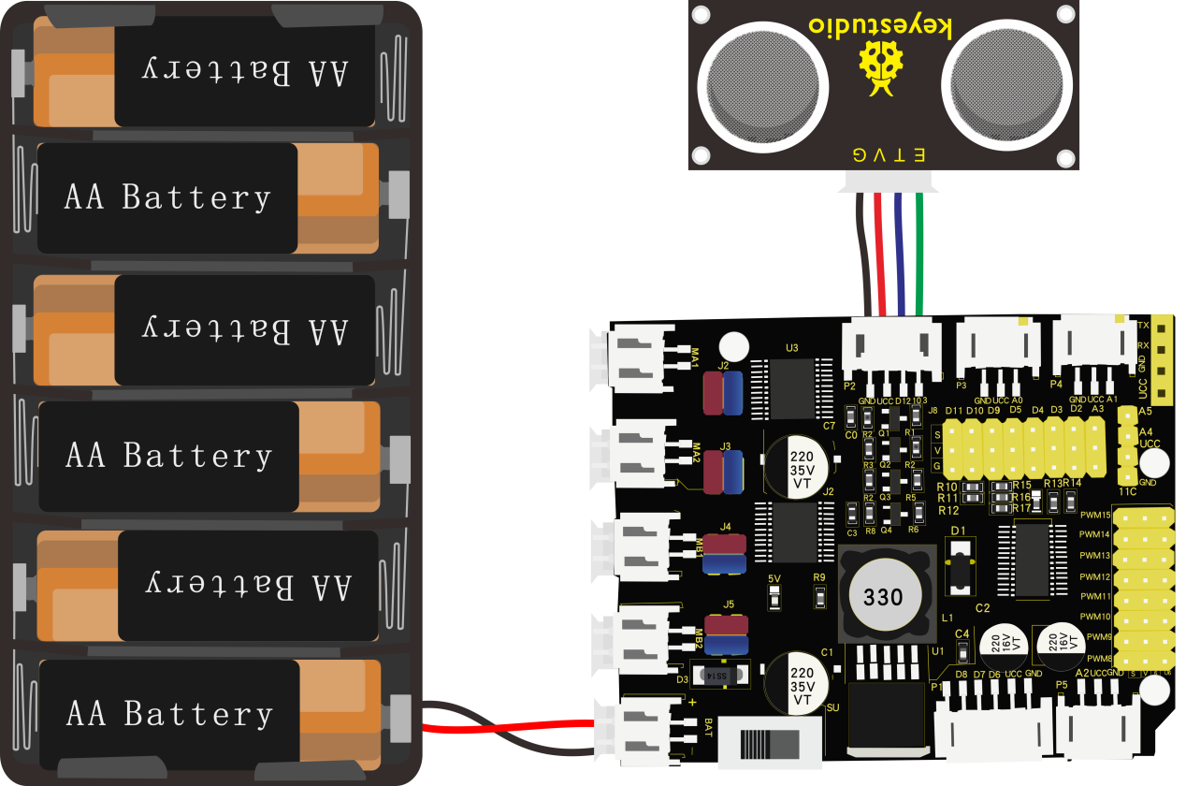
[picture p111: media/a65fa7969238068510a52aed6b1458d5.png]


Wiring Guide:

Ultrasonic sensor keyestudio Sensor Shield

V → (V)

T → 12(S)

Echo → 13(S)

G → G(G)

#### Test Code：

/\*

keyestudio 4wdRobot Arm Smart Car

lesson 4.1

Ultrasonic sensor

http://www.keyestudio.com

\*/

int trigPin = 12; // Trigger

int echoPin = 13; // Echo

long duration, cm, inches;

void setup() {

//Serial Port begin

Serial.begin (9600);

//Define inputs and outputs

pinMode(trigPin, OUTPUT);

pinMode(echoPin, INPUT);

}

void loop() {

// The sensor is triggered by a HIGH pulse of 10 or more microseconds.

// Give a short LOW pulse beforehand to ensure a clean HIGH pulse:

digitalWrite(trigPin, LOW);

delayMicroseconds(2);

digitalWrite(trigPin, HIGH);

delayMicroseconds(10);

digitalWrite(trigPin, LOW);

// Read the signal from the sensor: a HIGH pulse whose

// duration is the time (in microseconds) from the sending

// of the ping to the reception of its echo off of an object.

duration = pulseIn(echoPin, HIGH);

// Convert the time into a distance

cm = (duration/2) / 29.1; // Divide by 29.1 or multiply by 0.0343

inches = (duration/2) / 74; // Divide by 74 or multiply by 0.0135

Serial.print(inches);

Serial.print("in, ");

Serial.print(cm);

Serial.print("cm");

Serial.println();

delay(50);

}

//\*\*\*\*\*\*\*\*\*\*\*\*\*\*\*\*\*\*\*\*\*\*\*\*\*\*\*\*\*\*\*\*\*\*\*\*\*\*\*\*\*\*\*\*\*\*\*\*\*\*\*\*\*\*\*\*\*\*\*\*\*\*\*\*\*\*\*\*\*\*\*\*\*\*

1.  **Test Result：**

Upload test code on the development board, open serial monitor and set baud rate
to 9600. The detected distance will be displayed, and the unit is cm and inch.
Hindering the ultrasonic sensor by hand, you can view the displayed distance
values get smaller.

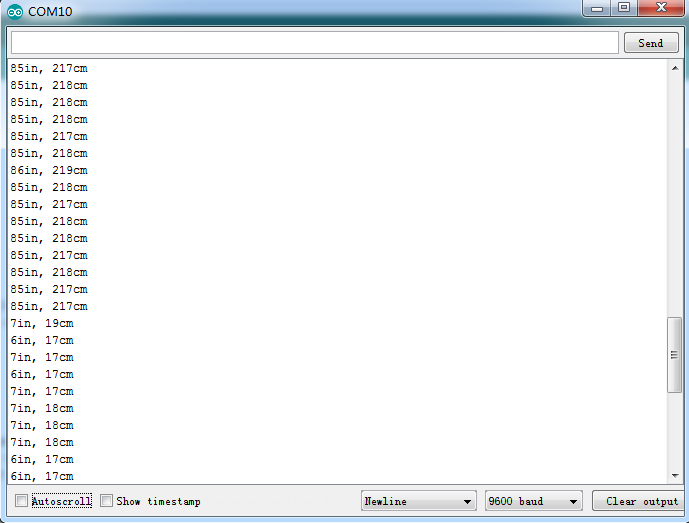
[picture p112: media/db57c5b23e2d6dd41ad70d6331297262.png]


1.  **Code Explanation**

**int trigPin-** this pin is defined to transmit ultrasonic waves, generally
output.

**int echoPin -** this is defined as the pin of reception, generally input

**cm = (duration/2) / 29.1-unit is cm**

**inches = (duration/2) / 74-unit is inch**

We can calculate the distance by using the following formula:

distance = (traveltime/2) x speed of sound

The speed of sound is: 343m/s = 0.0343 cm/uS = 1/29.1 cm/uS

Or in inches: 13503.9in/s = 0.0135in/uS = 1/74in/uS

We need to divide the traveltime by 2 because we have to take into account that
the wave was sent, hit the object, and then returned back to the sensor.

1.  **Extension Practice：**

We have just measured the distance displayed by the ultrasonic. How about
controlling the LED with the measured distance? Let's try it and connect an LED
module to the D3 pin.

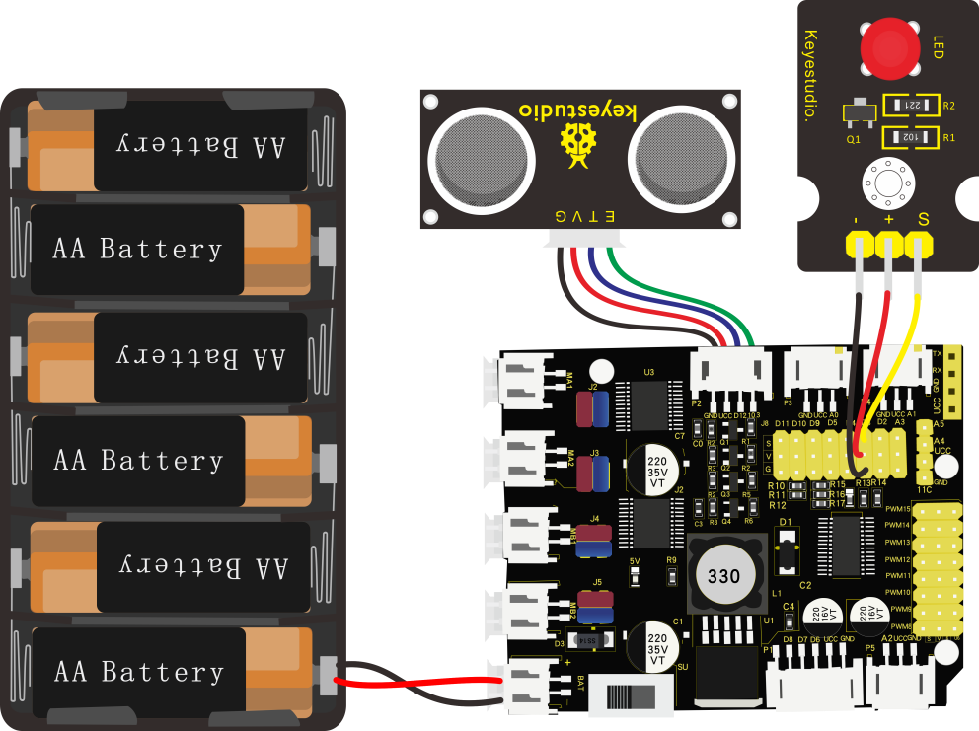
[picture p113: media/1859674679c7eae9296c8e7fa9d021f2.png]


/\*

keyestudio 4wdRobot Arm Smart Car

lesson 4.2

Ultrasonic LED

http://www.keyestudio.com

\*/

int trigPin = 12; // Trigger

int echoPin = 13; // Echo

long duration, cm, inches;

void setup() {

Serial.begin (9600); //Serial Port begin

pinMode(trigPin, OUTPUT); //Define inputs and outputs

pinMode(echoPin, INPUT);

pinMode(3, OUTPUT);

}

void loop()

{

// The sensor is triggered by a HIGH pulse of 10 or more microseconds.

// Give a short LOW pulse beforehand to ensure a clean HIGH pulse:

digitalWrite(trigPin, LOW);

delayMicroseconds(2);

digitalWrite(trigPin, HIGH);

delayMicroseconds(10);

digitalWrite(trigPin, LOW);

// Read the signal from the sensor: a HIGH pulse whose

// duration is the time (in microseconds) from the sending

// of the ping to the reception of its echo off of an object.

duration = pulseIn(echoPin, HIGH);

// Convert the time into a distance

cm = (duration/2) / 29.1; // Divide by 29.1 or multiply by 0.0343

inches = (duration/2) / 74; // Divide by 74 or multiply by 0.0135

Serial.print(inches);

Serial.print("in, ");

Serial.print(cm);

Serial.print("cm");

Serial.println();

delay(50);

if (cm\>=2 && cm\<=10)digitalWrite(3, HIGH);

else digitalWrite(3, LOW);

}//\*\*\*\*\*\*\*\*\*\*\*\*\*\*\*\*\*\*\*\*\*\*\*\*\*\*\*\*\*\*\*\*\*\*\*\*\*\*\*\*\*\*\*\*\*\*\*\*\*\*\*\*\*\*\*\*\*\*\*\*\*\*\*\*

Upload test code to development board and put you hand away from the ultrasonic
sensor for 2cm-10cm, then LED will be on.

### Project 5: Line Tracking Sensor

#### Description：

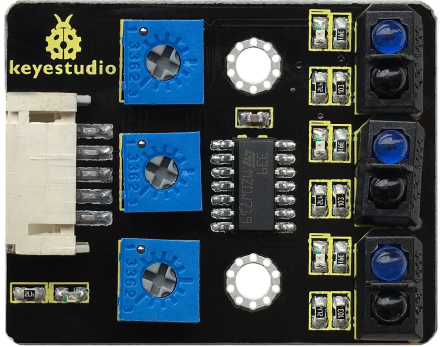
[picture p114: media/d37c24e508361ab86b019135ab6950a9.png]
The tracking sensor is
actually an infrared sensor. The component used here is the TCRT5000 infrared
tube.

Its working principle is to use the different reflectivity of infrared light to
the color, then convert the strength of the reflected signal into a current
signal.

During the process of detection, black is active at HIGH level, but white is
active at LOW level. The detection height is 0-3 cm.

Keyestudio 3-channel line tracking module has integrated 3 sets of TCRT5000
infrared tube on a single board, which is more convenient for wiring and
control.

By rotating the adjustable potentiometer on the sensor, it can adjust the
detection sensitivity of the sensor.

#### Specification：

Operating Voltage: 3.3-5V (DC)

Interface: 5PIN

Output Signal: Digital signal

Detection Height: 0-3 cm

Special note: before testing, turn the potentiometer on the sensor to adjust the
detection sensitivity. When adjust the LED at the threshold between ON and OFF,
the sensitivity is the best.

#### What You Need：

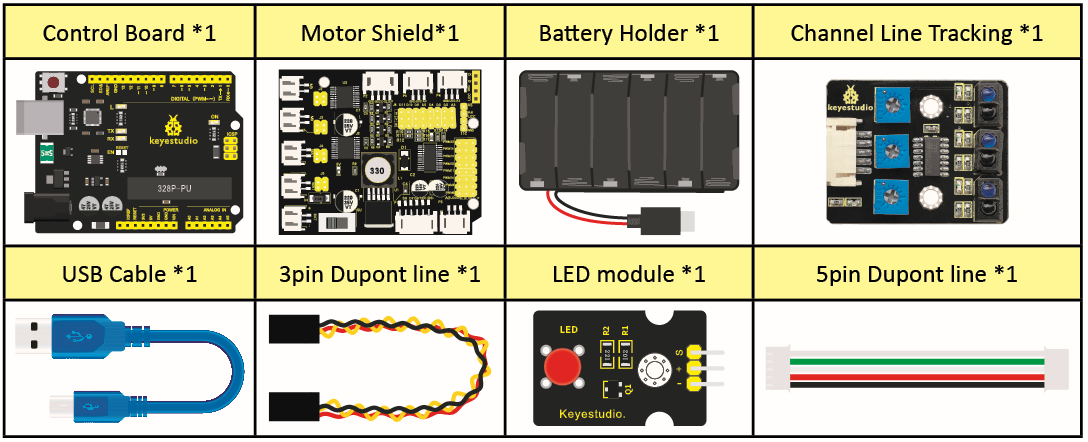
[picture p115: media/4201f6589edea60526281f719533f9a7.png]


#### Wiring Diagram：

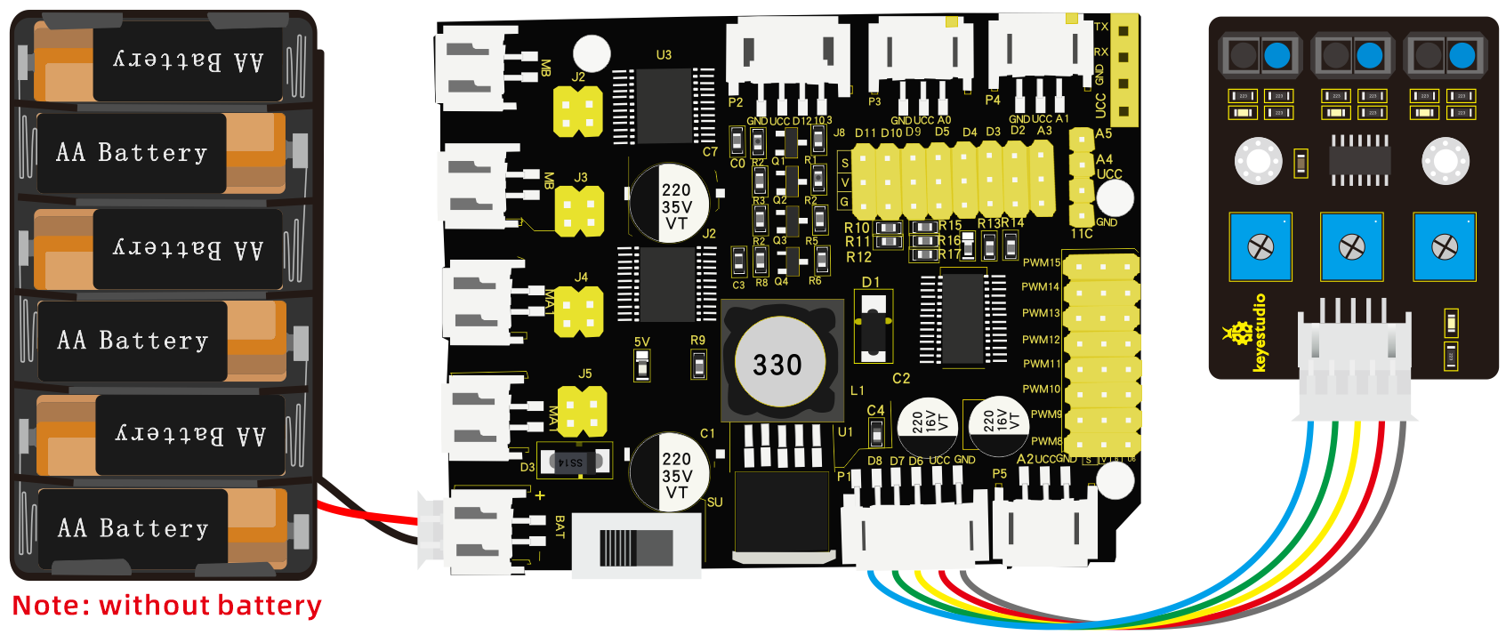
[picture p116: media/3b1edd87ad50b4225ac19ed8b9f307b9.png]


G and V of line tracking sensor are connected to G and V of shield, the rest
pins are linked with D6, D7, D8 respectively.

#### Test Code：

/\*

keyestudio 4wdRobot Arm Smart Car

lesson 5.1

Line Tracking sensor

http://www.keyestudio.com

\*/

\##define SensorLeft 6 //input pin of left sensor

\##define SensorMiddle 7 //input pin of middle sensor

\##define SensorRight 8 //input pin of right sensor

unsigned char SL; //state of left sensor

unsigned char SM; //state of middle sensor

unsigned char SR; //state of right sensor

void setup(){

//set baud rate to 9600

Serial.begin(9600);

//set to input mode

pinMode(SensorLeft,INPUT);

pinMode(SensorMiddle,INPUT);

pinMode(SensorRight,INPUT);

}

void loop(){

//read the values of three line tracking sensors

SL = digitalRead(SensorLeft);

SM = digitalRead(SensorMiddle);

SR = digitalRead(SensorRight);

//print the values of three sensors

Serial.print("SL=");

Serial.print(SL);

Serial.print("SM=");

Serial.print(SM);

Serial.print("SR=");

Serial.println(SR);

}

#### Test Result：

Upload the code on development board, open serial monitor to check line tracking
sensors. And the displayed value is 1(high level) when no signals are received.
The value becomes into 0 when covering sensor with paper.

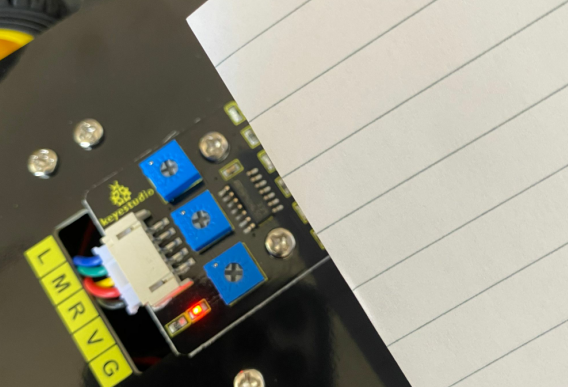
[picture p117: media/2fd58c7a9f95fb9f694edf03e755042f.png]


#### Code Explanation:

**Serial.begin(9600)**- Initialize serial port and set baud rate to 9600

**pinMode-** Define the pin as an input or output mode

\*\*digitalRead-\*\*Read the state of pins, which are generally HIGH and LOW
level

#### Extension Practice：

Connect an LED to D3, then we could control LED by line tracking sensor.

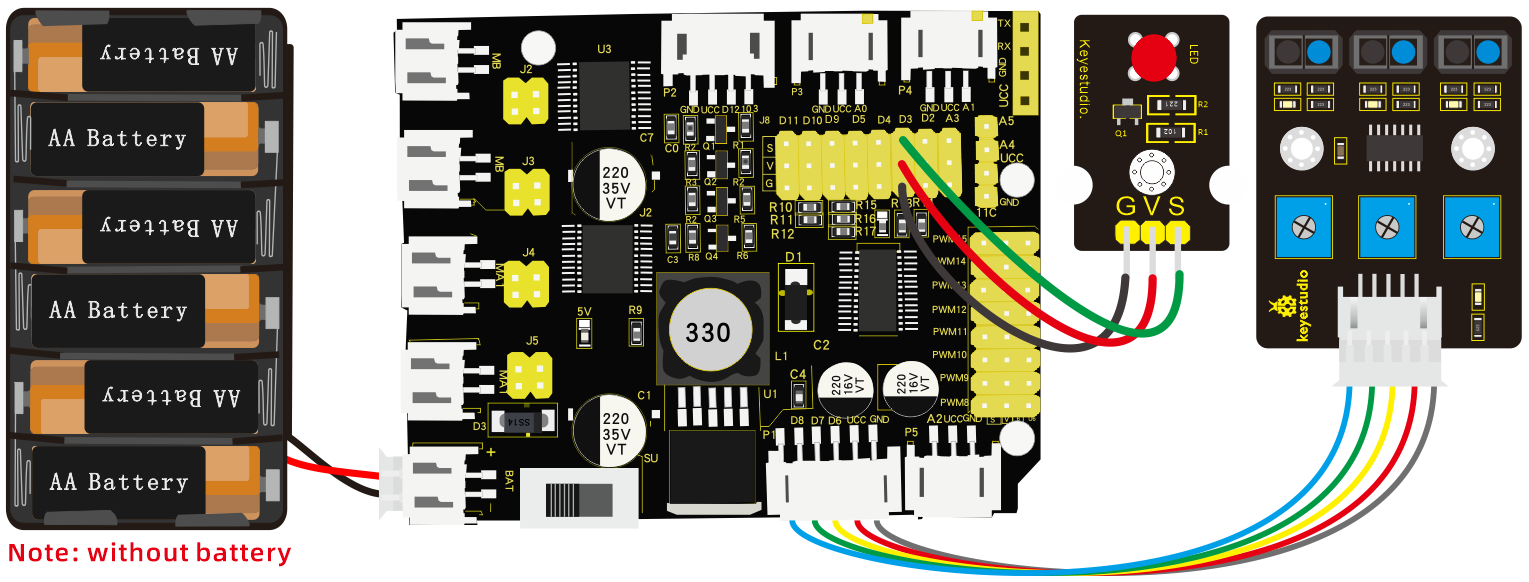
[picture p118: media/c9660e804833c678e32b0fb25342eec6.png]


/\*

keyestudio 4WD Robot Arm Smart Car

lesson 5.2

Line Track sensor

http://www.keyestudio.com

\*/

int L_pin = 6; //pins of left line tracking sensor

int M_pin = 7; //pins of middle line tracking sensor

int R_pin = 8; //pins of right line tracking sensor

int val_L,val_R,val_M;// define the variables of three sensors

void setup()

{

Serial.begin(9600); // initialize serial communication at 9600 bits per second

pinMode(L_pin,INPUT); // make the L_pin as an input

pinMode(M_pin,INPUT); // make the M_pin as an input

pinMode(R_pin,INPUT); // make the R_pin as an input

pinMode(3, OUTPUT);

}

void loop()

{

val_L = digitalRead(L_pin);//read the L_pin:

val_R = digitalRead(R_pin);//read the R_pin:

val_M = digitalRead(M_pin);//read the M_pin:

Serial.print("left:");

Serial.print(val_L);

Serial.print(" middle:");

Serial.print(val_M);

Serial.print(" right:");

Serial.println(val_R);

if (val_L == HIGH)//if left line tracking sensor detects signals

{

digitalWrite(3, LOW);///LED is off

}

else//if left line tracking sensor doesn’t detect signals

{

digitalWrite(3, HIGH);//LED lights up

delay(2000);

}

if (val_R == HIGH)//if right line tracking sensor detects signals

{

digitalWrite(3, LOW);//LED off

}

else//if right line tracking sensor doesn’t detect signals

{

digitalWrite(3, HIGH);//LED lights up

delay(2000);

}

if (val_M == HIGH)//if middle line tracking sensor doesn’t detect signals

{

digitalWrite(3, LOW);//LED is off

}

else//if middle line tracking sensor doesn’t detect signals

{

digitalWrite(3, HIGH);//LED is on

delay(2000);

}

}

//\*\*\*\*\*\*\*\*\*\*\*\*\*\*\*\*\*\*\*\*\*\*\*\*\*\*\*\*\*\*\*\*\*\*\*\*\*\*\*\*\*\*\*\*\*\*\*\*\*\*\*\*\*\*\*\*\*\*\*\*\*\*\*\*\*\*\*\*\*\*\*\*\*\*\*\*

Upload the code to development board, we observe LED get brighter when covering
the line tracking sensor by hand.

### Project 6: IR Reception

#### Description：

There is no doubt that infrared remote control is ubiquitous in daily life. It
is used to control various household appliances, such as TVs, stereos, video
recorders and satellite signal receivers. Infrared remote control is composed of
infrared transmitting and infrared receiving systems, that is, an infrared
remote control and infrared receiving module and a single-chip microcomputer
capable of decoding.

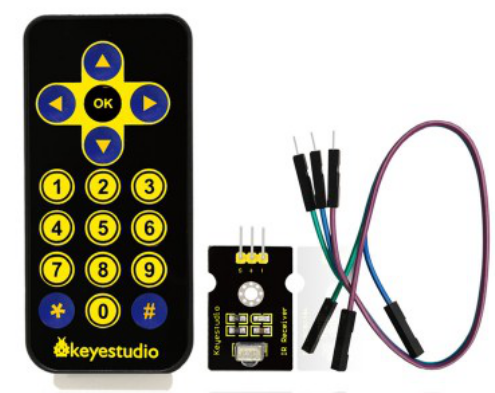
[picture p119: media/e0644987f70b38cdabde382b27858604.png]
The 38K infrared carrier signal
emitted by remote controller is encoded by the encoding chip in the remote
controller. It is composed of a section of pilot code, user code, user inverse
code, data code, and data inverse code. The time interval of the pulse is used
to distinguish whether it is a 0 or 1 signal and the encoding is made up of
these 0, 1 signals.

The user code of the same remote control is unchanged. The data code can
distinguish the key.

When the remote control button is pressed, the remote control sends out an
infrared carrier signal. When the IR receiver receives the signal, the program
will decode the carrier signal and determines which key is pressed. The MCU
decodes the received 01 signal, thereby judging what key is pressed by the
remote control.  
Infrared receiver we use is an infrared receiver module. Mainly composed of an
infrared receiver head, it is a device that integrates reception, amplification,
and demodulation. Its internal IC has completed demodulation, and can achieve
from infrared reception to output and be compatible with TTL signals.
Additionally, it is suitable for infrared remote control and infrared data
transmission. The infrared receiving module made by the receiver has only three
pins, signal line, VCC and GND. It is very convenient to communicate with
Arduino and other microcontrollers.

#### Specification：

Operating Voltage: 3.3-5V（DC）

Interface: 3PIN

Output Signal: Digital signal

Receiving Angle: 90 degrees

Frequency: 38khz

Receiving Distance: 10m

#### What You Need：

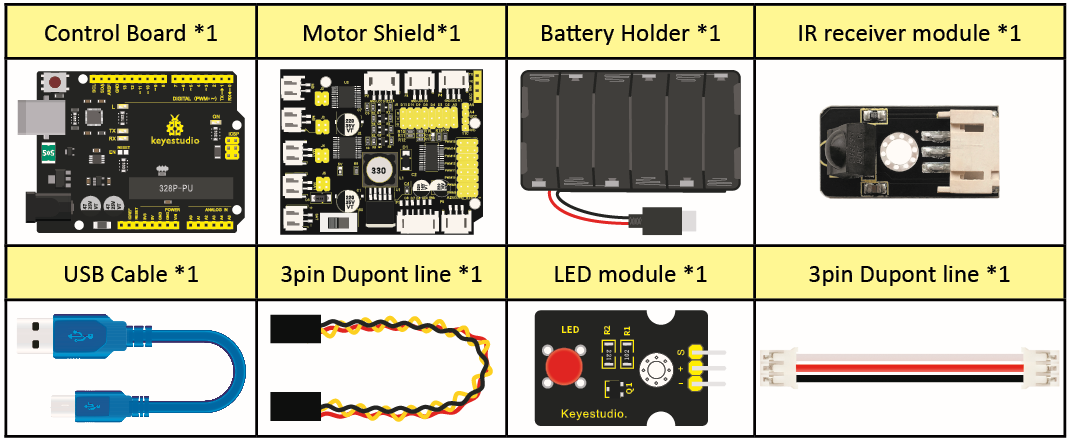
[picture p120: media/6d8a1f49dc4c47e2346828c3645b16eb.png]


#### Test Code：

/\*

keyestudio 4wdRobot Arm Smart Car

lesson 6.1

IRremote

http://www.keyestudio.com

\*/

\##include \<IRremote.h\>

int RECV_PIN =A0; //IR receiver is connected to A0

IRrecv irrecv(RECV_PIN);

decode_results results;

void setup(){

Serial.begin(9600); //set baud rate to 9600

irrecv.enableIRIn(); // Enable receiver

}

void loop(){

if(irrecv.decode(&results)){

Serial.println(results.value,HEX); //Wrap word in 16 HEX to output and receive
code

irrecv.resume(); // Receive the next value

}

delay(10);

}

#### Wiring Diagram：

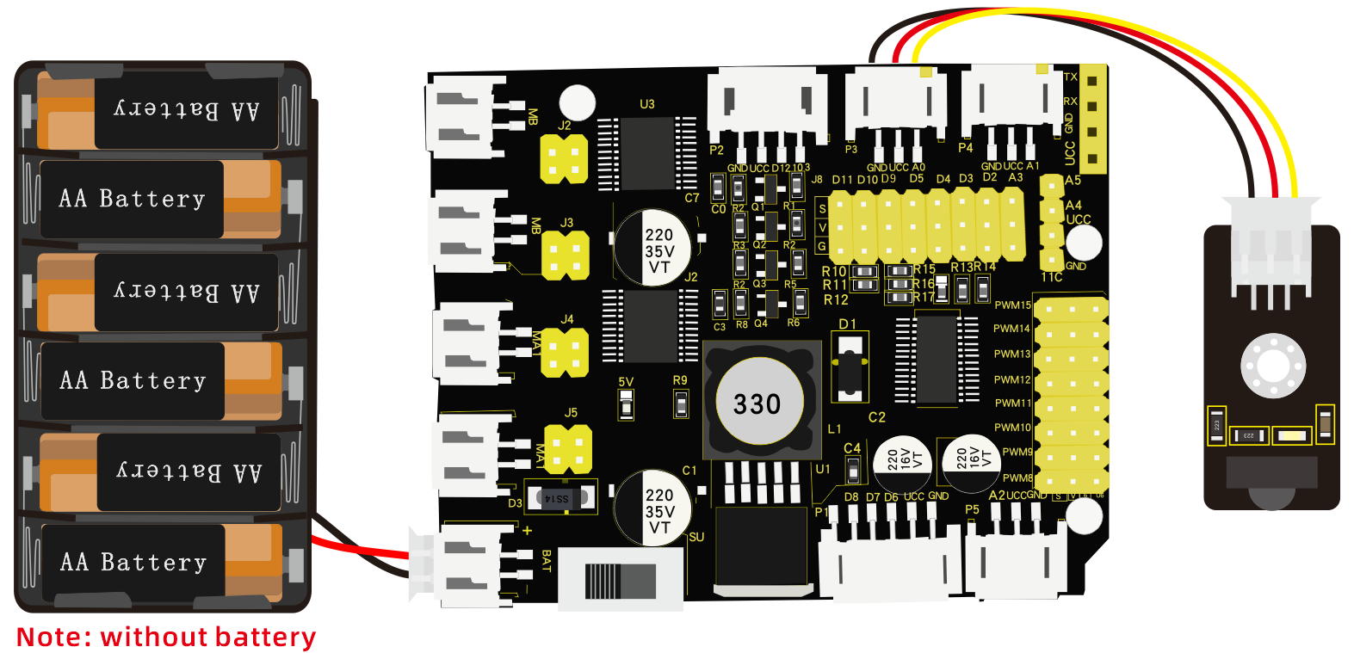
[picture p121: media/69dc7588477c2ad2216fa49ab44eb1c8.png]


Respectively link“-”,“+”and S of IR receiver module with G(GND）, V（VCC）and A0
of keyestudio development board.

Attention: On the condition that digital ports are not available, analog ports
can be regarded as digital ports. A0 equals to D14, and A1 is equivalent to
digital 15.

#### Test Result：

Upload test code, open serial monitor and set baud rate to 9600. If you point
remote control to IR receiver, the corresponding value will be shown; if holding
down the key, the error codes(FFFFFFFF) will appear, which means transmitting
same key.

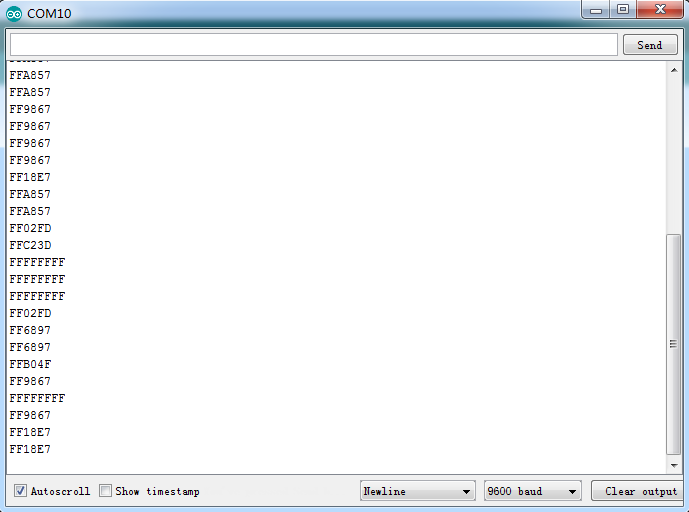
[picture p122: media/92887b989e103ef082569bbb34817852.png]


Below we have listed out each button value of Keyestudio remote control. So you
can keep it for reference.

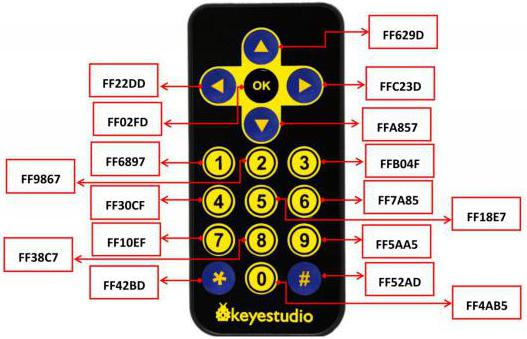
[picture p123: media/ebcf0cb2055f7784505f76ceeaef9f47.jpeg]


1.  **Code Explanation:**

**irrecv.enableIRIn():** after enabling IR decoding, the IR signals will be
received.

Function“decode()”will check continuously if decode successfully.

**irrecv.decode(&results):** after decoding successfully, this function will
come back to“true”, and keep result in“results”. After decoding a IR signals,
run the resume()function and receive the next signal.

#### Extension Practice：

We decoded the key value of IR remote control. How about controlling LED by the
measured value? We could operate an experiment to affirm. Attach an LED to D3,
then press the keys of remote control to make LED light up and off.

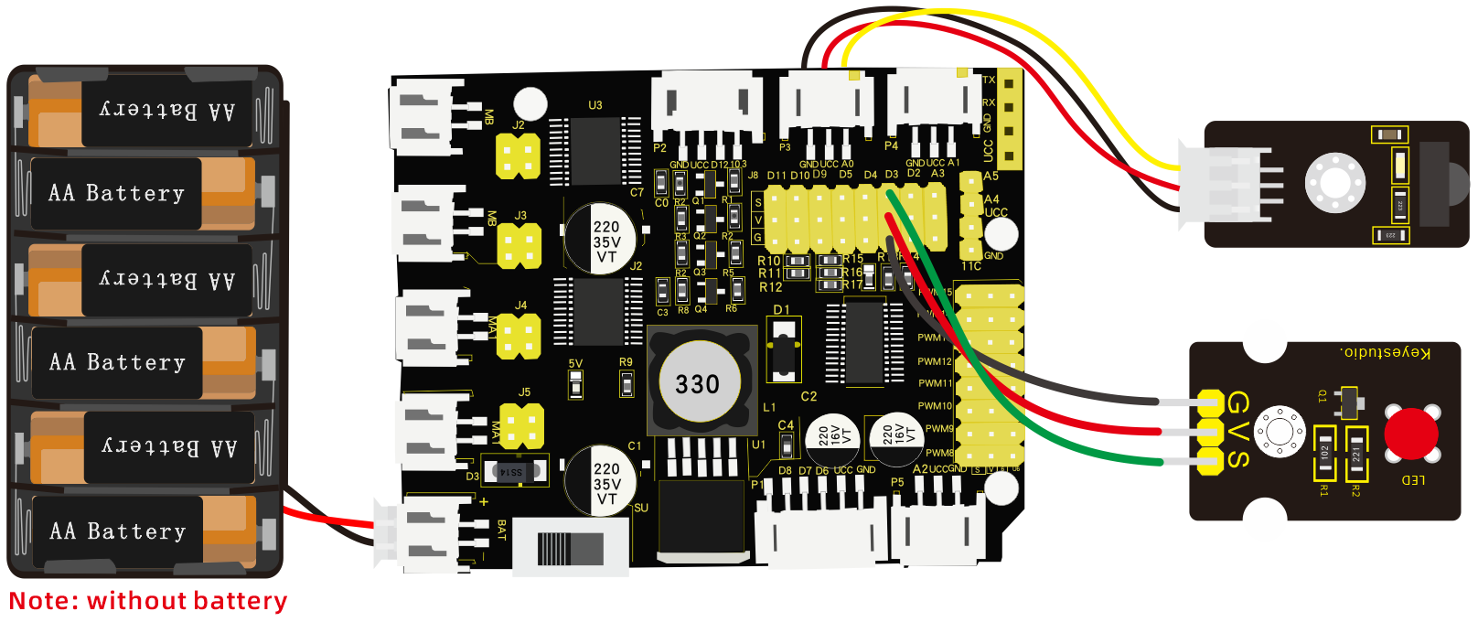
[picture p124: media/32b994e211e82ffc56ddf8d6ac54fb39.png]


/\* keyestudio 4wd BT Car V2

lesson 6.2

IRremote

http://www.keyestudio.com

\*/

\##include \<IRremote.h\>

int RECV_PIN = A0;//define the pin of IR receiver as A0

int LED_PIN=3;//define the pin of LED as pin 3

int a=0;

IRrecv irrecv(RECV_PIN);

decode_results results;

void setup()

{Serial.begin(9600);

irrecv.enableIRIn(); // Initialize the IR receiver

pinMode(LED_PIN,OUTPUT);//set pin 3 of LED to OUTPUT

}

void loop() {

if (irrecv.decode(&results)) {

if(results.value==0xFF02FD \&a==0) //according to the above key value,
press“OK”on remote control , LED will be controlled

{digitalWrite(LED_PIN,HIGH);//LED will be on

a=1;

}

else if(results.value==0xFF02FD \&a==1) //press again

{

digitalWrite(LED_PIN,LOW);///LED will go off

a=0;

}

irrecv.resume(); // receive the next value

}}//\*\*\*\*\*\*\*\*\*\*\*\*\*\*\*\*\*\*\*\*\*\*\*\*\*\*\*\*\*\*\*\*\*\*\*\*\*\*\*\*\*\*\*\*\*\*\*\*\*\*\*\*\*\*\*

Upload code to development board, press“OK”key on remote control to make LED on
and off.

### Project 7: Bluetooth Remote Control

#### Description：

Bluetooth, a simple wireless communication module most popular since the last
few decades and easy to use are being used in most of the battery-powered
devices.

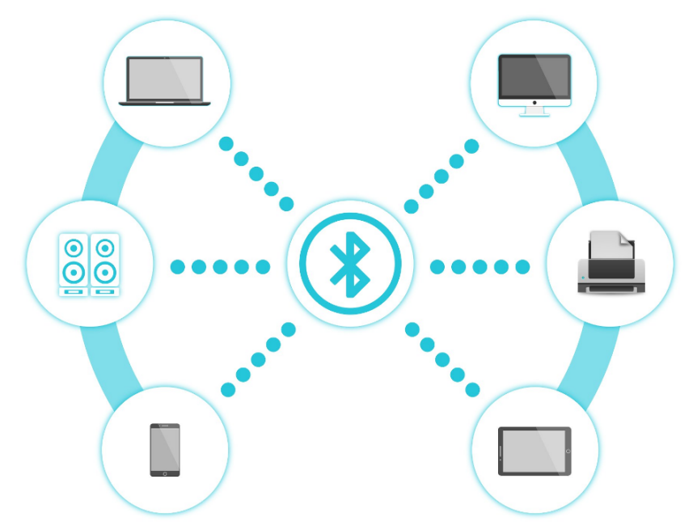
[picture p125: media/3920253c86188ac64cf9b82c0df6c941.png]
Over the years, there have been
many upgrades of Bluetooth standard to keep fulfil the demand of customers and
technology according to the need of time and situation.

Over the few years, there are many things changed including data transmission
rate, power consumption with wearable and IoT Devices and Security System.

Here we are going to learn about HM-10 BLE 4.0 with Arduino Board. The HM-10 is
a readily available Bluetooth 4.0 module. This module is used for establishing
wireless data communication. The module is designed by using the Texas
Instruments CC2540 or CC2541 Bluetooth low energy (BLE) System on Chip (SoC).

#### Specification：

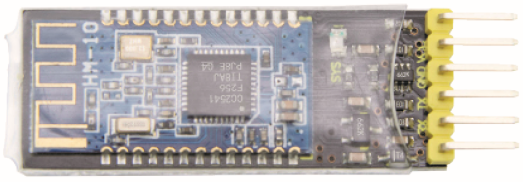
[picture p126: media/698ae05d05c7378653606387991ad1c2.png]
Bluetooth protocol: Bluetooth
Specification V4.0 BLE

No byte limit in serial port Transceiving

In open environment, realize 100m ultra-distance communication with iphone4s

Working frequency: 2.4GHz ISM band

Modulation method: GFSK(Gaussian Frequency Shift Keying)

Transmission power: -23dbm, -6dbm, 0dbm, 6dbm, can be modified by AT command.

Sensitivity: ≤-84dBm at 0.1% BER

Transmission rate: Asynchronous: 6K bytes ; Synchronous: 6k Bytes

Security feature: Authentication and encryption

Supporting service: Central & Peripheral UUID FFE0, FFE1

Power consumption: Auto sleep mode, stand by current 400uA\~800uA, 8.5mA during
transmission.

Power supply: 5V DC

Working temperature: –5 to +65 Centigrade

#### What You Need：

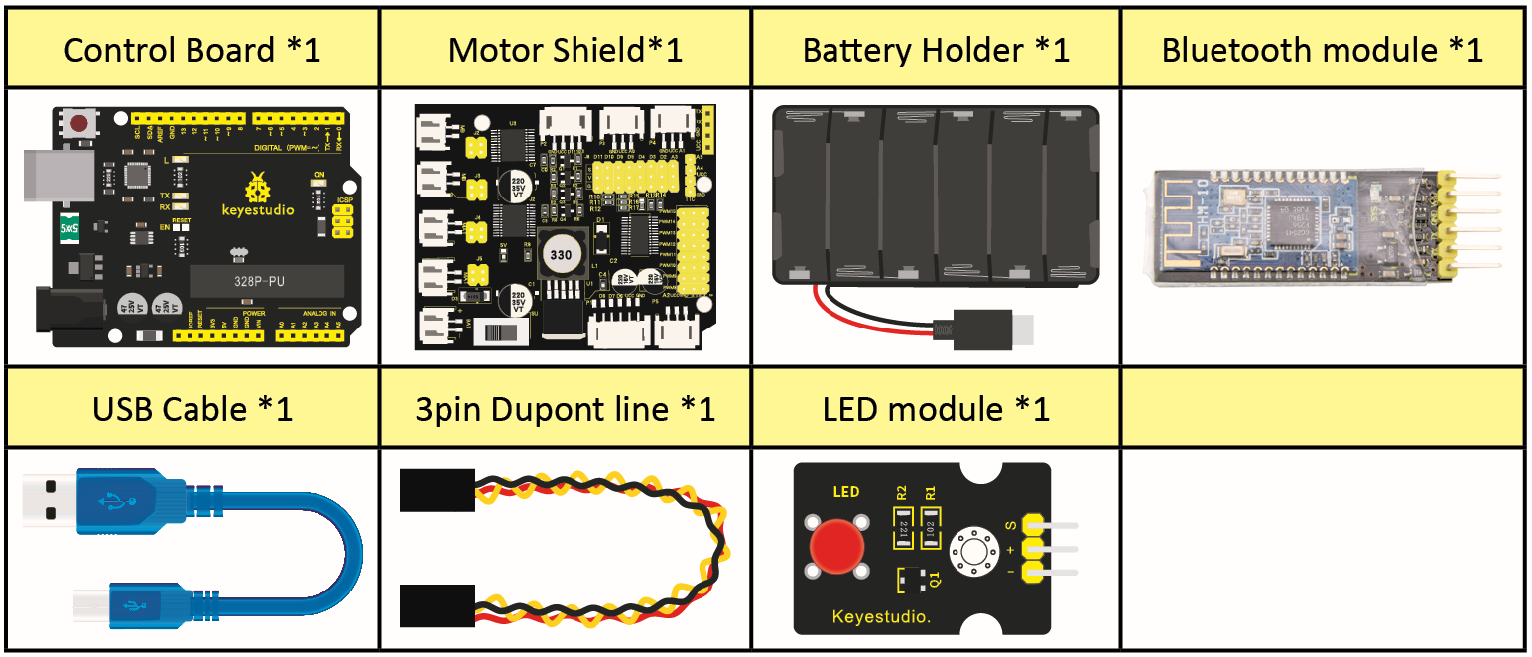
[picture p127: media/ecd25ca20b64550369d8511325e32fa4.png]


#### Wiring Diagram：

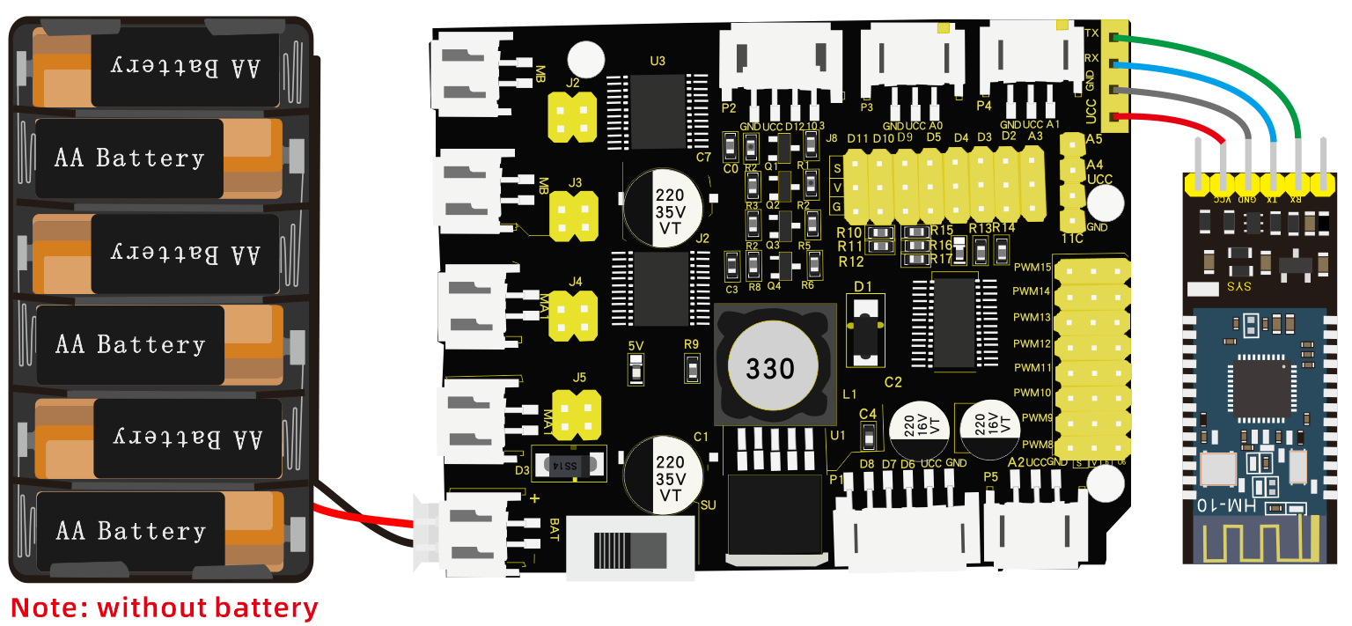
[picture p128: media/3921664bb97a0bb6144fd854c8017146.png]


VCC, GND, TXD and RXD of Bluetooth module are connected to VCC, GND RXD and TXD
of shield.

**Pay attention to the pin direction when inserting Bluetooth module, and don’t
insert it before uploading test code**

#### Test Code：

/\*

keyestudio 4wdRobot Arm Smart Car

lesson 7.1

Bluetooth

http://www.keyestudio.com

\*/

char blue_val; //used to receive the value of Bluetooth

void setup() {

Serial.begin(9600); //set baud rate to 9600

}

void loop() {

if(Serial.available() \> 0) //if the Bluetooth signals are received

{

blue_val = Serial.read(); //receive

Serial.println(blue_val); //Serial port prints Bluetooth value

}

}

//\*\*\*\*\*\*\*\*\*\*\*\*\*\*\*\*\*\*\*\*\*\*\*\*\*\*\*\*\*\*\*\*\*\*\*\*\*\*\*\*\*\*\*\*\*\*\*\*\*\*\*\*\*\*\*\*\*\*\*\*\*\*\*\*\*\*\*\*\*\*

(There will be contradiction between serial communication of code and
communication of Bluetooth when uploading code, therefore, don’t link with
Bluetooth module before uploading code.)

After uploading code on development board, then insert Bluetooth module, wait
for the command from cellphone.

**(6) Download APP**

**Note: Allow APP to access“location” in settings of your cellphone when
connecting to Bluetooth module. Otherwise, Bluetooth may not be connected.**

1.  iOS System

Search keyes bt car in App store, as shown below:

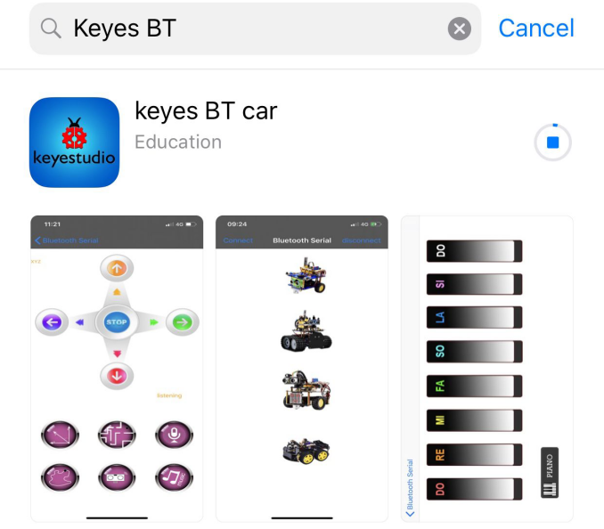
[picture p129: media/aa83a605e983fe3b0a2e6ba5ea93f8fb.png]


After the download, enter the main page, enable the Bluetooth and
click“Connect”to scan Bluetooth. Tap“Connect” when HMSoft appears.

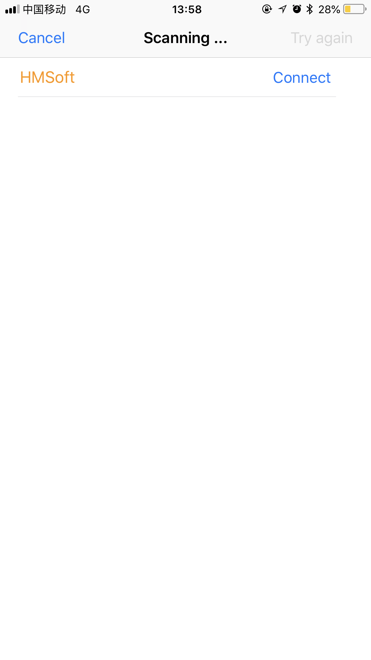
[picture p130: media/25ffad87bf87278f0c12bfb38e071097.png]


Then clickicon

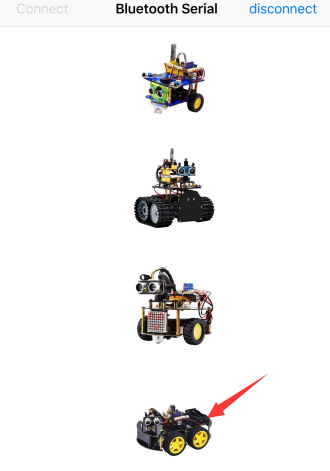
[picture p131: media/0953a75729729255696c269e406658b9.png]


The control page of robot arm car is shown below:

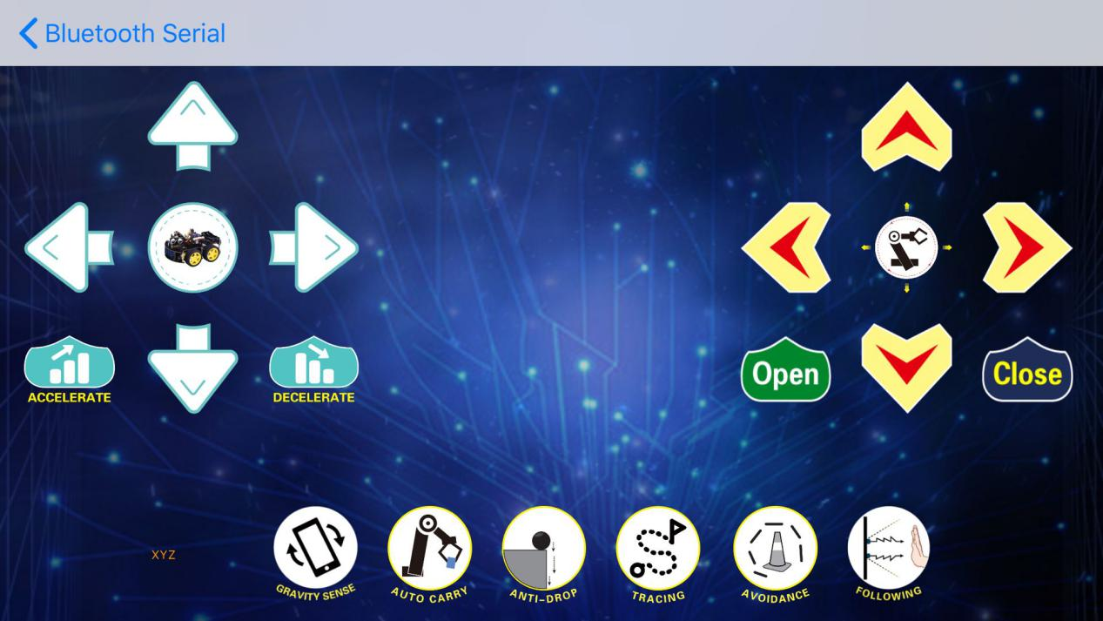
[picture p132: media/133a6114a313d074fc6a768857ea360d.jpeg]


1.  Android System

Search keyes 4wd arm in Google play store and install it.

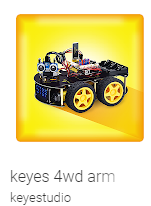
[picture p133: media/822af9d0f4d17137d3f8d86c1a00171b.png]


The interface is shown as below:

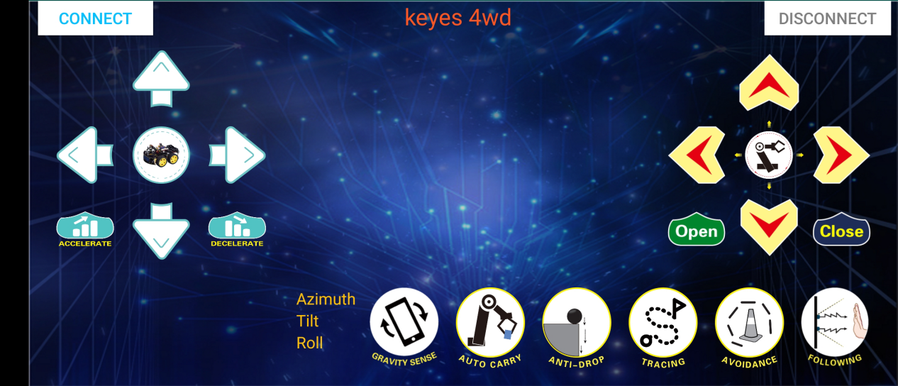
[picture p134: media/64073b8d902758df9bd1bad22249d88b.png]


Turn on Bluetooth, click on
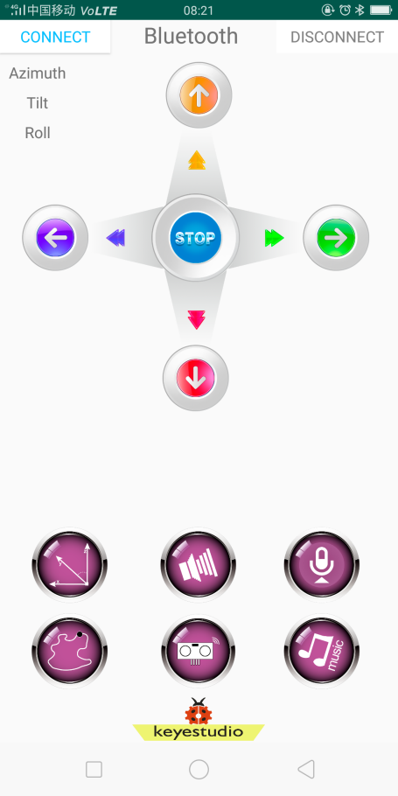
[picture p135: media/1f33d8657fe881d78208e9936f2acc1e.png]
APPicon
and search the Bluetooth.

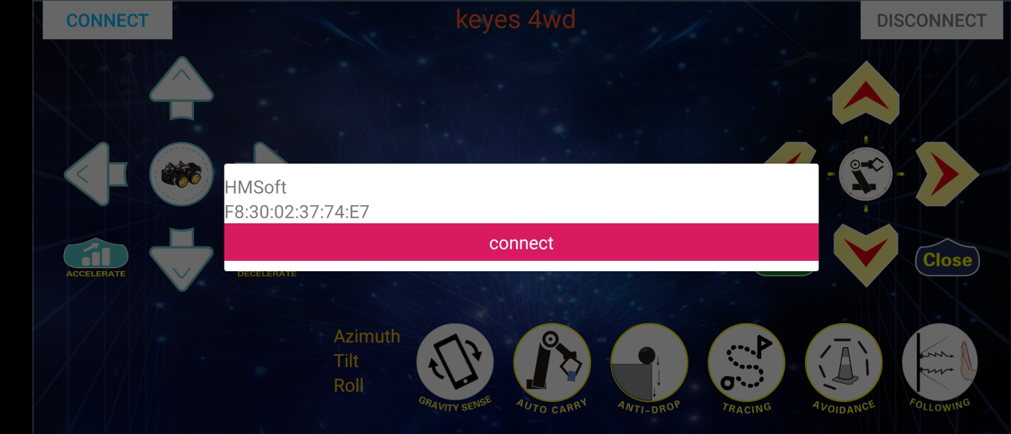
[picture p136: media/891ef58397f0a081fbec07cf58f2d089.png]


Click“connect”if HMSoFT appear, then Bluetooth LED will turn on.

**After the download, and allow APP to access“location”, you could
enable“location”in settings of your cellphone.**

3\. APP Interface

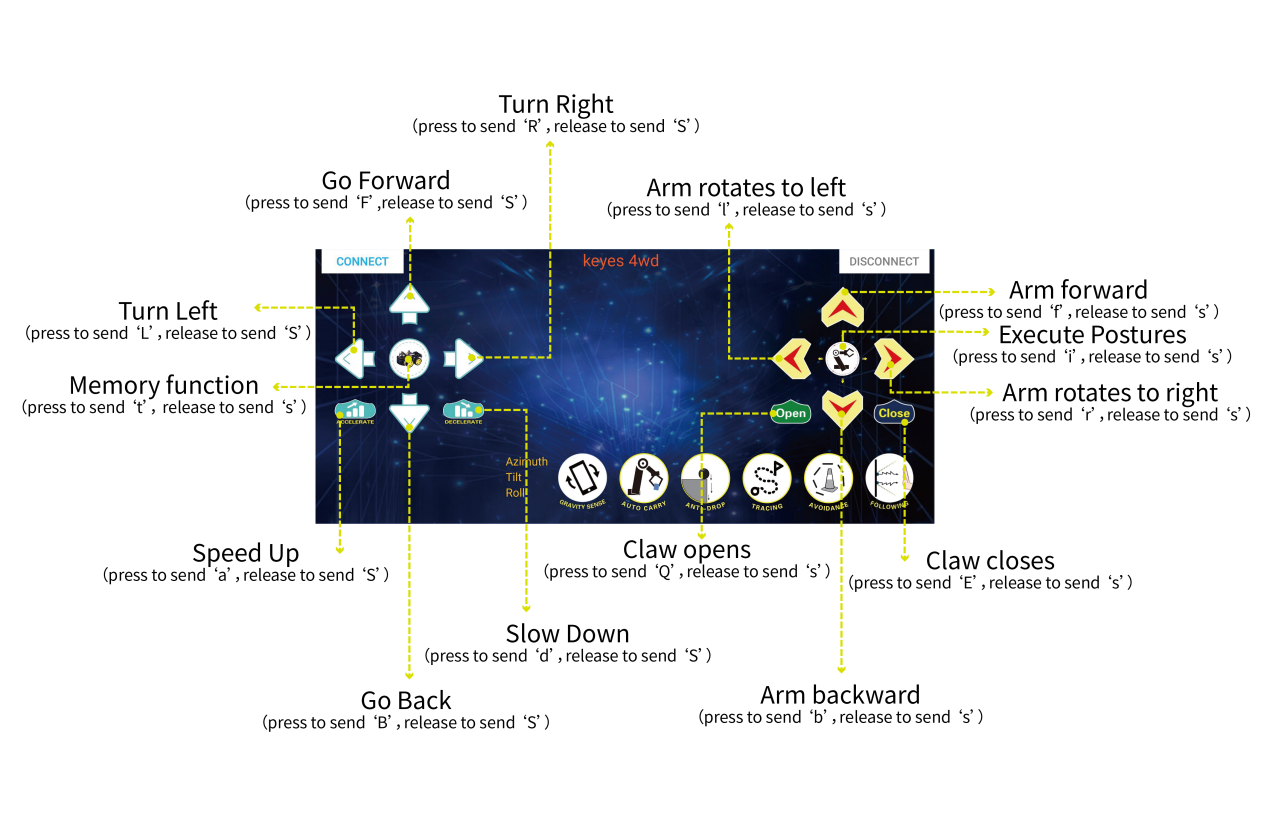
[picture p137: media/799664b865896905499f487aff2e72c5.png]


The function of each key on App is shown below:

| Key | Function | |
|---|---|---|
|  | match with connection HM-10 Bluetooth module | |
|  | disconnect Bluetooth | |
|  | Control character | Function |
| | Press: F Release: S | Press the button, robot car goes front; release to stop |
|  | Press: L Release: S | Press the button, robot car turns left; release to stop |
|  | Press: R Release: S | Press the button, robot car turns right; release to stop |
|  | Press: B Release: S | Press the button, robot car goes back; release to stop |
|  | Press: a Release: S | Press to speed up, release to stop |
|  | Press: d Release: S | Press to slow down；release to stop |
|  | Press: Q Release: s | Press to open claw，release to stop |
|  | Press: E Release: s | Press to close claw, release to stop |
|  | Press: f Release: s | Press to make arm forward, release to stop |
|  | Press:b Release: s | Press to make arm backward，release to stop |
|  | Press: l Release: s | Press to make arm tun left, release to stop |
|  | Press: r Release: s | Press to make arm turn right, release to stop |
|  | Press: t Release: s | Press icon to save the current angle value(record motion) |
|  | Press: i Release: s | Press to execute the saved angle value of servo on loop (execute motion) |
|  | Click to start the mobile gravity sensing; click again to exit | |
|  | Click to send “Y” , then click “S” | Press icon to enter obstacle avoidance function and press again to exit  |
|  | Click to send “U” , then click “S” | Start Ultrasonic follow function; click Stop to exit |
|  | Click to send “G” , then click “S” | Press icon to enable anti-fall function, press again to exit |
|  | Click to send “X” , then click “S” | Press icon to enable line tracking function, press again to end |

**(7) Code Explanation**

**Serial.available()** : The current rest characters when return to buffer area.
Generally, this function is used to judge if there is data in buffer. When
Serial.available()\>0, it means that serial receives the data and can be read

\*\*Serial.read()：\*\*Read a data of a Byte in buffer of serial port, for
instance, device sends data to Arduino via serial port, then we could read data
by “Serial.read()”

#### (8) Extension Practice：

We could send a command via cellphone to turn on and off an LED.

D3 is connected to a LED, as shown below:

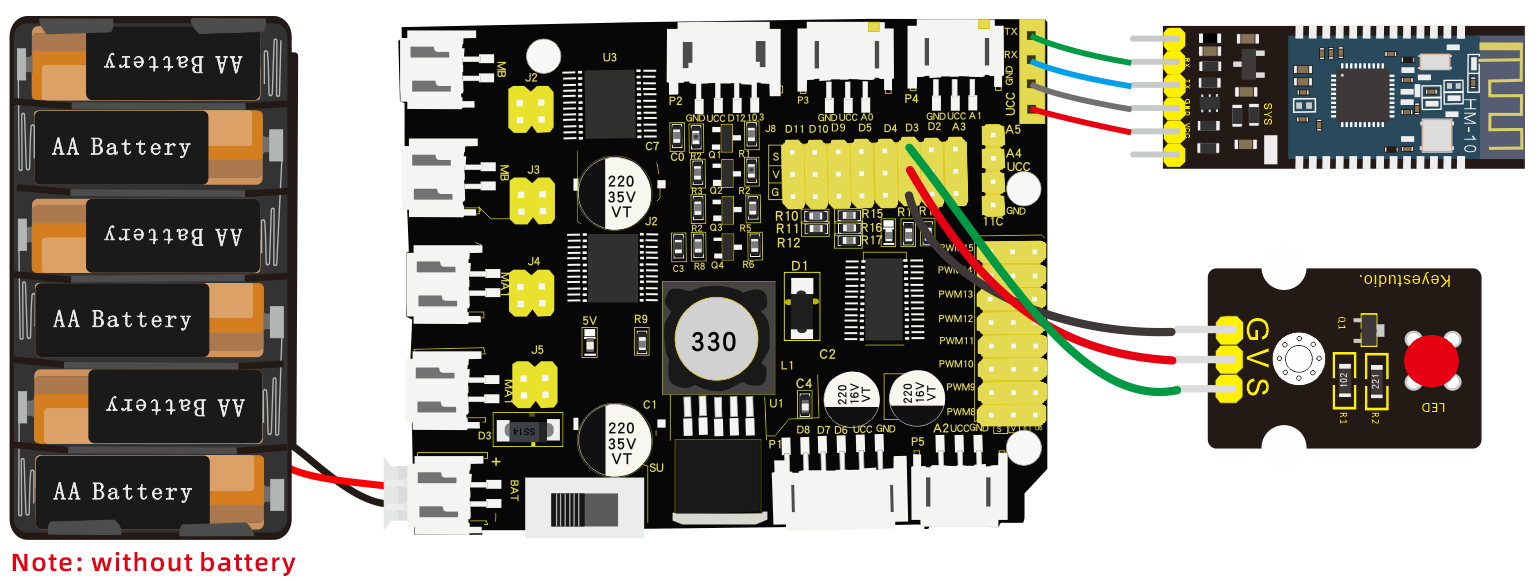
[picture p138: media/0909184a92e2d3f42ad7c308ebde0dc7.png]


/\*

Keyestudio 4WD Robot Arm Smart Car

lesson 7.2

Bluetooth

http://www.keyestudio.com

\*/

int ledpin=3;

void setup()

{

Serial.begin(9600);

pinMode(ledpin,OUTPUT);

}

void loop()

{

int i;

if (Serial.available())

{

i=Serial.read();

Serial.println("DATA RECEIVED:");

if(i=='1')

{

digitalWrite(ledpin,1);

Serial.println("led on");

}

if(i=='0')

{

digitalWrite(ledpin,0);

Serial.println("led off");

}}}

//\*\*\*\*\*\*\*\*\*\*\*\*\*\*\*\*\*\*\*\*\*\*\*\*\*\*\*\*\*\*\*\*\*\*\*\*\*\*\*\*\*\*\*

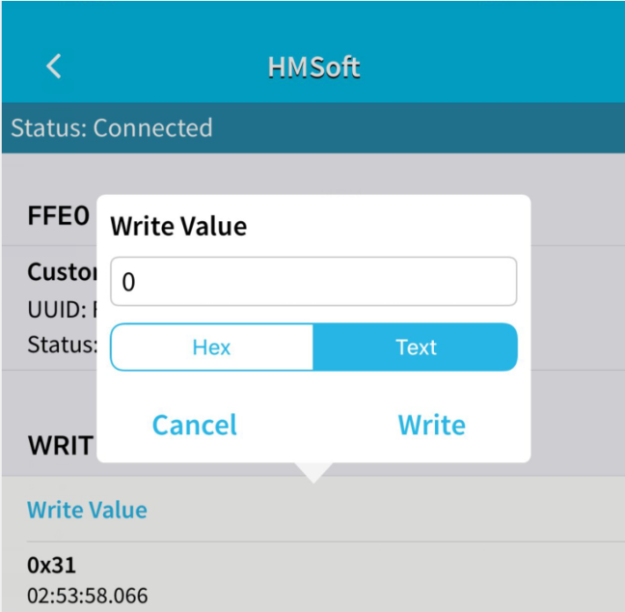
[picture p139: media/87923bf178da692103dcd16dfea953da.png]


Click“Write”on APP. When you enter 1, LED will be on; when you input 0, LED will
be off. (Remember to remove the Bluetooth module after finishing experiment;
otherwise, burning code will be affected)

### Project 8: Motor Driving and Speed Control

#### Description：

Based on the TB6612FNG driver IC design, the motor driver on the expansion board
adopts a special logic control method. Only 4 pins could achieve dual motor
control. Compared with pure chips, it lacks two IO pins and can be applied in
more fields, saving valuable IO resources for Arduino and other controllers.  
TB6612FNG is a dual-channel full-bridge driver chip. The maximum continuous
drive current of a single channel can reach 1.2A, and the peak value is 2A/3.2A
(continuous pulse/single pulse), which can drive some micro DC motors.

1.  **Features for 4WD Motor Driver Board**

1\. Stacked way, easy to build and save space  
2\. The driver board comes with a PCA9685 chip (its IIC address is 0x47) which
can output 8 channel PWM outputs.  
3\. The D11/D10/D9/D5/D4/D3/D2/A3 pins on the control board are expanded into a
3pin header with a pitch of 2.54mm. The 4pin header leads to the I2C
communication interface, and the 4pin female header leads to the serial
communication interface, facilitate to connect the Bluetooth module.  
4\. Expand 3 PH2.0mm-3P, 1 PH2.0mm-4P and 1 PH2.0mm-5P anti-reverse interfaces,
which is convenient for external sensors/modules.  
5\. The power supply IC of the driver board is LM2596S-5.0, with a strong load
capacity, the maximum current can reach 3A, and it can drive multiple steering
gears.  
6.The drive board can drive up to 12V DC motors.

#### (3) Specification：

Working voltage: DC 8-12V  
Drive current: 3A max  
Maximum power: 10W  
Working temperature: -20℃～＋60℃  
White interface type: PH2.0 (-2P -3P -4P -5P)  
Pin header/Female header spacing: 2.54mm  
Size: 68.7mm\*55mm

#### (4) What You Need：

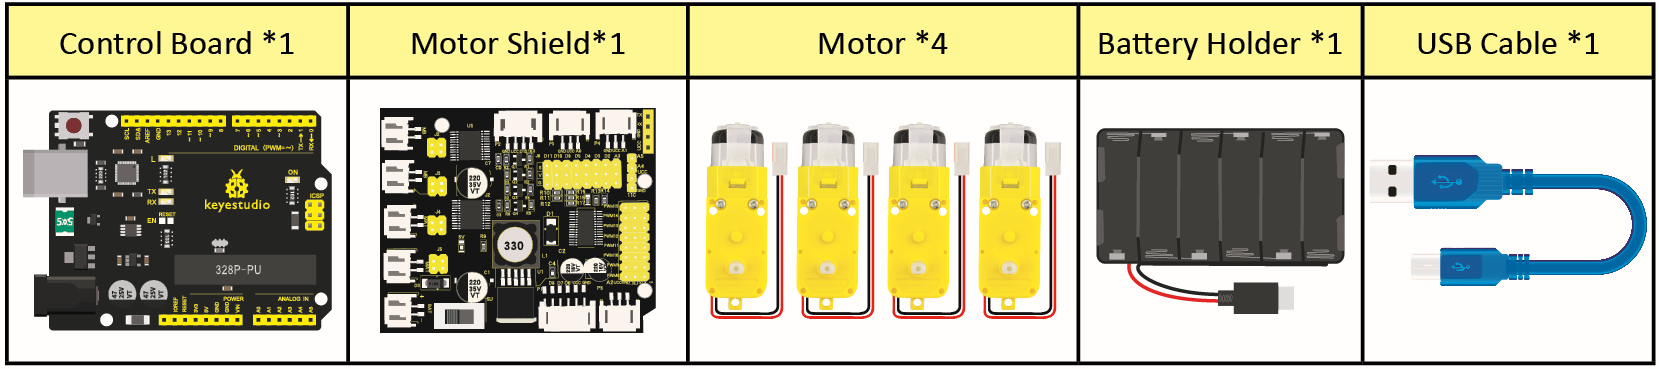
[picture p140: media/769e2feec7c08814680b168bacbfa420.png]


#### (5) Pins of Shield:

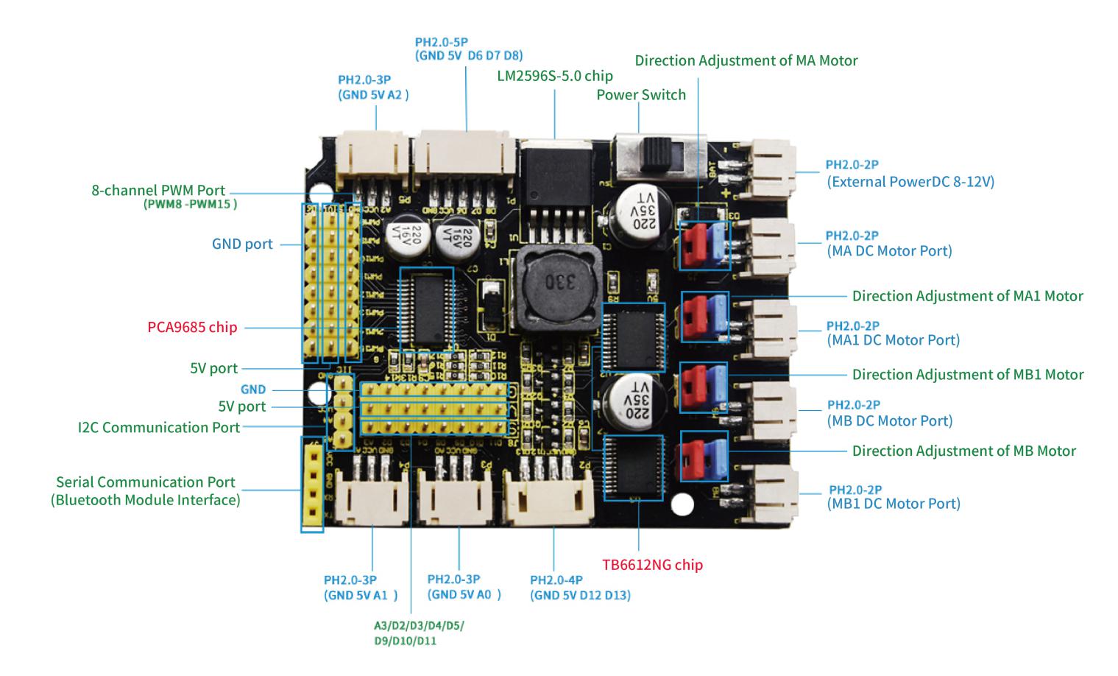
[picture p141: media/3a3a3bed4f0a4fc19309d3c0ebec30a2.jpeg]


The Design of Driving Motor

| Adjust Direction | Adjust Rotation Speed | Status |
|---|---|---|
| pwm.setPWM(0,0,4095) | pwm.setPWM(1,0,1024)  | MB motor rotates clockwise |
| pwm.setPWM(0,0,0) | pwm.setPWM(1,0,2048)  | MB motor rotates anticlockwise |
| pwm.setPWM(2,0,4095) | pwm.setPWM(3,0,1024)  | MB1 motor rotates clockwise |
| pwm.setPWM(2,0,0) | pwm.setPWM(3,0,2048)  | MB1 rotates anticlockwise |
| pwm.setPWM(4,0,4095) | pwm.setPWM(5,0,1024)  | MA1 motor rotates clockwise |
| pwm.setPWM(4,0,0) | pwm.setPWM(5,0,2048)  | MA1 rotates anticlockwise |
| pwm.setPWM(6,0,4095) | pwm.setPWM(7,0,1024)  | MA motor rotates clockwise |
| pwm.setPWM(6,0,0) | pwm.setPWM(7,0,2048)  | MA rotates anticlockwise |

#### (6) Wiring Diagram：

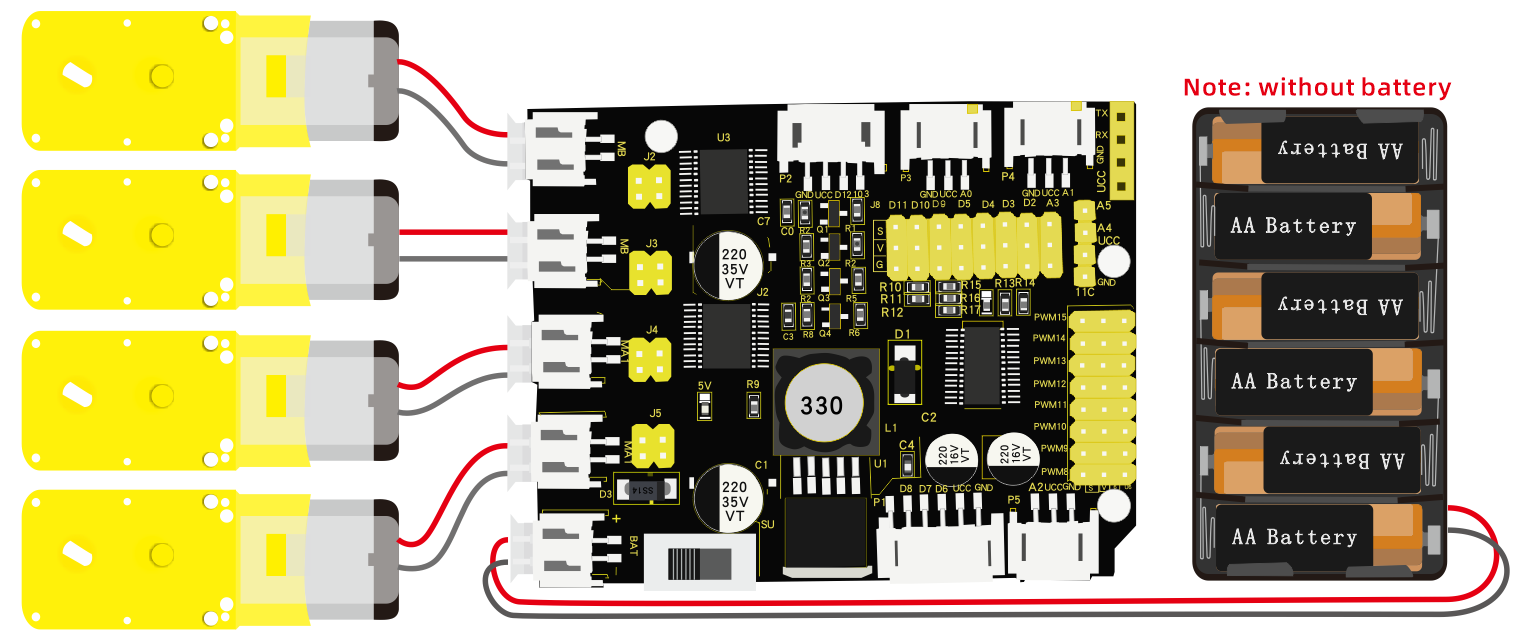
[picture p142: media/c83de8603b2db07b3001d573fe63ffa5.png]


#### (7) Adjust Rotation Direction of Servos

This project is to adjust four motors on smart car so that the direction of
motors is as same as the subsequent lessons. 8 jumper caps on driver board are
used to control the direction of motors. For instance, transform 2 jumper caps
of Ma motor horizontal connection into vertical connection, the rotation
direction of MA will be reverse.

The following code will make smart car go forward. Wiring four motors
differently will cause the different rotation direction of motors, therefore, we
must adjust rotation direction of motors through the direction of jumper caps.

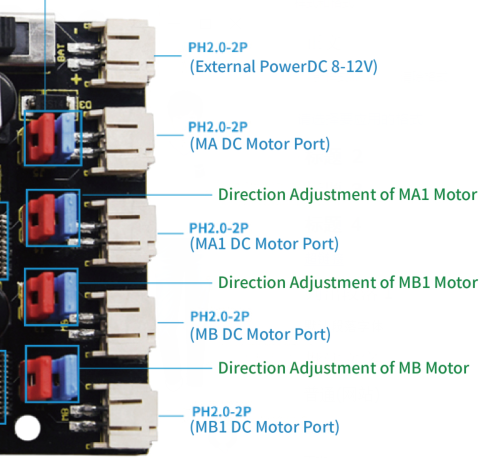
[picture p143: media/97699d446841739d1095d7f79e01b209.png]


**(8) Test Code：**

/\*

keyestudio 4wdRobot Arm Smart Car

lesson 8.0

motor driver shield

http://www.keyestudio.com

\*/

\##include \<Wire.h\>

\##include \<Adafruit_PWMServoDriver.h\>

Adafruit_PWMServoDriver pwm = Adafruit_PWMServoDriver(0x47);

void setup(){

pwm.begin();

pwm.setPWMFreq(60);

}

void loop(){

pwm.setPWM(0,0,4095);

pwm.setPWM(1,0,1000);

pwm.setPWM(2,0,4095);

pwm.setPWM(3,0,1000);

pwm.setPWM(4,0,4095);

pwm.setPWM(5,0,1000);

pwm.setPWM(6,0,4095);

pwm.setPWM(7,0,1000);

}

1.  **Test Result：**

Smart car will go forward, if the motion direction is not stable, please adjust
jumper caps to make smart car move forward

#### Drive Car to Move

**Test Code：**

/\*

keyestudio 4wdRobot Arm Smart Car

lesson 8.1

motor driver shield

http://www.keyestudio.com

\*/

\##include \<Wire.h\>

\##include \<Adafruit_PWMServoDriver.h\>

Adafruit_PWMServoDriver pwm = Adafruit_PWMServoDriver(0x47);

void advance() // going forward

{

pwm.setPWM(0,0,4095);

pwm.setPWM(1,0,1000);

pwm.setPWM(2,0,4095);

pwm.setPWM(3,0,1000);

pwm.setPWM(4,0,4095);

pwm.setPWM(5,0,1000);

pwm.setPWM(6,0,4095);

pwm.setPWM(7,0,1000);

}

void turnR() //turn right

{

pwm.setPWM(0,0,4095);

pwm.setPWM(1,0,2000);

pwm.setPWM(2,0,4095);

pwm.setPWM(3,0,2000);

pwm.setPWM(4,0,0);

pwm.setPWM(5,0,2000);

pwm.setPWM(6,0,0);

pwm.setPWM(7,0,2000);

}

void turnL() //turn left

{

pwm.setPWM(0,0,0);

pwm.setPWM(1,0,1000);

pwm.setPWM(2,0,0);

pwm.setPWM(3,0,1000);

pwm.setPWM(4,0,4095);

pwm.setPWM(5,0,1000);

pwm.setPWM(6,0,4095);

pwm.setPWM(7,0,1000);

}

void stopp() //stop

{

pwm.setPWM(1,0,0);

pwm.setPWM(3,0,0);

pwm.setPWM(5,0,0);

pwm.setPWM(7,0,0);

}

void back() //back

{

pwm.setPWM(0,0,0);

pwm.setPWM(1,0,2000);

pwm.setPWM(2,0,0);

pwm.setPWM(3,0,2000);

pwm.setPWM(4,0,0);

pwm.setPWM(5,0,2000);

pwm.setPWM(6,0,0);

pwm.setPWM(7,0,2000);

}

void setup(){

Serial.begin(9600); //set baud rate to 9600

pwm.begin();

pwm.setPWMFreq(60);

stopp(); //Car stops

}

void loop(){

advance(); //go forward for 1s

delay(1000);

back(); //go back for 1s

delay(1000);

turnL(); //Turn left for 1s

delay(1000);

turnR(); //Turn right for 1s

delay(1000);

}

**Test Result：**

Hook up by connection diagram, upload code and power on. The smart car goes
forward for 1s, back for 1s, turns left for 1s and turns right for 1s.

### Project 9: Anti-fall Design

#### Description：

In previous projects, we’ve introduced the sensors, modules and motor shield.
Next, we will display the function of smart car.

**Flow Chart**

#### Wiring Diagram：

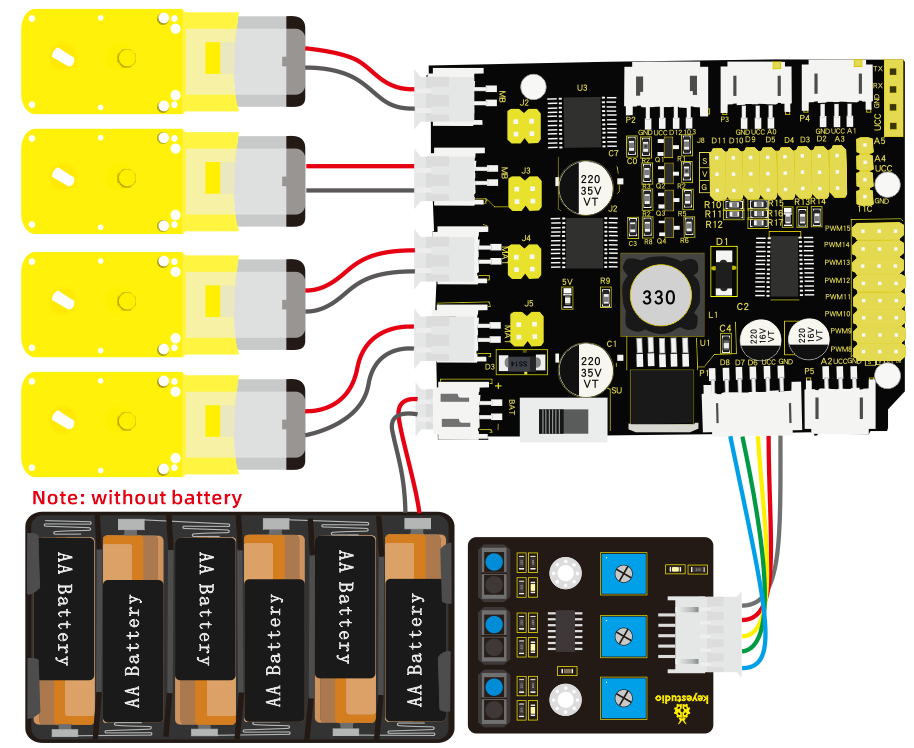
[picture p144: media/5eef155418f56be3291851c3c106616c.png]


#### Test Code：

/\*

keyestudio 4wd Robot Arm Smart Car

lesson 9.1

Prevent falling Robot

http://www.keyestudio.com

\*/

\##include \<Wire.h\>

\##include \<Adafruit_PWMServoDriver.h\>

Adafruit_PWMServoDriver pwm = Adafruit_PWMServoDriver(0x47);

int speeds = 2000; //Initialize speed value

\##define SensorLeft 6 //input pin of left sensor

\##define SensorMiddle 7 //input pin of middle sensor

\##define SensorRight 8 //input pin of right sensor

unsigned char SL; //state of left sensor

unsigned char SM; //state of middle sensor

unsigned char SR; //state of right sensor

void setup() {

Serial.begin(9600); //set baud rate to 9600

pwm.begin();

pwm.setPWMFreq(60);

//set line tracking sensor to input mode

pinMode(SensorLeft, INPUT);

pinMode(SensorMiddle, INPUT);

pinMode(SensorRight, INPUT);

stopp();//Car stops

}

void loop() {

SL = digitalRead(SensorLeft); //read the values of three line tracking sensor

SM = digitalRead(SensorMiddle);

SR = digitalRead(SensorRight);

if (SM == LOW && SL == LOW && SR == LOW) { //if both are low, go forward

advance();

}

else { //otherwise, go back and turn left

back();

delay(500);

turnL();

delay(500);

}

}

void advance() // going forwards

{

pwm.setPWM(0, 0, 4095);

pwm.setPWM(1, 0, speeds);

pwm.setPWM(2, 0, 4095);

pwm.setPWM(3, 0, speeds);

pwm.setPWM(4, 0, 4095);

pwm.setPWM(5, 0, speeds);

pwm.setPWM(6, 0, 4095);

pwm.setPWM(7, 0, speeds);

}

void turnR() // turn right

{

pwm.setPWM(0, 0, 4095);

pwm.setPWM(1, 0, speeds);

pwm.setPWM(2, 0, 4095);

pwm.setPWM(3, 0, speeds);

pwm.setPWM(4, 0, 0);

pwm.setPWM(5, 0, speeds);

pwm.setPWM(6, 0, 0);

pwm.setPWM(7, 0, speeds);

}

void turnL() // turn left

{

pwm.setPWM(0, 0, 0);

pwm.setPWM(1, 0, speeds);

pwm.setPWM(2, 0, 0);

pwm.setPWM(3, 0, speeds);

pwm.setPWM(4, 0, 4095);

pwm.setPWM(5, 0, speeds);

pwm.setPWM(6, 0, 4095);

pwm.setPWM(7, 0, speeds);

}

void stopp() //stop

{

pwm.setPWM(1, 0, 0);

pwm.setPWM(3, 0, 0);

pwm.setPWM(5, 0, 0);

pwm.setPWM(7, 0, 0);

}

void back() //back

{

pwm.setPWM(0, 0, 0);

pwm.setPWM(1, 0, speeds);

pwm.setPWM(2, 0, 0);

pwm.setPWM(3, 0, speeds);

pwm.setPWM(4, 0, 0);

pwm.setPWM(5, 0, speeds);

pwm.setPWM(6, 0, 0);

pwm.setPWM(7, 0, speeds);

}

#### Test Result：

The smart car will go back and turn left once it is close to edge of desk.
What’s more, you could draw a circle to make it move in the circle.

### Project 10: Line Tracking Smart Car

#### Description：

In this part, we will make a line tracking smart car. In the experiment, we will
make car move along the black line.

**Flow Chart**

#### Wiring Diagram：



#### Test Code：

/\*

keyestudio 4wdRobot Arm Smart Car

lesson 10.1

Line Tracking Robot

http://www.keyestudio.com

\*/

\##include \<Wire.h\>

\##include \<Adafruit_PWMServoDriver.h\>

Adafruit_PWMServoDriver pwm = Adafruit_PWMServoDriver(0x47);

int speeds = 2000; //initialize speed value

\##define SensorLeft 6 //input pin of left sensor

\##define SensorMiddle 7 //input pin of middle sensor

\##define SensorRight 8 //input pin of right sensor

unsigned char SL; //state of left sensor

unsigned char SM; //state of middle sensor

unsigned char SR; //state of right sensor

void setup() {

Serial.begin(9600); //set baud rate to 9600

pwm.begin();

pwm.setPWMFreq(60);

pinMode(SensorLeft, INPUT);

pinMode(SensorMiddle, INPUT);

pinMode(SensorRight, INPUT);

stopp();

}

void loop() {

SL = digitalRead(SensorLeft); //set three line tracking sensors to input mode

SM = digitalRead(SensorMiddle);

SR = digitalRead(SensorRight);

if (SM == HIGH) {

if (SL == LOW && SR == HIGH) { // black on right, white on left, turn right

turnR();

}

else if (SR == LOW && SL == HIGH) { // black on left, white on right, turn left

turnL();

}

else { // white on both sides, going forward

advance();

}

}

else {

if (SL == LOW && SR == HIGH) { // black on right, white on left, turn right

turnR();

}

else if (SR == LOW && SL == HIGH) { // white on right, black on left, turn left

turnL();

}

else { // all white, stop

stopp() ;

}

}

}

void advance() // going forwards

{

pwm.setPWM(0, 0, 4095);

pwm.setPWM(1, 0, speeds);

pwm.setPWM(2, 0, 4095);

pwm.setPWM(3, 0, speeds);

pwm.setPWM(4, 0, 4095);

pwm.setPWM(5, 0, speeds);

pwm.setPWM(6, 0, 4095);

pwm.setPWM(7, 0, speeds);

}

void turnR() //turn right

{

pwm.setPWM(0, 0, 4095);

pwm.setPWM(1, 0, speeds);

pwm.setPWM(2, 0, 4095);

pwm.setPWM(3, 0, speeds);

pwm.setPWM(4, 0, 0);

pwm.setPWM(5, 0, speeds);

pwm.setPWM(6, 0, 0);

pwm.setPWM(7, 0, speeds);

}

void turnL() //turn left

{

pwm.setPWM(0, 0, 0);

pwm.setPWM(1, 0, speeds);

pwm.setPWM(2, 0, 0);

pwm.setPWM(3, 0, speeds);

pwm.setPWM(4, 0, 4095);

pwm.setPWM(5, 0, speeds);

pwm.setPWM(6, 0, 4095);

pwm.setPWM(7, 0, speeds);

}

void stopp() //stop

{

pwm.setPWM(1, 0, 0);

pwm.setPWM(3, 0, 0);

pwm.setPWM(5, 0, 0);

pwm.setPWM(7, 0, 0);

}

void back() //back

{

pwm.setPWM(0, 0, 0);

pwm.setPWM(1, 0, speeds);

pwm.setPWM(2, 0, 0);

pwm.setPWM(3, 0, speeds);

pwm.setPWM(4, 0, 0);

pwm.setPWM(5, 0, speeds);

pwm.setPWM(6, 0, 0);

pwm.setPWM(7, 0, speeds);

}

#### Test Result：

Upload code, then the smart car will move along the black line. Yet, it will
stop when no black lines are detected.

### Project 11: Ultrasonic Follow Robot

#### Description：

In this project, we will make robot car demonstrate ultrasonic following effect.
Ultrasonic sensor detects the distance of obstacle and sends data to single-chip
controller, hence the two motors are driven by data.

**Flow Chart**

#### Wiring Diagram：

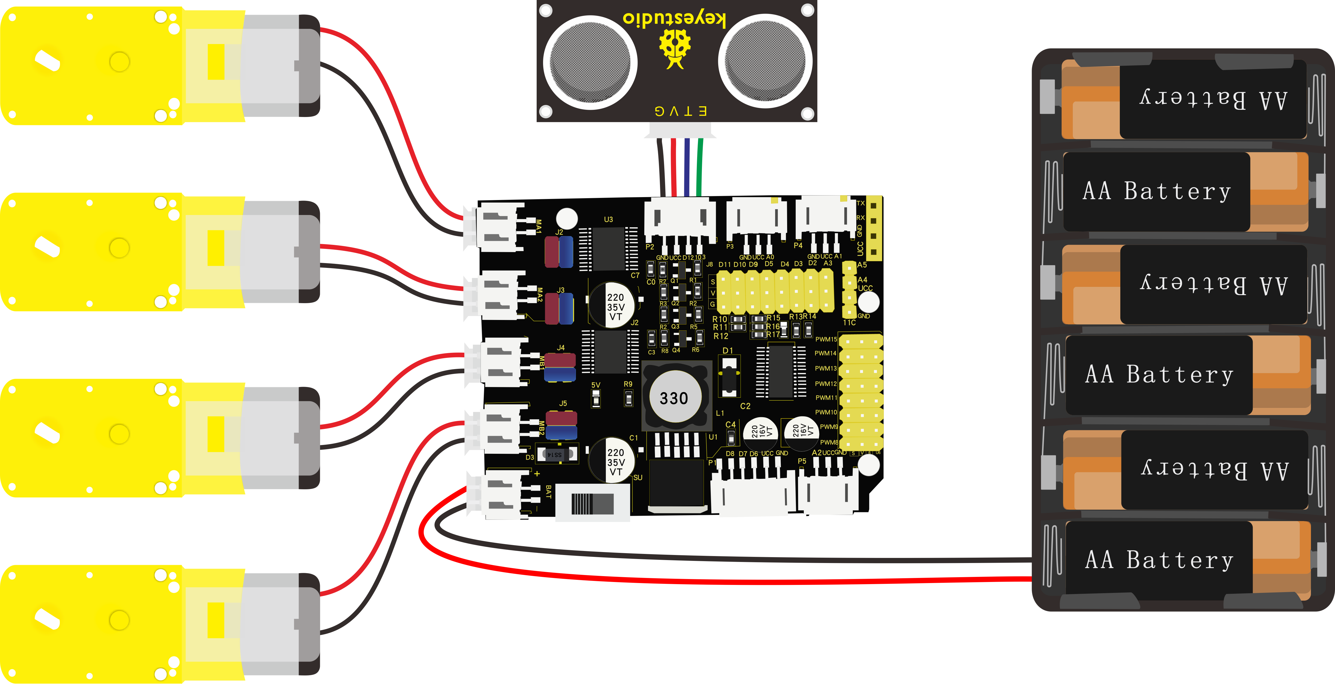
[picture p145: media/b902844f03864af82d75ba72c4e1b3ad.png]


#### Test Code：

/\*

keyestudio 4wdRobot Arm Smart Car

lesson 11.1

Ultrasonic Follow Robot

http://www.keyestudio.com

\*/

\##include \<Wire.h\>

\##include \<Adafruit_PWMServoDriver.h\>

Adafruit_PWMServoDriver pwm = Adafruit_PWMServoDriver(0x47);

int speeds = 2000; //initialize speed value

int echoPin = 13; // ultrasonic module ECHO to D13

int trigPin = 12; // ultrasonic module TRIG to D12

int Ultrasonic_Ranging() {

digitalWrite(trigPin, LOW);

delayMicroseconds(2);

digitalWrite(trigPin, HIGH);

delayMicroseconds(10);

digitalWrite(trigPin, LOW);

int distance = pulseIn(echoPin, HIGH); // reading the duration of high level

distance = distance / 58; // Transform pulse time to distance

delay(50);

return distance;

}

void setup() {

Serial.begin(9600); //set baud rate to 9600

pwm.begin();

pwm.setPWMFreq(60);

stopp();

}

void loop() {

int distance = Ultrasonic_Ranging();

if (distance \< 40) { //assuming the front distance less than 40cm

if (distance \< 20) { //assuming the front distance less than 20cm

if (distance \< 15) {

back();

}

else {

stopp();

}

}

else {

advance();

}

}

else {

stopp();

}

}

void advance() // going forward

{

pwm.setPWM(0, 0, 4095);

pwm.setPWM(1, 0, speeds);

pwm.setPWM(2, 0, 4095);

pwm.setPWM(3, 0, speeds);

pwm.setPWM(4, 0, 4095);

pwm.setPWM(5, 0, speeds);

pwm.setPWM(6, 0, 4095);

pwm.setPWM(7, 0, speeds);

}

void turnR()

{

pwm.setPWM(0, 0, 4095);

pwm.setPWM(1, 0, speeds);

pwm.setPWM(2, 0, 4095);

pwm.setPWM(3, 0, speeds);

pwm.setPWM(4, 0, 0);

pwm.setPWM(5, 0, speeds);

pwm.setPWM(6, 0, 0);

pwm.setPWM(7, 0, speeds);

}

void turnL()

{

pwm.setPWM(0, 0, 0);

pwm.setPWM(1, 0, speeds);

pwm.setPWM(2, 0, 0);

pwm.setPWM(3, 0, speeds);

pwm.setPWM(4, 0, 4095);

pwm.setPWM(5, 0, speeds);

pwm.setPWM(6, 0, 4095);

pwm.setPWM(7, 0, speeds);

}

void stopp() //stop

{

pwm.setPWM(1, 0, 0);

pwm.setPWM(3, 0, 0);

pwm.setPWM(5, 0, 0);

pwm.setPWM(7, 0, 0);

}

void back() //back

{

pwm.setPWM(0, 0, 0);

pwm.setPWM(1, 0, speeds);

pwm.setPWM(2, 0, 0);

pwm.setPWM(3, 0, speeds);

pwm.setPWM(4, 0, 0);

pwm.setPWM(5, 0, speeds);

pwm.setPWM(6, 0, 0);

pwm.setPWM(7, 0, speeds);

}

#### Test Result：

Upload code and turn on the switch. The smart car will follow the obstacle to
move along the straight line, but it is unable to make a turn.

### Project 12: Obstacle Avoidance Smart Car

#### Description：

Flow Chart

#### Wiring Diagram：



#### Test Code：

/\*

keyestudio 4wdRobot Arm Smart Car

lesson 12.1

Ultrasonic avoiding robot

http://www.keyestudio.com

\*/

\##include \<Wire.h\>

\##include \<Adafruit_PWMServoDriver.h\>

Adafruit_PWMServoDriver pwm = Adafruit_PWMServoDriver(0x47);

int speeds = 2000; //initialize speed value

int echoPin = 13; // ultrasonic module ECHO to D13

int trigPin = 12; // ultrasonic module TRIG to D12

int Ultrasonic_Ranging() {

digitalWrite(trigPin, LOW);

delayMicroseconds(2);

digitalWrite(trigPin, HIGH);

delayMicroseconds(10);

digitalWrite(trigPin, LOW);

int distance = pulseIn(echoPin, HIGH); // reading the duration of high level

distance = distance / 58; // Transform pulse time to distance

delay(50);

return distance;

}

void setup() {

Serial.begin(9600); //set baud rate to 9600

pwm.begin();

pwm.setPWMFreq(60);

stopp();

}

void loop() {

int distance = Ultrasonic_Ranging();

Serial.print("distance=");

Serial.println(distance);

if (distance \< 30) { //assuming the front distance less than 30cm

if (distance \< 15) { //assuming the front distance less than 15cm

stopp();

delay(100);

back();

delay(300);

}

else {

stopp();

delay(100);

turnL();

delay(500);

}

}

else {

advance();

}

}

void advance() // go forward

{

pwm.setPWM(0, 0, 4095);

pwm.setPWM(1, 0, speeds);

pwm.setPWM(2, 0, 4095);

pwm.setPWM(3, 0, speeds);

pwm.setPWM(4, 0, 4095);

pwm.setPWM(5, 0, speeds);

pwm.setPWM(6, 0, 4095);

pwm.setPWM(7, 0, speeds);

}

void turnR()

{

pwm.setPWM(0, 0, 4095);

pwm.setPWM(1, 0, speeds);

pwm.setPWM(2, 0, 4095);

pwm.setPWM(3, 0, speeds);

pwm.setPWM(4, 0, 0);

pwm.setPWM(5, 0, speeds);

pwm.setPWM(6, 0, 0);

pwm.setPWM(7, 0, speeds);

}

void turnL()

{

pwm.setPWM(0, 0, 0);

pwm.setPWM(1, 0, speeds);

pwm.setPWM(2, 0, 0);

pwm.setPWM(3, 0, speeds);

pwm.setPWM(4, 0, 4095);

pwm.setPWM(5, 0, speeds);

pwm.setPWM(6, 0, 4095);

pwm.setPWM(7, 0, speeds);

}

void stopp() //stop

{

pwm.setPWM(1, 0, 0);

pwm.setPWM(3, 0, 0);

pwm.setPWM(5, 0, 0);

pwm.setPWM(7, 0, 0);

}

void back() //back

{

pwm.setPWM(0, 0, 0);

pwm.setPWM(1, 0, speeds);

pwm.setPWM(2, 0, 0);

pwm.setPWM(3, 0, speeds);

pwm.setPWM(4, 0, 0);

pwm.setPWM(5, 0, speeds);

pwm.setPWM(6, 0, 0);

pwm.setPWM(7, 0, speeds);

}

#### Test Result：

Upload code and turn on the power switch of smart car. The smart car will avoid
the obstacle detected.

### Project 13: APP Control Smart Car

#### Description：

We’ve gained an insight to the Bluetooth.

In this lesson, we will make a Bluetooth control car which is composed of two
sections---controlling and controlled end. The cellphone is host machine and
HM-10 Bluetooth module is slave machine which is connected to the controlled
end. To control this car, we devised an APP.

**Flow Chart**

#### Wiring Diagram：

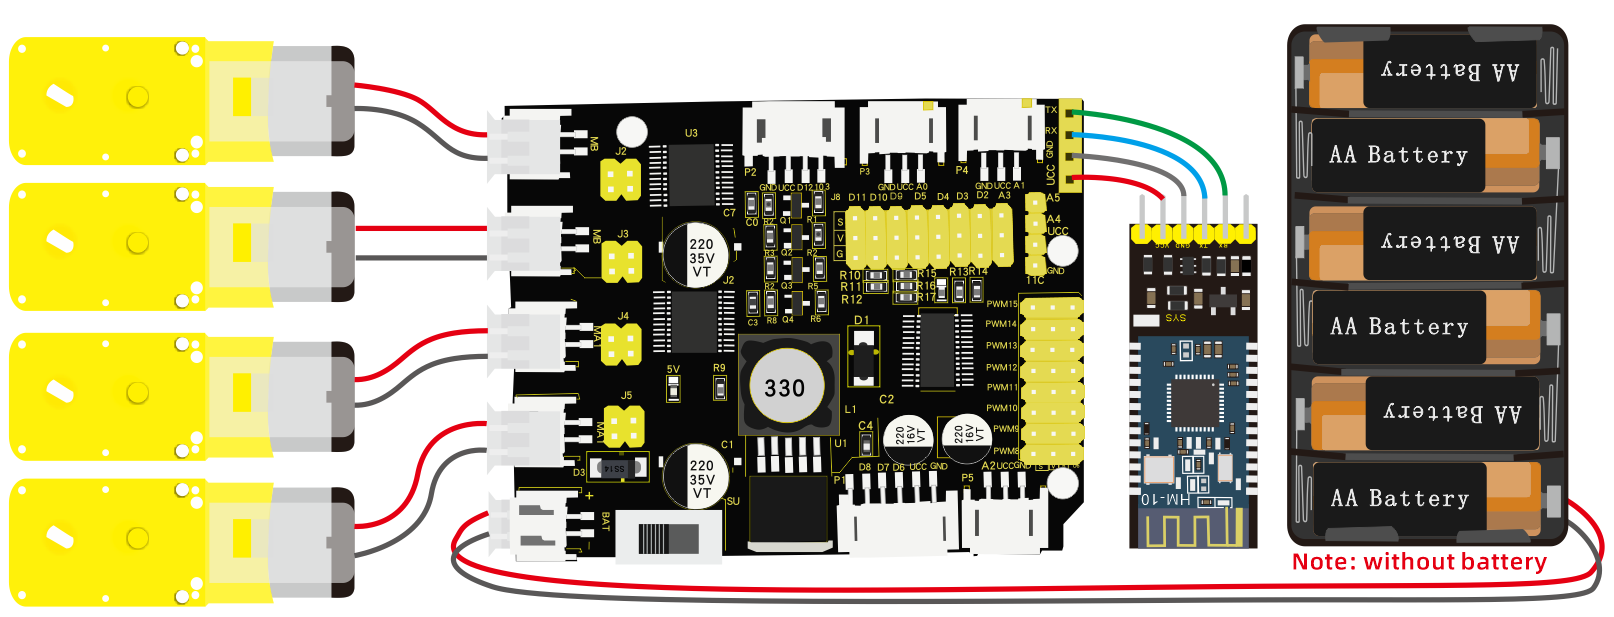
[picture p146: media/b7a070df9c91978354f8cd2802a5ee13.png]


#### Test Code：

/\*

keyestudio 4wdRobot Arm Smart Car

lesson 13.1

Bluetooth Remote Control

http://www.keyestudio.com

\*/

\##include \<Wire.h\>

\##include \<Adafruit_PWMServoDriver.h\>

Adafruit_PWMServoDriver pwm = Adafruit_PWMServoDriver(0x47);

int speeds = 2000; //set initial rotation speed of motor

void setup() {

Serial.begin(9600); //set baud rate to 9600

pwm.begin();

pwm.setPWMFreq(60);

stopp(); //Car stops

}

void loop() {

if (Serial.available() \> 0) {

switch (Serial.read()) {

case 'F': advance(); Serial.println("advance"); break; //receive‘F’, go forward

case 'B': back(); Serial.println("back"); break; //receive‘B’, go back

case 'L': turnL(); Serial.println("turn left"); break;//receive L’，turn left

case 'R': turnR(); Serial.println("turn right"); break;//receive‘R’，turn right

case 'S': stopp(); Serial.println("stop"); break;//receive‘S’，stop

default : break;

}

}

}

void advance() // going forwards

{

pwm.setPWM(0, 0, 4095); //turn clockwise

pwm.setPWM(1, 0, speeds);

pwm.setPWM(2, 0, 4095);

pwm.setPWM(3, 0, speeds);

pwm.setPWM(4, 0, 4095);

pwm.setPWM(5, 0, speeds);

pwm.setPWM(6, 0, 4095);

pwm.setPWM(7, 0, speeds);

}

void turnR() //turn right

{

pwm.setPWM(0, 0, 4095); //turn clockwise

pwm.setPWM(1, 0, speeds);

pwm.setPWM(2, 0, 4095);

pwm.setPWM(3, 0, speeds);

pwm.setPWM(4, 0, 0); //turn anticlockwise

pwm.setPWM(5, 0, speeds);

pwm.setPWM(6, 0, 0);

pwm.setPWM(7, 0, speeds);

}

void turnL() //turn left

{

pwm.setPWM(0, 0, 0); //turn anticlockwise

pwm.setPWM(1, 0, speeds);

pwm.setPWM(2, 0, 0);

pwm.setPWM(3, 0, speeds);

pwm.setPWM(4, 0, 4095); //turn clockwise

pwm.setPWM(5, 0, speeds);

pwm.setPWM(6, 0, 4095);

pwm.setPWM(7, 0, speeds);

}

void stopp() //stop

{

pwm.setPWM(1, 0, 0); // adjust speed to 0

pwm.setPWM(3, 0, 0);

pwm.setPWM(5, 0, 0);

pwm.setPWM(7, 0, 0);

}

void back() //back

{

pwm.setPWM(0, 0, 0); //turn anticlockwise

pwm.setPWM(1, 0, speeds);

pwm.setPWM(2, 0, 0);

pwm.setPWM(3, 0, speeds);

pwm.setPWM(4, 0, 0);

pwm.setPWM(5, 0, speeds);

pwm.setPWM(6, 0, 0);

pwm.setPWM(7, 0, speeds);

}

#### Test Result：

Upload code, insert Bluetooth module and connect App. Press icons on the left to
make the smart car forward, back, turn left and right.

Release icons to stop the smart car.

### Project 14: IR Remote Smart Car

#### (1) Description：

IR remote control is applied widely. In the project 6, we’ve learned its
principle and tested keys values. In this project, we put these key values in
the code to control robot arm car to move.

#### (2) Wiring Diagram：

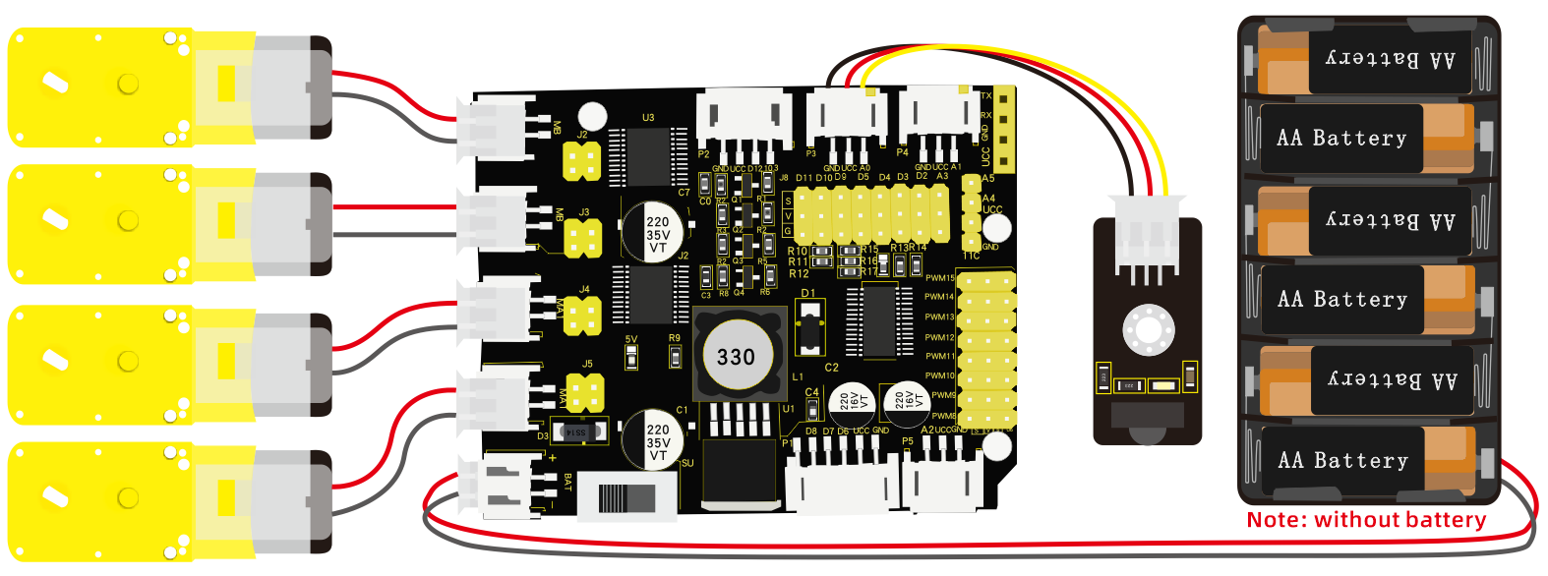
[picture p147: media/c0c169fba11aebd90393850fb10c85f6.png]


#### Test Code：

/\*

keyestudio 4WD Robot Arm Smart Car

lesson 14.1

remote control robot

http://www.keyestudio.com

\*/

\##include \<Wire.h\>

\##include \<Adafruit_PWMServoDriver.h\>

Adafruit_PWMServoDriver pwm = Adafruit_PWMServoDriver(0x47);

\##include \<IRremote.h\>

int RECV_PIN = A0;

int speeds = 2000; //Initialize speed value

IRrecv irrecv(RECV_PIN);

decode_results results;

\##define IR_Go 0x00ff629d

\##define IR_Back 0x00ffa857

\##define IR_Left 0x00ff22dd

\##define IR_Right 0x00ffc23d

\##define IR_Stop 0x00ff02fd

void setup() {

Serial.begin(9600); //set baud rate to 9600

pwm.begin();

pwm.setPWMFreq(60);

irrecv.enableIRIn(); // enable IR receiver

stopp();

}

void loop() {

if (irrecv.decode(&results)) {

switch (results.value)

{

case IR_Go: advance(); //UP

break;

case IR_Back: back(); //back

break;

case IR_Left: turnL(); //Left

break;

case IR_Right: turnR(); //Righ

break;

case IR_Stop: stopp(); //stop

break;

default: break;

}

irrecv.resume();

}

}

void advance() // going forward

{

pwm.setPWM(0, 0, 4095);

pwm.setPWM(1, 0, speeds);

pwm.setPWM(2, 0, 4095);

pwm.setPWM(3, 0, speeds);

pwm.setPWM(4, 0, 4095);

pwm.setPWM(5, 0, speeds);

pwm.setPWM(6, 0, 4095);

pwm.setPWM(7, 0, speeds);

}

void turnR()

{

pwm.setPWM(0, 0, 4095);

pwm.setPWM(1, 0, speeds);

pwm.setPWM(2, 0, 4095);

pwm.setPWM(3, 0, speeds);

pwm.setPWM(4, 0, 0);

pwm.setPWM(5, 0, speeds);

pwm.setPWM(6, 0, 0);

pwm.setPWM(7, 0, speeds);

}

void turnL()

{

pwm.setPWM(0, 0, 0);

pwm.setPWM(1, 0, speeds);

pwm.setPWM(2, 0, 0);

pwm.setPWM(3, 0, speeds);

pwm.setPWM(4, 0, 4095);

pwm.setPWM(5, 0, speeds);

pwm.setPWM(6, 0, 4095);

pwm.setPWM(7, 0, speeds);

}

void stopp() //stop

{

pwm.setPWM(1, 0, 0);

pwm.setPWM(3, 0, 0);

pwm.setPWM(5, 0, 0);

pwm.setPWM(7, 0, 0);

}

void back() //back

{

pwm.setPWM(0, 0, 0);

pwm.setPWM(1, 0, speeds);

pwm.setPWM(2, 0, 0);

pwm.setPWM(3, 0, speeds);

pwm.setPWM(4, 0, 0);

pwm.setPWM(5, 0, speeds);

pwm.setPWM(6, 0, 0);

pwm.setPWM(7, 0, speeds);

}

#### Test Result：

Upload code and press the keys on IR remote control to drive smart car forward
and back, left and right turning and stop

### Project 15: Speed Control Smart Car

#### Description：

We send commands to modulate the PWM values through app, so as to speed of car.

#### Flow Chart:

#### Wiring Diagram：

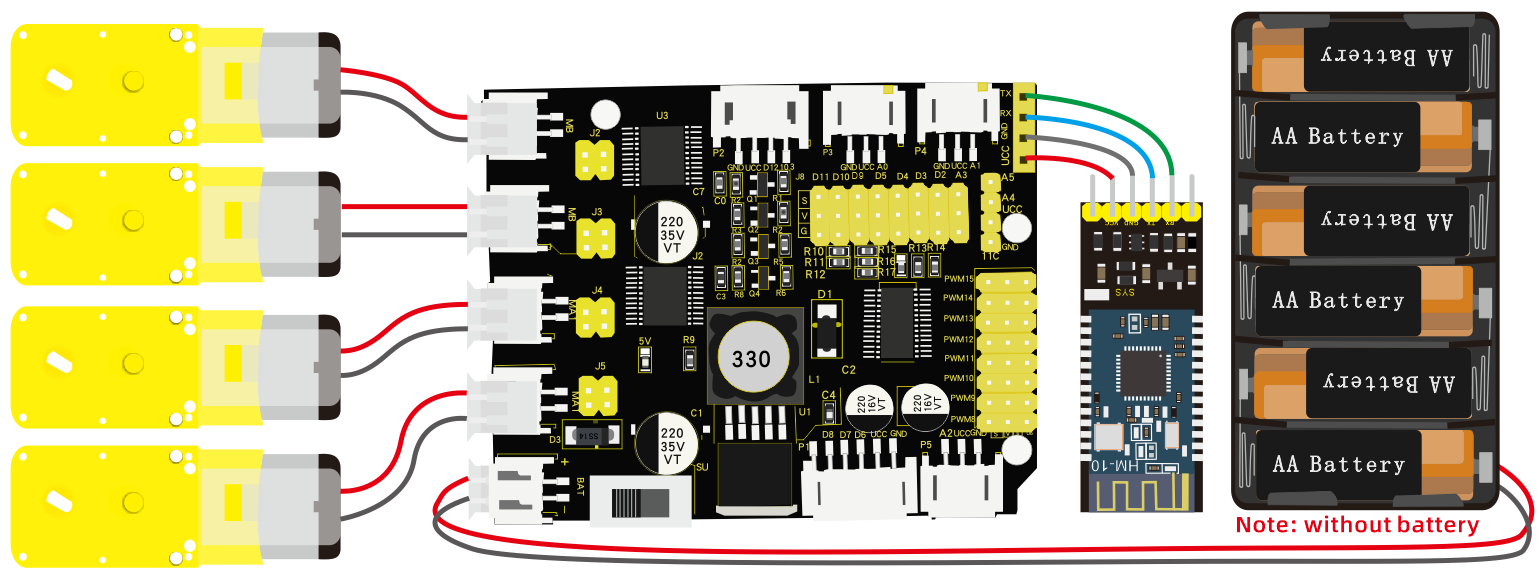
[picture p148: media/1fa65792345251f13240a7158ad8e6a7.png]


#### Test Code：

/\*

keyestudio 4wdRobot Arm Smart Car

lesson 15.1

Speed control robot

http://www.keyestudio.com

\*/

\##include \<Wire.h\>

\##include \<Adafruit_PWMServoDriver.h\>

Adafruit_PWMServoDriver pwm = Adafruit_PWMServoDriver(0x47);

int speeds = 2000; //set initial rotation speed of motor

void setup() {

Serial.begin(9600); //set baud rate to 9600

pwm.begin();

pwm.setPWMFreq(60);

stopp(); //Car stops

}

void loop() {

if (Serial.available() \> 0) {

switch (Serial.read()) {

case 'F': advance(); Serial.println("advance"); break;

case 'B': back(); Serial.println("back"); break;

case 'L': turnL(); Serial.println("left"); break;

case 'R': turnR(); Serial.println("right"); break;

case 'S': stopp(); Serial.println("stop"); break;

case 'd': while ('d') { //receive‘d’, motor slows down

Serial.println(speeds);

if (speeds \>= 5)speeds -= 5; //slow down by 5, minimum to 0

if (Serial.read() == 'S') {

Serial.println(speeds);

break;

}

} break;

case 'a': while ('a') { //receive‘a’, motor speeds up

Serial.println(speeds);

if (speeds \<= 2555)speeds += 5; //speed up by 5, and up to 2560

if (Serial.read() == 'S') {

Serial.println(speeds);

break;

}

} break;

}

}

}

void advance() // going forward

{

pwm.setPWM(0, 0, 4095); //turn clockwise

pwm.setPWM(1, 0, speeds);

pwm.setPWM(2, 0, 4095);

pwm.setPWM(3, 0, speeds);

pwm.setPWM(4, 0, 4095);

pwm.setPWM(5, 0, speeds);

pwm.setPWM(6, 0, 4095);

pwm.setPWM(7, 0, speeds);

}

void turnR() //turn right

{

pwm.setPWM(0, 0, 4095); //turn clockwise

pwm.setPWM(1, 0, speeds);

pwm.setPWM(2, 0, 4095);

pwm.setPWM(3, 0, speeds);

pwm.setPWM(4, 0, 0); //turn anticlockwise

pwm.setPWM(5, 0, speeds);

pwm.setPWM(6, 0, 0);

pwm.setPWM(7, 0, speeds);

}

void turnL() //turn left

{

pwm.setPWM(0, 0, 0); //turn anticlockwise

pwm.setPWM(1, 0, speeds);

pwm.setPWM(2, 0, 0);

pwm.setPWM(3, 0, speeds);

pwm.setPWM(4, 0, 4095); //turn clockwise

pwm.setPWM(5, 0, speeds);

pwm.setPWM(6, 0, 4095);

pwm.setPWM(7, 0, speeds);

}

void stopp() //stop

{

pwm.setPWM(1, 0, 0); //adjust speed as 0

pwm.setPWM(3, 0, 0);

pwm.setPWM(5, 0, 0);

pwm.setPWM(7, 0, 0);

}

void back() //back

{

pwm.setPWM(0, 0, 0); //turn anticlockwise

pwm.setPWM(1, 0, speeds);

pwm.setPWM(2, 0, 0);

pwm.setPWM(3, 0, speeds);

pwm.setPWM(4, 0, 0);

pwm.setPWM(5, 0, speeds);

pwm.setPWM(6, 0, 0);

pwm.setPWM(7, 0, speeds);

}

#### Test Result：

Upload code and connect App. When the icon
is pressed, the smart car will
speed up to maximum value; if the
iconis pressed, it will slow down
and to 0.

### Project 16: Bluetooth Control

#### Description：

In this project, we will combine robot arm and Bluetooth control, in other
words, the smart car will be controlled via Bluetooth control.

**Flow Chart**

#### Wiring Diagram：

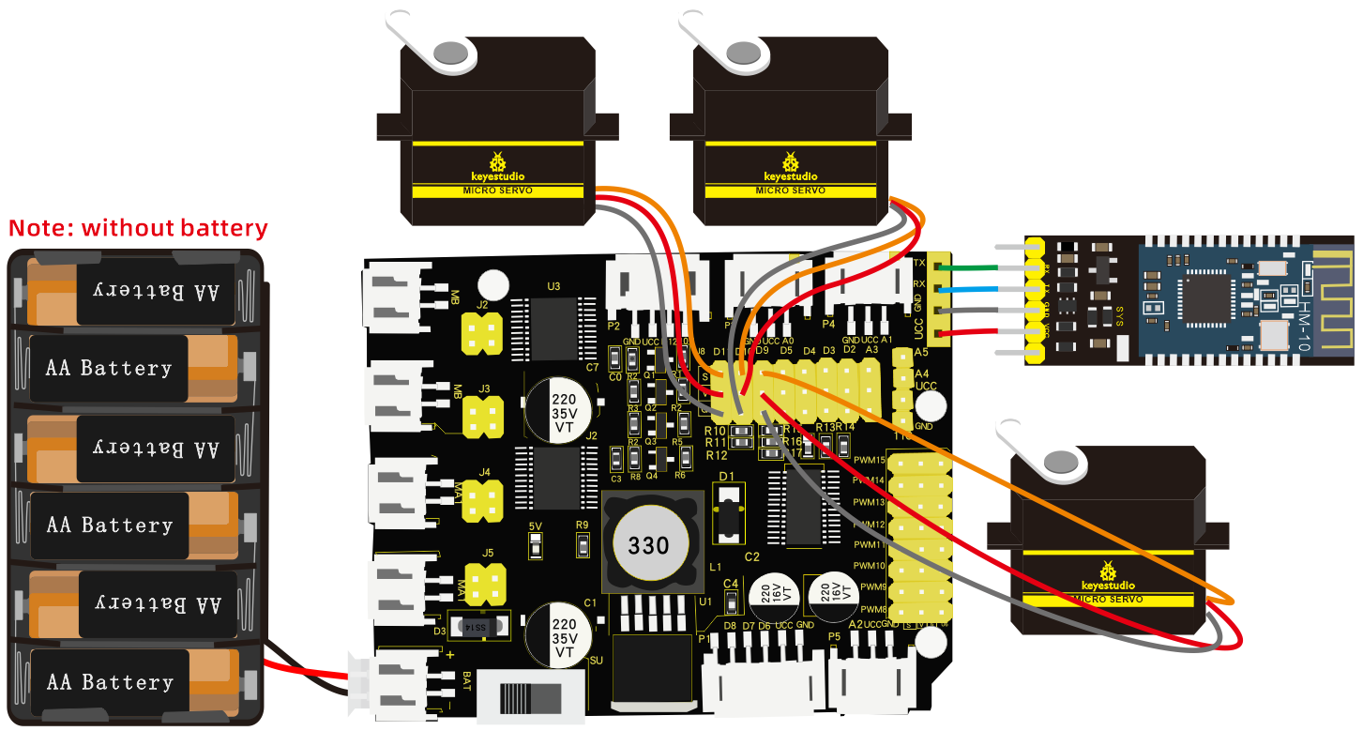
[picture p149: media/ad77442634a5a69983e140b7d69a0fd1.png]


#### Test Code：

/\*

keyestudio 4wd Robot Arm Smart Car

lesson 16.1

Robotic arm robot

http://www.keyestudio.com

\*/

\##include \<Servo.h\>

Servo myservo1;

Servo myservo2;

Servo myservo3;

int k1=80,k2=120,k3=90; //initialize the angle value of servo 3

void servo1on(){

myservo1.write(k1);//rotate to K1

k1-=1;

delay(5);

if(k1\<20)k1=20;//rotate to least 20°

}

void servo1off(){

myservo1.write(k1);//rotate to K1

k1+=1;

delay(5);

if(k1\>80)k1=80;// rotate up to 80°

}

void servo2up(){

myservo2.write(k2);//rotate to K2

k2+=1;

delay(10);

if(k2\>120)k2=120;//rotate up to 120°

}

void servo2down(){

myservo2.write(k2);//rotate to K2

k2-=1;

delay(10);

if(k2\<10)k2=10;//rotate to least 10°

}

void servo3left(){

myservo3.write(k3);//rotate to K3

k3+=1;

delay(10);

if(k3\>180)k3=180;//rotate up to 180°

}

void servo3right(){

myservo3.write(k3);//rotate to K3

k3-=1;

delay(10);

if(k3\<1)k3=0;//rotate to least 0°

}

void setup(){

Serial.begin(9600); //set baud rate to 9600

myservo1.attach(11);

myservo2.attach(10);

myservo3.attach(9);

myservo1.write(k1);

delay(1000);

myservo2.write(k2);

delay(1000);

myservo3.write(k3);

delay(1000);

}

void loop(){

if(Serial.available()\>0){ //receive Bluetooth signals

switch(Serial.read()){

case 'f':while('f'){ //arm lifts up

servo2up();

if(Serial.read()=='s')break;

}break;

case 'b':while('b'){ //arm lowers

servo2down();

if(Serial.read()=='s')break;

}break;

case 'l':while('l'){ //arm turns left

servo3left();

if(Serial.read()=='s')break;

}break;

case 'r':while('r'){ //arm turns right

servo3right();

if(Serial.read()=='s')break;

}break;

case 'Q':while('Q'){ //claw opens

servo1on();

if(Serial.read()=='s')break;

}break;

case 'E':while('E'){ //claw closes

servo1off();

if(Serial.read()=='s')break;

}break;

}

}

}

#### Test Result：

Press the icons on App and check different movements of robot arm.

| Icon | Signal | Function |
|---|---|---|
|  | ‘f’ | Arm is lifted |
|  | ‘b’ | lower |
|  | ‘l’ | Turn left |
|  | ‘r’ | Turn right |
|  | ‘Q’ | Claw opens |
|  | ‘E’ | Claw closes |

### Project 17: APP Memory Carry

#### Description：

The memory function is one of characteristics of robot arm, which records and
programs the frequency, time and amplitude of motion. In this project, we will
execute memory function with keys on App.

**Flow Chart**

#### Wiring Diagram：



#### Test Code：

/\*

keyestudio 4wdRobot Arm Smart Car

lesson 17.1

Memory handling robot

http://www.keyestudio.com

\*/

\##include \<Servo.h\>

Servo myservo1; //define the servo of claw

Servo myservo2; //define the servo 2

Servo myservo3; //define the servo of base

int k1=80,k2=120,k3=90; //initialize angle value of servo 3

int M1[20],M2[20],M3[20]; //used to save the read angle value

int i=0,j=0,t=0; //i is used to save array, j is for saving the maximum value, t
is for while loop

void servo1on(){ //claw opens

myservo1.write(k1);//use Pulse function

k1-=1;

delay(5);

if(k1\<20)k1=20;

}

void servo1off(){ //claw closes

myservo1.write(k1);//use Pulse function

k1+=1;

delay(5);

if(k1\>80)k1=80;

}

void servo2up(){

myservo2.write(k2);//use Pulse function

k2+=1;

delay(10);

if(k2\>120)k2=120;

}

void servo2down(){

myservo2.write(k2);//use Pulse function

k2-=1;

delay(10);

if(k2\<10)k2=10;

}

void servo3left(){

myservo3.write(k3);//use Pulse function

k3+=1;

delay(10);

if(k3\>180)k3=180;

}

void servo3right(){

myservo3.write(k3);//use Pulse function

k3-=1;

delay(10);

if(k3\<1)k3=0;

}

void setup(){

Serial.begin(9600); //set baud rate to 9600

myservo1.attach(11);

myservo2.attach(10);

myservo3.attach(9);

myservo1.write(k1);

delay(1000);

myservo2.write(k2);

delay(1000);

myservo3.write(k3);

delay(1000);

}

void loop(){

if(Serial.available()\>0){ //receive the Bluetooth signals

switch(Serial.read()){

case 'f':while('f'){ //robot arm lifts up

servo2up();

if(Serial.read()=='s')break;

}break;

case 'b':while('b'){ //robot arm lowers

servo2down();

if(Serial.read()=='s')break;

}break;

case 'l':while('l'){ // robot arm turns left

servo3left();

if(Serial.read()=='s')break;

}break;

case 'r':while('r'){ //robot arm turns right

servo3right();

if(Serial.read()=='s')break;

}break;

case 'Q':while('Q'){ //claw opens

servo1on();

if(Serial.read()=='s')break;

}break;

case 'E':while('E'){ //claw closes

servo1off();

if(Serial.read()=='s')break;

}break;

case 't':{M1[i]=myservo1.read(); //save the angle value of servos in array

delay(100);

M2[i]=myservo2.read();

delay(100);

M3[i]=myservo3.read();

delay(100);

i++; //i adds 1

j=i; // set the value of i to j

delay(200);

}break;

case 'i':{i=0; //i clears 0

t=1; //enter while loop

k1=myservo1.read(); //read the angle value and set them to k

k2=myservo2.read();

k3=myservo3.read();

while(t){

for(int k=0;k\<j;k++){ //loop j times

if(k1\<M1[k]){ //if the current angle value of servo 1 is less than the value of
array 1

while(k1\<M1[k]){ //while loops and make servo rotate the location where the
array is saved

myservo1.write(k1); //servo 1executes actions

k1++; // K1 adds 1

delay(10); //delay in 10ms, control the rotation speed of servo

}

}

else{ //when angle value of servo 1 is more than the value saved in array 1

while(k1\>M1[k]){ //while loops， make servo rotate the location where the value
is saved in array

myservo1.write(k1); //servo 1 executes motion

k1--; //k1 reduces 1

delay(10); //delay in 10ms，control the rotation speed of servo

}

}

//the same below

if(k2\<M2[k]){

while(k2\<M2[k]){

myservo2.write(k2);

k2++;

delay(10);

}

}

else{

while(k2\>M2[k]){

myservo2.write(k2);

k2--;

delay(10);

}

}

if(k3\<M3[k]){

while(k3\<M3[k]){

myservo3.write(k3);

k3++;

delay(10);

}

}

else{

while(k3\>M3[k]){

myservo3.write(k3);

k3--;

delay(10);

}

}

}

if(Serial.read()=='t'){ //exit while loop

t=0;

break;

}

}

}break;

}

}

}

#### Test Result：

Upload code and connect App, press icon
to save the angle valued of
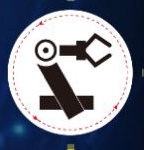
[picture p150: media/15bf4a9843e248c01880d071124ca433.png]
servos, and tapto execute the
saved value in loop way.

### Project 18: Robot Arm Control Smart Car

#### (1) Description：

From now, we’ve known multiple functions of smart car and mechanical arm. In
fact, we could combine them together.

Apply the following code, we could make the arm car demonstrate functions.

#### (2) Flow Chart

#### Wiring Diagram：

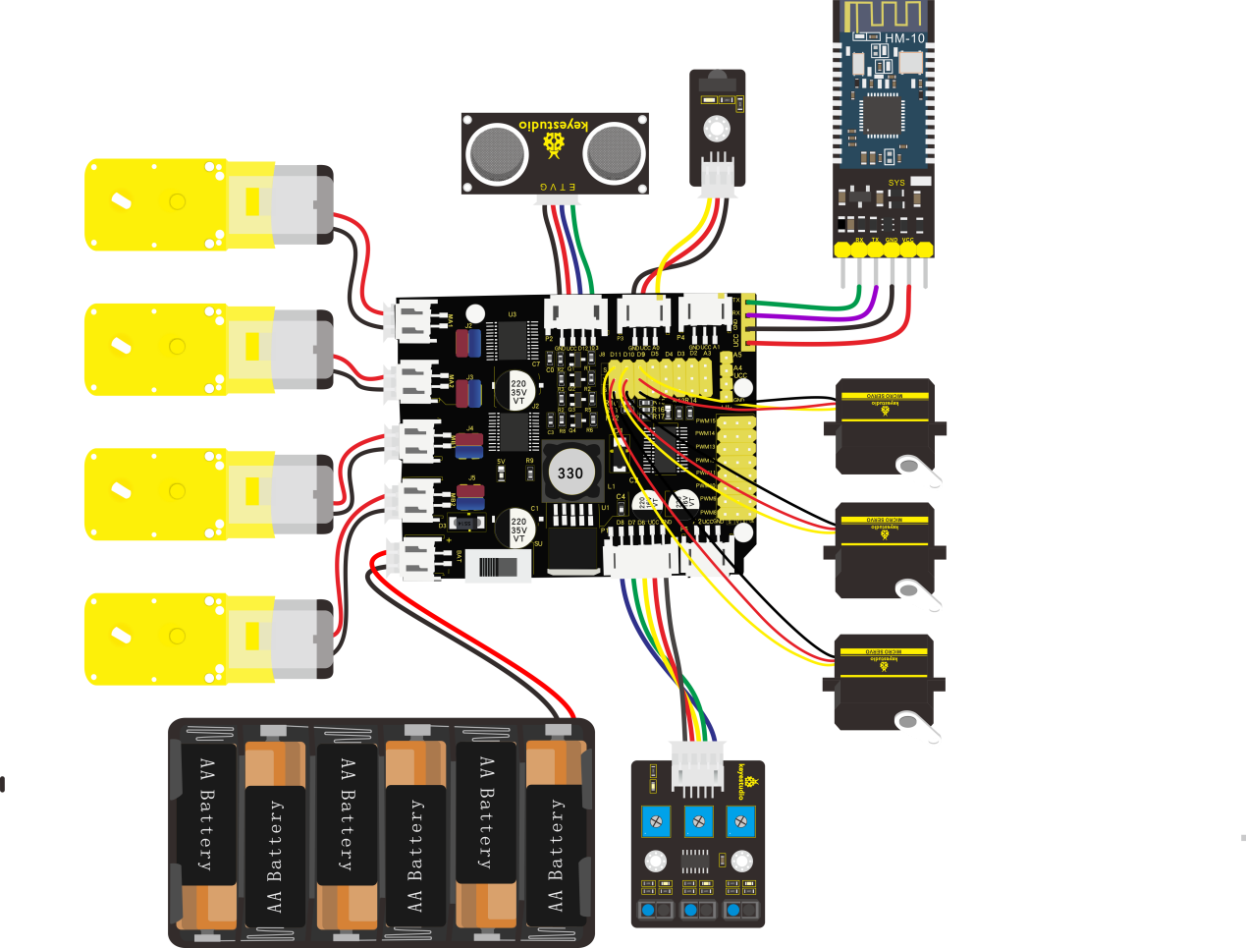
[picture p151: media/970164c98c123e232cb74d65303749a8.png]


#### Test Code：

/\*

keyestudio 4WD Robot Arm Smart Car

lesson 18.1

Multifunctional Robot car

http://www.keyestudio.com

\*/

\##include \<Wire.h\>

\##include \<Adafruit_PWMServoDriver.h\>

Adafruit_PWMServoDriver pwm = Adafruit_PWMServoDriver(0x47);

\##include \<Servo.h\>

\##include \<IRremote.h\>

int RECV_PIN = A0;

int echoPin = 13; // ultrasonic module ECHO to D13

int trigPin = 12; // ultrasonic module TRIG to D12

IRrecv irrecv(RECV_PIN);

decode_results results;

\##define IR_Go 0x00ff629d

\##define IR_Back 0x00ffa857

\##define IR_Left 0x00ff22dd

\##define IR_Right 0x00ffc23d

\##define IR_Stop 0x00ff02fd

\##define SensorLeft 6 //input pin of left sensor

\##define SensorMiddle 7 //input pin of middle sensor

\##define SensorRight 8 //input pin of right sensor

unsigned char SL; //state of left sensor

unsigned char SM; //state of middle sensor

unsigned char SR; //state of right sensor

Servo myservo1;

Servo myservo2;

Servo myservo3;

int k1 = 80, k2 = 120, k3 = 90; //initialize angle value of servo 3

int M1[20], M2[20], M3[20];

int i = 0, j = 0, t = 0, speeds = 2000;

char blue_val;

int Ultrasonic_Ranging() {

digitalWrite(trigPin, LOW);

delayMicroseconds(2);

digitalWrite(trigPin, HIGH);

delayMicroseconds(10);

digitalWrite(trigPin, LOW);

int distance = pulseIn(echoPin, HIGH); // reading the duration of high level

distance = distance / 58; // Transform pulse time to distance

delay(50);

return distance;

}

void setup() {

Serial.begin(9600); //set baud rate to 9600

pwm.begin();

pwm.setPWMFreq(60);

myservo1.attach(11);

myservo2.attach(10);

myservo3.attach(9);

myservo1.write(k1);

delay(1000);

myservo2.write(k2);

delay(1000);

myservo3.write(k3);

delay(1000);

pinMode(SensorLeft, INPUT);

pinMode(SensorMiddle, INPUT);

pinMode(SensorRight, INPUT);

stopp();

irrecv.enableIRIn(); // enable IR receiver

}

void loop() {

if (Serial.available() \> 0) { //receive Bluetooth signals

blue_val = Serial.read();

Serial.println(blue_val);

switch (blue_val) {

case 'F': advance(); Serial.println("advance"); break; //receive‘F’, go forward

case 'B': back(); Serial.println("back"); break; //receive‘B’, go back

case 'L': turnL(); Serial.println("turn left"); break; //receive‘L’, turn left

case 'R': turnR(); Serial.println("turn right"); break; //receive‘R’, turn right

case 'S': stopp(); Serial.println("stop"); break; //receive‘S’, Car stops

case 'a': speeds_a(); break;//receive‘a’, motor speeds up

case 'd': speeds_d(); break;//receive‘d’, motor slows down

case 'f': servo2up(); break; //robots arm lifts up

case 'b': servo2down(); break; //robots arm lowers

case 'l': servo3left(); break; //robot arm turns left

case 'r': servo3right(); break; //robot arm turns right

case 'Q': servo1on(); break; //claw opens

case 'E': servo1off(); break; //claw closes

case 't': read_servo(); break; //receive‘t’, record action

case 'i': do_servo(); break; //receive‘i’, execute motion

case 'Y': avoid(); Serial.println("avoid"); break; //receive‘Y’ to enter the
obstacle avoidance mode

case 'X': tracking(); Serial.println("tracking"); break; //receive‘X’to enter
line tracking mode

case 'U': follow(); Serial.println("follow"); break; //receive‘U’to enter
ultrasonic follow mode

case 'G': Fall(); Serial.println("Fall"); break; //receive‘G’to enter anti-fall
mode

default: break;

}

}

if (irrecv.decode(&results)) { //receive IR signals

switch (results.value) {

case IR_Go: advance(); break;

case IR_Back: back(); break;

case IR_Left: turnL(); break;

case IR_Right: turnR(); break;

case IR_Stop: stopp(); break;

default: break;

}

irrecv.resume(); //

}

}

void advance() // going forwards

{

pwm.setPWM(0, 0, 4095);

pwm.setPWM(1, 0, speeds);

pwm.setPWM(2, 0, 4095);

pwm.setPWM(3, 0, speeds);

pwm.setPWM(4, 0, 4095);

pwm.setPWM(5, 0, speeds);

pwm.setPWM(6, 0, 4095);

pwm.setPWM(7, 0, speeds);

}

void turnR()

{

pwm.setPWM(0, 0, 4095);

pwm.setPWM(1, 0, speeds);

pwm.setPWM(2, 0, 4095);

pwm.setPWM(3, 0, speeds);

pwm.setPWM(4, 0, 0);

pwm.setPWM(5, 0, speeds);

pwm.setPWM(6, 0, 0);

pwm.setPWM(7, 0, speeds);

}

void turnL()

{

pwm.setPWM(0, 0, 0);

pwm.setPWM(1, 0, speeds);

pwm.setPWM(2, 0, 0);

pwm.setPWM(3, 0, speeds);

pwm.setPWM(4, 0, 4095);

pwm.setPWM(5, 0, speeds);

pwm.setPWM(6, 0, 4095);

pwm.setPWM(7, 0, speeds);

}

void stopp() //stop

{

pwm.setPWM(1, 0, 0);

pwm.setPWM(3, 0, 0);

pwm.setPWM(5, 0, 0);

pwm.setPWM(7, 0, 0);

}

void back() //back

{

pwm.setPWM(0, 0, 0);

pwm.setPWM(1, 0, speeds);

pwm.setPWM(2, 0, 0);

pwm.setPWM(3, 0, speeds);

pwm.setPWM(4, 0, 0);

pwm.setPWM(5, 0, speeds);

pwm.setPWM(6, 0, 0);

pwm.setPWM(7, 0, speeds);

}

void speeds_a() {

bool a_flag = 1;

while (a_flag) {

Serial.println(speeds);

if (speeds \<= 2555) { //speed up by 5, set the number to change speed, up to
2560

speeds += 5;

delay(2); //change delay time to alter the speed of smart car

}

if (Serial.read() == 'S') a_flag = 0; //S’to stop speeding up

}

}

void speeds_d() {

bool d_flag = 1;

while (d_flag) {

Serial.println(speeds);

if (speeds \>= 5) { //reduce to 0 at least

speeds -= 5;

delay(2); //change delay time to alter the speed of smart car

}

if (Serial.read() == 'S') d_flag = 0; //receive‘S’to stop slowing down

}

}

void servo1on() { //claw opens

bool servo1on_flag = 1;

while (servo1on_flag) {

k1 -= 1;

myservo1.write(k1);

delay(5);

if (k1 \< 20) {

k1 = 20;

}

if (Serial.read() == 's')servo1on_flag = 0;

}

}

void servo1off() { //claw closes

bool servo1off_flag = 1;

while (servo1off_flag) {

k1 += 1; //control the rotation accuracy

myservo1.write(k1);

delay(5); //control the rotation speed of servo

if (k1 \> 80) {

k1 = 80;

}

if (Serial.read() == 's')servo1off_flag = 0;

}

}

void servo2up() { //robot arm lifts up

bool servo2up_flag = 1;

while (servo2up_flag) {

k2 += 1; //Control the rotation accuracy

myservo2.write(k2);

delay(10); //control rotation speed of servo

if (k2 \> 120) {

k2 = 120;

}

if (Serial.read() == 's')servo2up_flag = 0;

}

}

void servo2down() { //robot arm lowers

bool servo2down_flag = 1;

while (servo2down_flag) {

k2 -= 1; //control the rotation accuracy

myservo2.write(k2);

delay(10); //control the rotation speed of servo

if (k2 \< 10) {

k2 = 10;

}

if (Serial.read() == 's')servo2down_flag = 0;

}

}

void servo3left() { //robot arm turns left

bool servo3left_flag = 1;

while (servo3left_flag) {

k3 += 1; //control the rotation accuracy

myservo3.write(k3);

delay(10); // control the rotation speed of servos

if (k3 \> 180) {

k3 = 180;

}

if (Serial.read() == 's')servo3left_flag = 0;

}

}

void servo3right() { //robot arm turns right

bool servo3right_flag = 1;

while (servo3right_flag) {

k3 -= 1; //control the rotation accuracy

myservo3.write(k3);

delay(10); //control the rotation speed of servos

if (k3 \< 1) {

k3 = 0;

}

if (Serial.read() == 's')servo3right_flag = 0;

}

}

void read_servo() {

M1[i] = myservo1.read(); //save the current angles of servos in array

delay(100); //add delay time to save angle value

M2[i] = myservo2.read();

delay(100);

M3[i] = myservo3.read();

delay(100);

i++; // i adds 1 every time i is saved

j = i; //set the value of i to j

// if(i\>20)i=19;

delay(200);

}

void do_servo() {

i = 0; //i clears 0

t = 1; //used for while loop

k1 = myservo1.read(); //read the current angle value and set them to k1,k2,k3

k2 = myservo2.read();

k3 = myservo3.read();

while (t) {

for (int k = 0; k \< j; k++) { //loop j times to execute all motions saved

if (k1 \< M1[k]) { //if angle value of servo 1 is less than the value saved in
array 1

while (k1 \< M1[k]) { //while loops, make servo rotate where the value saved in
array

myservo1.write(k1); //servo 1 executes actions

k1++; //k1adds 1

delay(10); //delay in 10ms, control the rotation speed of servos

}

}

else { //if the angle of servo 1 is more than the vale saved in array 1.

while (k1 \> M1[k]) { //while loops，make servo rotate the location where the
value is saved in array

myservo1.write(k1); //servo 1 executes actions

k1--; //k1 reduces 1

delay(10); //delay 10ms to control rotation speed of servos

}

}

//the same below

if (k2 \< M2[k]) {

while (k2 \< M2[k]) {

myservo2.write(k2);

k2++;

delay(10);

}

}

else {

while (k2 \> M2[k]) {

myservo2.write(k2);

k2--;

delay(10);

}

}

if (k3 \< M3[k]) {

while (k3 \< M3[k]) {

myservo3.write(k3);

k3++;

delay(10);

}

}

else {

while (k3 \> M3[k]) {

myservo3.write(k3);

k3--;

delay(10);

}

}

if (Serial.available() \> 0) { //in order to exit loop

if (Serial.read() == 't') { //receive‘i’ then‘t’

t = 0; //set t to 0，exit while loop

break; //exit

}

}

}

}

}

void avoid() { //self-going, ultrasonic obstacle avoidance

bool avoid_flag = 1;

while (avoid_flag) {

int distance = Ultrasonic_Ranging();

Serial.print("distance=");

Serial.println(distance);

if (distance \< 30) { //assuming the front distance less than 30cm

if (distance \< 15) { //assuming the front distance less than 15cm

stopp();

delay(100);

back();

delay(300);

}

else { //when 10 \<the distance\<30, turn right

stopp();

delay(100);

turnR();

delay(500);

}

}

else { //when the distance\>30, go forward

advance();

}

blue_val = Serial.read();

if (blue_val == 'S') {

stopp();

avoid_flag = 0;

}

}

}

void tracking(void) { //follow black lines

bool tracking_flag = 1;

while (tracking_flag) {

SL = digitalRead(SensorLeft);

SM = digitalRead(SensorMiddle);

SR = digitalRead(SensorRight);

if (SM == HIGH) {

if (SL == LOW && SR == HIGH) { // black on right, white on left, turn right

turnR();

}

else if (SR == LOW && SL == HIGH) { // black on left, white on right, turn left

turnL();

}

else { // white on both sides, going forward

advance();

}

}

else {

if (SL == LOW && SR == HIGH) { // black on right, white on left, turn right

turnR();

}

else if (SR == LOW && SL == HIGH) { // white on right, black on left, turn left

turnL();

}

else { // all white, stop

stopp() ;

}

}

blue_val = Serial.read();

if (blue_val == 'S') {

stopp();

tracking_flag = 0;

}

}

}

void follow() { //ultrasonic follow

bool follow_flag = 1;

while (follow_flag) {

int distance = Ultrasonic_Ranging();

Serial.print("distance=");

Serial.println(distance);

if (distance \< 15) { //when the distance is less than 15, go back back();

}

else if (distance \>= 15 && distance \< 20) { //when the distance is in 15\~20,
stop

stopp();

}

else if (distance \>= 20 && distance \< 40) { //when the distance is in 20\~40,
go forward

advance();

}

else {

stopp(); //otherwise, stop

}

blue_val = Serial.read();

if (blue_val == 'S') {

stopp();

follow_flag = 0;

}

}

}

void Fall(void) { //anti-fall

bool Fall_flag = 1;

while (Fall_flag) {

SL = digitalRead(SensorLeft);

SM = digitalRead(SensorMiddle);

SR = digitalRead(SensorRight);

if (SM == HIGH \|\| SL == HIGH \|\| SR == HIGH) {

back();

delay(500);

turnL();

delay(500);

}

else {

advance();

}

blue_val = Serial.read();

if (blue_val == 'S') {

stopp();

Fall_flag = 0;

}

}

}

#### Test Result：

After uploading code, we could control the smart arm car to move through App.

## Q&A

1.  **No response on smart car**

A：1. If battery works normally

1.  Make sure you wire up correctly

2.  **Q: Computer can’t identify USB port**

A: Must follow the instruction to install the drive of CP2012 chip(seen in the
Project 5)

Check if USB cable is good.

1.  **Unable to upload code**

1\. Try to burn with V4.0 board(Plug off sensors)

2\. Don’t insert Bluetooth module into expansion board when uploading code,
otherwise, the code fails to be uploaded.

1.  **The direction of car’s movement is different with projects**

A: Make sure you adjusted motors

1.  **The movement of robotic arm seems strange**

A: Make sure that you’ve initialized the servo

1.  **Resource:**

https://fs.keyestudio.com/KS0523
