keyestudio/KS0523-4WD-Mechanical-Robot-Arm-Smart-Car/media/5e0cc80b4e897cb03738a12978b1ad79.png

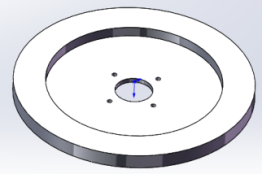
media/5e0cc80b4e897cb03738a12978b1ad79.png
