keyestudio/KS0523-4WD-Mechanical-Robot-Arm-Smart-Car/media/58fb8872794f53e643257ac1f21a7aeb.jpeg

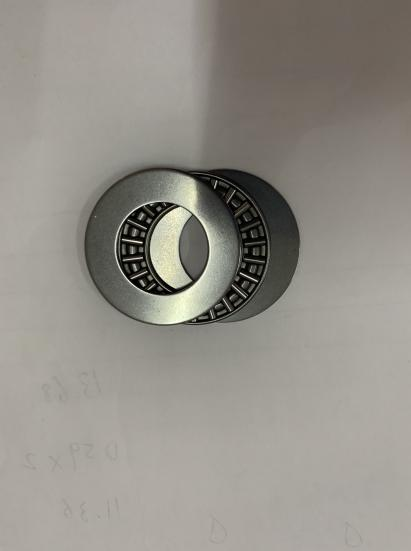
media/58fb8872794f53e643257ac1f21a7aeb.jpeg
