keyestudio/KS0523-4WD-Mechanical-Robot-Arm-Smart-Car/media/2359e851143ccf606844958608e5ce11.png

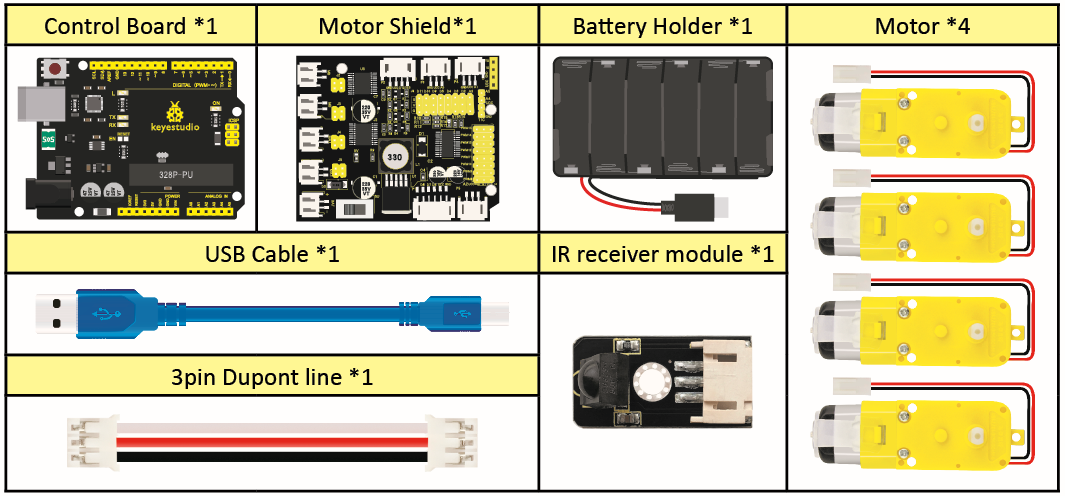
media/2359e851143ccf606844958608e5ce11.png
