keyestudio/KS0523-4WD-Mechanical-Robot-Arm-Smart-Car/media/12097cff8f4a0c51703bd0493f9247c7.png

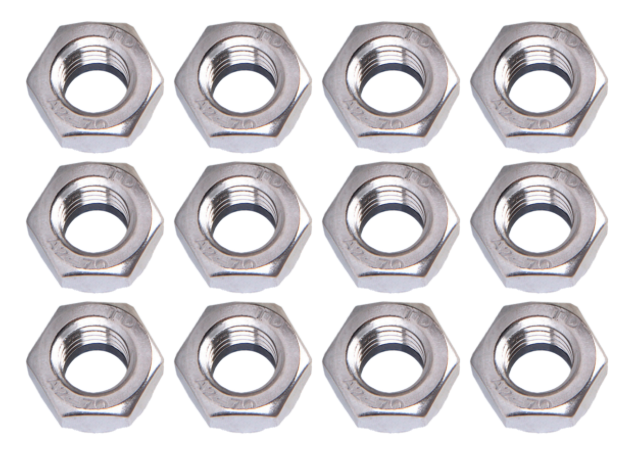
media/12097cff8f4a0c51703bd0493f9247c7.png
