keyestudio/KS0523-4WD-Mechanical-Robot-Arm-Smart-Car/media/b52ca648ec10f30fc7d639f60213cdef.png

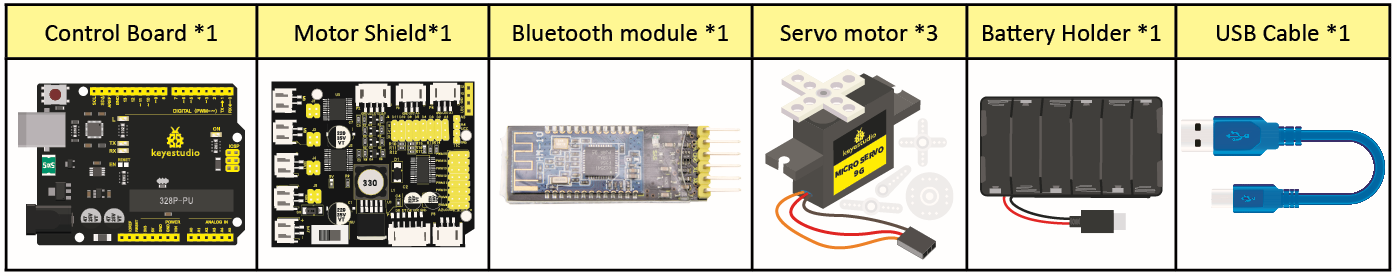
media/b52ca648ec10f30fc7d639f60213cdef.png
