keyestudio/KS0523-4WD-Mechanical-Robot-Arm-Smart-Car/media/fbb1f93916daf8e88e6f769a4fa08429.png

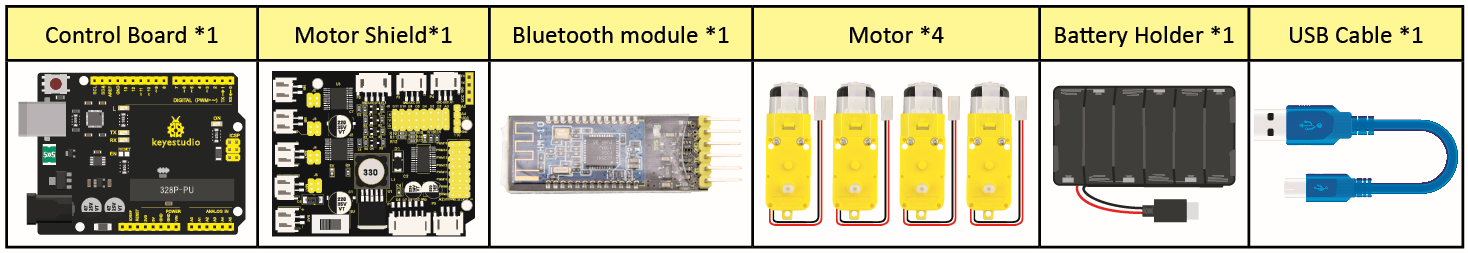
media/fbb1f93916daf8e88e6f769a4fa08429.png
